SheepSupreme/AIAS/README.md

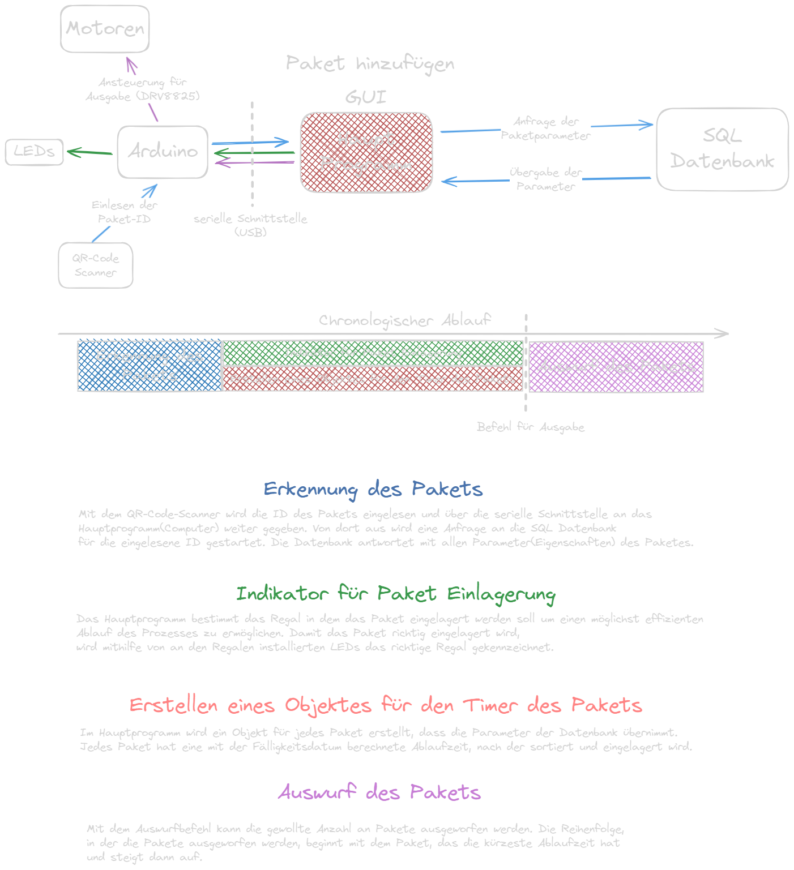
[picture p1: Dokumentationen/bin/Programm_Ablauf.png]
Programm Ablauf
