SheepSupreme/AIAS/Dokumentationen/range drawing.md

---

excalidraw-plugin: parsed
tags: [excalidraw]

---
==⚠  Switch to EXCALIDRAW VIEW in the MORE OPTIONS menu of this document. ⚠==

# Text Elements
Endstop  ^zTHHG58g

Endstop  ^R7NWYyii

Offset
 ^TklU1qga

if(absolute_position < 0 || absolute_position > endstop_position)
{
      out_ofRange();
} ^eQuNVsnZ

Out of range ^91QcKqwy

endstop_position ^cFNqHLJT

If _dir = -1 the maximum range allowed to travel is _endstop_distance and for the case _dir = 1
the max range is _current_position.   ^o1gS66gq

%%
# Drawing
```json
{
	"type": "excalidraw",
	"version": 2,
	"source": "https://github.com/zsviczian/obsidian-excalidraw-plugin/releases/tag/2.0.20",
	"elements": [
		{
			"type": "line",
			"version": 162,
			"versionNonce": 1674994351,
			"isDeleted": false,
			"id": "oIuLg_tYRnJQeL90HluUO",
			"fillStyle": "solid",
			"strokeWidth": 2,
			"strokeStyle": "solid",
			"roughness": 1,
			"opacity": 100,
			"angle": 0,
			"x": -387,
			"y": -297.25,
			"strokeColor": "#1e1e1e",
			"backgroundColor": "transparent",
			"width": 771,
			"height": 4,
			"seed": 1299669665,
			"groupIds": [],
			"frameId": null,
			"roundness": {
				"type": 2
			},
			"boundElements": [],
			"updated": 1707143066376,
			"link": null,
			"locked": false,
			"startBinding": null,
			"endBinding": null,
			"lastCommittedPoint": null,
			"startArrowhead": null,
			"endArrowhead": null,
			"points": [
				[
					0,
					0
				],
				[
					771,
					4
				]
			]
		},
		{
			"type": "rectangle",
			"version": 141,
			"versionNonce": 892969921,
			"isDeleted": false,
			"id": "d77W5BB7zodomcTw8jLMs",
			"fillStyle": "cross-hatch",
			"strokeWidth": 2,
			"strokeStyle": "solid",
			"roughness": 1,
			"opacity": 100,
			"angle": 0,
			"x": 248,
			"y": -317.25,
			"strokeColor": "#ffc9c9",
			"backgroundColor": "#ffc9c9",
			"width": 139,
			"height": 49,
			"seed": 1607139233,
			"groupIds": [],
			"frameId": null,
			"roundness": null,
			"boundElements": [],
			"updated": 1707143066376,
			"link": null,
			"locked": false
		},
		{
			"type": "text",
			"version": 60,
			"versionNonce": 1418005143,
			"isDeleted": false,
			"id": "zTHHG58g",
			"fillStyle": "cross-hatch",
			"strokeWidth": 2,
			"strokeStyle": "solid",
			"roughness": 1,
			"opacity": 100,
			"angle": 0,
			"x": 275,
			"y": -350.25,
			"strokeColor": "#ffc9c9",
			"backgroundColor": "#ffc9c9",
			"width": 87.2999267578125,
			"height": 25,
			"seed": 790835279,
			"groupIds": [],
			"frameId": null,
			"roundness": null,
			"boundElements": [],
			"updated": 1707643829991,
			"link": null,
			"locked": false,
			"fontSize": 20,
			"fontFamily": 1,
			"text": "Endstop ",
			"rawText": "Endstop ",
			"textAlign": "left",
			"verticalAlign": "top",
			"containerId": null,
			"originalText": "Endstop ",
			"lineHeight": 1.25,
			"baseline": 18
		},
		{
			"type": "text",
			"version": 189,
			"versionNonce": 1779945049,
			"isDeleted": false,
			"id": "R7NWYyii",
			"fillStyle": "cross-hatch",
			"strokeWidth": 2,
			"strokeStyle": "solid",
			"roughness": 1,
			"opacity": 100,
			"angle": 0,
			"x": -359.5,
			"y": -348.25,
			"strokeColor": "#ffc9c9",
			"backgroundColor": "#ffc9c9",
			"width": 87.2999267578125,
			"height": 25,
			"seed": 2118448495,
			"groupIds": [],
			"frameId": null,
			"roundness": null,
			"boundElements": [],
			"updated": 1707643829992,
			"link": null,
			"locked": false,
			"fontSize": 20,
			"fontFamily": 1,
			"text": "Endstop ",
			"rawText": "Endstop ",
			"textAlign": "left",
			"verticalAlign": "top",
			"containerId": null,
			"originalText": "Endstop ",
			"lineHeight": 1.25,
			"baseline": 18
		},
		{
			"type": "rectangle",
			"version": 97,
			"versionNonce": 1204994799,
			"isDeleted": false,
			"id": "_ohBsWteYg3jTnqSubWf3",
			"fillStyle": "cross-hatch",
			"strokeWidth": 2,
			"strokeStyle": "solid",
			"roughness": 1,
			"opacity": 100,
			"angle": 0,
			"x": -388,
			"y": -315.25,
			"strokeColor": "#ffc9c9",
			"backgroundColor": "#ffc9c9",
			"width": 133,
			"height": 45,
			"seed": 93808271,
			"groupIds": [],
			"frameId": null,
			"roundness": null,
			"boundElements": [],
			"updated": 1707143066376,
			"link": null,
			"locked": false
		},
		{
			"type": "line",
			"version": 174,
			"versionNonce": 1709336449,
			"isDeleted": false,
			"id": "LmhfvTvm5GQ5eU_dNBUte",
			"fillStyle": "cross-hatch",
			"strokeWidth": 4,
			"strokeStyle": "dotted",
			"roughness": 1,
			"opacity": 100,
			"angle": 0,
			"x": 243,
			"y": -287.25,
			"strokeColor": "#1971c2",
			"backgroundColor": "#ffc9c9",
			"width": 82,
			"height": 0,
			"seed": 608099375,
			"groupIds": [],
			"frameId": null,
			"roundness": null,
			"boundElements": [],
			"updated": 1707143066376,
			"link": null,
			"locked": false,
			"startBinding": null,
			"endBinding": null,
			"lastCommittedPoint": null,
			"startArrowhead": null,
			"endArrowhead": null,
			"points": [
				[
					0,
					0
				],
				[
					-82,
					0
				]
			]
		},
		{
			"type": "line",
			"version": 359,
			"versionNonce": 763006223,
			"isDeleted": false,
			"id": "8YLjzKsIzooisRLqhzNYY",
			"fillStyle": "cross-hatch",
			"strokeWidth": 4,
			"strokeStyle": "dotted",
			"roughness": 1,
			"opacity": 100,
			"angle": 0,
			"x": -166.5,
			"y": -288.0449695687963,
			"strokeColor": "#1971c2",
			"backgroundColor": "#ffc9c9",
			"width": 83,
			"height": 2,
			"seed": 1597740111,
			"groupIds": [],
			"frameId": null,
			"roundness": null,
			"boundElements": [],
			"updated": 1707143066376,
			"link": null,
			"locked": false,
			"startBinding": null,
			"endBinding": null,
			"lastCommittedPoint": null,
			"startArrowhead": null,
			"endArrowhead": null,
			"points": [
				[
					0,
					0
				],
				[
					-83,
					-2
				]
			]
		},
		{
			"type": "line",
			"version": 69,
			"versionNonce": 1728827233,
			"isDeleted": false,
			"id": "zCrVAdLew9wIEg2J9JabZ",
			"fillStyle": "cross-hatch",
			"strokeWidth": 4,
			"strokeStyle": "dashed",
			"roughness": 1,
			"opacity": 100,
			"angle": 0,
			"x": -160,
			"y": -340.25,
			"strokeColor": "#1e1e1e",
			"backgroundColor": "#ffc9c9",
			"width": 1,
			"height": 104,
			"seed": 944194895,
			"groupIds": [],
			"frameId": null,
			"roundness": null,
			"boundElements": [],
			"updated": 1707143066376,
			"link": null,
			"locked": false,
			"startBinding": null,
			"endBinding": null,
			"lastCommittedPoint": null,
			"startArrowhead": null,
			"endArrowhead": null,
			"points": [
				[
					0,
					0
				],
				[
					-1,
					104
				]
			]
		},
		{
			"type": "freedraw",
			"version": 113,
			"versionNonce": 1920809793,
			"isDeleted": false,
			"id": "2Ji5WvS61-Ri51Whbj6XT",
			"fillStyle": "cross-hatch",
			"strokeWidth": 1,
			"strokeStyle": "dashed",
			"roughness": 1,
			"opacity": 100,
			"angle": 0,
			"x": -250,
			"y": -231.25,
			"strokeColor": "#1e1e1e",
			"backgroundColor": "#ffc9c9",
			"width": 92,
			"height": 29,
			"seed": 1982078945,
			"groupIds": [],
			"frameId": null,
			"roundness": null,
			"boundElements": [],
			"updated": 1707143066376,
			"link": null,
			"locked": false,
			"points": [
				[
					0,
					0
				],
				[
					0,
					1
				],
				[
					0,
					2
				],
				[
					0,
					3
				],
				[
					0,
					4
				],
				[
					0,
					5
				],
				[
					0,
					6
				],
				[
					1,
					7
				],
				[
					2,
					8
				],
				[
					3,
					9
				],
				[
					3,
					10
				],
				[
					5,
					10
				],
				[
					6,
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
			"width": 1,
			"height": 104,
			"seed": 712223343,
			"groupIds": [],
			"frameId": null,
			"roundness": null,
			"boundElements": [],
			"updated": 1707143066376,
			"link": null,
			"locked": false,
			"startBinding": null,
			"endBinding": null,
			"lastCommittedPoint": null,
			"startArrowhead": null,
			"endArrowhead": null,
			"points": [
				[
					0,
					0
				],
				[
					-1,
					104
				]
			]
		},
		{
			"type": "text",
			"version": 201,
			"versionNonce": 2057214777,
			"isDeleted": false,
			"id": "eQuNVsnZ",
			"fillStyle": "cross-hatch",
			"strokeWidth": 1,
			"strokeStyle": "dashed",
			"roughness": 1,
			"opacity": 100,
			"angle": 0,
			"x": -383,
			"y": -56.650000000000006,
			"strokeColor": "#1e1e1e",
			"backgroundColor": "#ffc9c9",
			"width": 609.375,
			"height": 76.8,
			"seed": 634649551,
			"groupIds": [],
			"frameId": null,
			"roundness": null,
			"boundElements": [],
			"updated": 1707643829998,
			"link": null,
			"locked": false,
			"fontSize": 16,
			"fontFamily": 3,
			"text": "if(absolute_position < 0 || absolute_position > endstop_position)\n{\n      out_ofRange();\n}",
			"rawText": "if(absolute_position < 0 || absolute_position > endstop_position)\n{\n      out_ofRange();\n}",
			"textAlign": "left",
			"verticalAlign": "top",
			"containerId": null,
			"originalText": "if(absolute_position < 0 || absolute_position > endstop_position)\n{\n      out_ofRange();\n}",
			"lineHeight": 1.2,
			"baseline": 73
		},
		{
			"type": "text",
			"version": 65,
			"versionNonce": 2023133399,
			"isDeleted": false,
			"id": "91QcKqwy",
			"fillStyle": "cross-hatch",
			"strokeWidth": 1,
			"strokeStyle": "dashed",
			"roughness": 1,
			"opacity": 100,
			"angle": 0,
			"x": -135,
			"y": -134.25,
			"strokeColor": "#1e1e1e",
			"backgroundColor": "#ffc9c9",
			"width": 234.39593505859375,
			"height": 45,
			"seed": 1186888687,
			"groupIds": [],
			"frameId": null,
			"roundness": null,
			"boundElements": [],
			"updated": 1707643830000,
			"link": null,
			"locked": false,
			"fontSize": 36,
			"fontFamily": 1,
			"text": "Out of range",
			"rawText": "Out of range",
			"textAlign": "left",
			"verticalAlign": "top",
			"containerId": null,
			"originalText": "Out of range",
			"lineHeight": 1.25,
			"baseline": 31
		},
		{
			"type": "line",
			"version": 147,
			"versionNonce": 290816943,
			"isDeleted": false,
			"id": "g4YbKCmgGmhE3NAX9yFWu",
			"fillStyle": "cross-hatch",
			"strokeWidth": 2,
			"strokeStyle": "solid",
			"roughness": 1,
			"opacity": 100,
			"angle": 0,
			"x": -138,
			"y": -93.25,
			"strokeColor": "#e8590c",
			"backgroundColor": "#ffc9c9",
			"width": 240,
			"height": 2,
			"seed": 2039999887,
			"groupIds": [],
			"frameId": null,
			"roundness": null,
			"boundElements": [],
			"updated": 1707143066376,
			"link": null,
			"locked": false,
			"startBinding": null,
			"endBinding": null,
			"lastCommittedPoint": null,
			"startArrowhead": null,
			"endArrowhead": null,
			"points": [
				[
					0,
					0
				],
				[
					240,
					2
				]
			]
		},
		{
			"type": "text",
			"version": 223,
			"versionNonce": 1853410329,
			"isDeleted": false,
			"id": "cFNqHLJT",
			"fillStyle": "cross-hatch",
			"strokeWidth": 2,
			"strokeStyle": "solid",
			"roughness": 1,
			"opacity": 100,
			"angle": 0,
			"x": 223,
			"y": -210.25,
			"strokeColor": "#e8590c",
			"backgroundColor": "#ffc9c9",
			"width": 187.5,
			"height": 24,
			"seed": 715291215,
			"groupIds": [],
			"frameId": null,
			"roundness": null,
			"boundElements": [
				{
					"id": "nFXw3MjxVTKOJpjb4oJSQ",
					"type": "arrow"
				}
			],
			"updated": 1707643830001,
			"link": null,
			"locked": false,
			"fontSize": 20,
			"fontFamily": 3,
			"text": "endstop_position",
			"rawText": "endstop_position",
			"textAlign": "left",
			"verticalAlign": "top",
			"containerId": null,
			"originalText": "endstop_position",
			"lineHeight": 1.2,
			"baseline": 19
		},
		{
			"type": "arrow",
			"version": 484,
			"versionNonce": 1767600751,
			"isDeleted": false,
			"id": "nFXw3MjxVTKOJpjb4oJSQ",
			"fillStyle": "cross-hatch",
			"strokeWidth": 2,
			"strokeStyle": "solid",
			"roughness": 1,
			"opacity": 100,
			"angle": 0,
			"x": 212,
			"y": -200.24067697268845,
			"strokeColor": "#e8590c",
			"backgroundColor": "#ffc9c9",
			"width": 48,
			"height": 30.009323027311552,
			"seed": 1311047535,
			"groupIds": [],
			"frameId": null,
			"roundness": null,
			"boundElements": [],
			"updated": 1707143131136,
			"link": null,
			"locked": false,
			"startBinding": {
				"elementId": "cFNqHLJT",
				"focus": -0.8992587014644863,
				"gap": 11
			},
			"endBinding": null,
			"lastCommittedPoint": null,
			"startArrowhead": null,
			"endArrowhead": "arrow",
			"points": [
				[
					0,
					0
				],
				[
					-48,
					-30.009323027311552
				]
			]
		},
		{
			"type": "text",
			"version": 394,
			"versionNonce": 1801215479,
			"isDeleted": false,
			"id": "o1gS66gq",
			"fillStyle": "cross-hatch",
			"strokeWidth": 2,
			"strokeStyle": "solid",
			"roughness": 1,
			"opacity": 100,
			"angle": 0,
			"x": -385.3887600885677,
			"y": 39.69395715864888,
			"strokeColor": "#e8590c",
			"backgroundColor": "#ffc9c9",
			"width": 788.7034912109375,
			"height": 40,
			"seed": 1647622977,
			"groupIds": [],
			"frameId": null,
			"roundness": null,
			"boundElements": [],
			"updated": 1707643830005,
			"link": null,
			"locked": false,
			"fontSize": 16,
			"fontFamily": 1,
			"text": "If _dir = -1 the maximum range allowed to travel is _endstop_distance and for the case _dir = 1\nthe max range is _current_position.  ",
			"rawText": "If _dir = -1 the maximum range allowed to travel is _endstop_distance and for the case _dir = 1\nthe max range is _current_position.  ",
			"textAlign": "left",
			"verticalAlign": "top",
			"containerId": null,
			"originalText": "If _dir = -1 the maximum range allowed to travel is _endstop_distance and for the case _dir = 1\nthe max range is _current_position.  ",
			"lineHeight": 1.25,
			"baseline": 34
		}
	],
	"appState": {
		"theme": "dark",
		"viewBackgroundColor": "#ffffff",
		"currentItemStrokeColor": "#e8590c",
		"currentItemBackgroundColor": "#ffc9c9",
		"currentItemFillStyle": "cross-hatch",
		"currentItemStrokeWidth": 2,
		"currentItemStrokeStyle": "solid",
		"currentItemRoughness": 1,
		"currentItemOpacity": 100,
		"currentItemFontFamily": 1,
		"currentItemFontSize": 16,
		"currentItemTextAlign": "left",
		"currentItemStartArrowhead": null,
		"currentItemEndArrowhead": "arrow",
		"scrollX": 415.75465420838447,
		"scrollY": 543.121763791281,
		"zoom": {
			"value": 0.8
		},
		"currentItemRoundness": "sharp",
		"gridSize": null,
		"gridColor": {
			"Bold": "#C9C9C9FF",
			"Regular": "#EDEDEDFF"
		},
		"currentStrokeOptions": null,
		"previousGridSize": null,
		"frameRendering": {
			"enabled": true,
			"clip": true,
			"name": true,
			"outline": true
		}
	},
	"files": {}
}
```
%%
