SheepSupreme/AIAS/Dokumentationen/bin/Regalauslastung.md

---

excalidraw-plugin: parsed
tags: [excalidraw]

---
==⚠  Switch to EXCALIDRAW VIEW in the MORE OPTIONS menu of this document. ⚠==

# Text Elements
66% ^DweSzRlD

100% ^0yQBRq1t

33% ^cCDyKfaw

%%
# Drawing
```json
{
	"type": "excalidraw",
	"version": 2,
	"source": "https://github.com/zsviczian/obsidian-excalidraw-plugin/releases/tag/2.0.20",
	"elements": [
		{
			"id": "iGvxzgqr0_N8F7C8qXwpJ",
			"type": "rectangle",
			"x": -235.20004272460938,
			"y": -203.84374237060547,
			"width": 130.4000244140625,
			"height": 230.39999389648438,
			"angle": 0,
			"strokeColor": "#1e1e1e",
			"backgroundColor": "transparent",
			"fillStyle": "solid",
			"strokeWidth": 2,
			"strokeStyle": "solid",
			"roughness": 1,
			"opacity": 100,
			"groupIds": [],
			"frameId": null,
			"roundness": null,
			"seed": 1994287161,
			"version": 75,
			"versionNonce": 1768070871,
			"isDeleted": false,
			"boundElements": null,
			"updated": 1707647940653,
			"link": null,
			"locked": false
		},
		{
			"type": "rectangle",
			"version": 103,
			"versionNonce": 609369303,
			"isDeleted": false,
			"id": "fiVeXnyyB-yRo90R4QfPz",
			"fillStyle": "solid",
			"strokeWidth": 2,
			"strokeStyle": "solid",
			"roughness": 1,
			"opacity": 100,
			"angle": 0,
			"x": -91.00009155273438,
			"y": -206.44376373291016,
			"strokeColor": "#1e1e1e",
			"backgroundColor": "transparent",
			"width": 130.4000244140625,
			"height": 230.39999389648438,
			"seed": 1012441591,
			"groupIds": [],
			"frameId": null,
			"roundness": null,
			"boundElements": [],
			"updated": 1707647978609,
			"link": null,
			"locked": false
		},
		{
			"type": "rectangle",
			"version": 176,
			"versionNonce": 131553847,
			"isDeleted": false,
			"id": "UOiMkSwHQEAFL999IhhXo",
			"fillStyle": "solid",
			"strokeWidth": 2,
			"strokeStyle": "solid",
			"roughness": 1,
			"opacity": 100,
			"angle": 0,
			"x": 53.800018310546875,
			"y": -205.6437759399414,
			"strokeColor": "#1e1e1e",
			"backgroundColor": "transparent",
			"width": 130.4000244140625,
			"height": 230.39999389648438,
			"seed": 1563676727,
			"groupIds": [],
			"frameId": null,
			"roundness": null,
			"boundElements": [],
			"updated": 1707647945364,
			"link": null,
			"locked": false
		},
		{
			"id": "hxEmUlaA7C-nB6iEJte_a",
			"type": "rectangle",
			"x": -235.20004272460938,
			"y": -107.0437240600586,
			"width": 130.4000244140625,
			"height": 131.199951171875,
			"angle": 0,
			"strokeColor": "#1e1e1e",
			"backgroundColor": "#ffc9c9",
			"fillStyle": "cross-hatch",
			"strokeWidth": 2,
			"strokeStyle": "solid",
			"roughness": 1,
			"opacity": 100,
			"groupIds": [],
			"frameId": null,
			"roundness": null,
			"seed": 1429240119,
			"version": 82,
			"versionNonce": 1476420377,
			"isDeleted": false,
			"boundElements": [
				{
					"type": "text",
					"id": "DweSzRlD"
				}
			],
			"updated": 1707647952353,
			"link": null,
			"locked": false
		},
		{
			"id": "DweSzRlD",
			"type": "text",
			"x": -209.94202423095703,
			"y": -63.943748474121094,
			"width": 79.88398742675781,
			"height": 45,
			"angle": 0,
			"strokeColor": "#1e1e1e",
			"backgroundColor": "#ffc9c9",
			"fillStyle": "cross-hatch",
			"strokeWidth": 2,
			"strokeStyle": "solid",
			"roughness": 1,
			"opacity": 100,
			"groupIds": [],
			"frameId": null,
			"roundness": null,
			"seed": 1705970135,
			"version": 6,
			"versionNonce": 219774103,
			"isDeleted": false,
			"boundElements": null,
			"updated": 1707647957399,
			"link": null,
			"locked": false,
			"text": "66%",
			"rawText": "66%",
			"fontSize": 36,
			"fontFamily": 1,
			"textAlign": "center",
			"verticalAlign": "middle",
			"baseline": 31,
			"containerId": "hxEmUlaA7C-nB6iEJte_a",
			"originalText": "66%",
			"lineHeight": 1.25
		},
		{
			"id": "7SsU3MroDR_LRPZucwRKF",
			"type": "rectangle",
			"x": 55.199981689453125,
			"y": -203.84374237060547,
			"width": 127.20001220703125,
			"height": 229.5999755859375,
			"angle": 0,
			"strokeColor": "#1e1e1e",
			"backgroundColor": "#ffc9c9",
			"fillStyle": "cross-hatch",
			"strokeWidth": 2,
			"strokeStyle": "solid",
			"roughness": 1,
			"opacity": 100,
			"groupIds": [],
			"frameId": null,
			"roundness": null,
			"seed": 1748402903,
			"version": 68,
			"versionNonce": 1632591257,
			"isDeleted": false,
			"boundElements": [
				{
					"type": "text",
					"id": "0yQBRq1t"
				}
			],
			"updated": 1707647971544,
			"link": null,
			"locked": false
		},
		{
			"id": "0yQBRq1t",
			"type": "text",
			"x": 72.25199890136719,
			"y": -111.54375457763672,
			"width": 93.09597778320312,
			"height": 45,
			"angle": 0,
			"strokeColor": "#1e1e1e",
			"backgroundColor": "#ffc9c9",
			"fillStyle": "cross-hatch",
			"strokeWidth": 2,
			"strokeStyle": "solid",
			"roughness": 1,
			"opacity": 100,
			"groupIds": [],
			"frameId": null,
			"roundness": null,
			"seed": 470984535,
			"version": 5,
			"versionNonce": 94682617,
			"isDeleted": false,
			"boundElements": null,
			"updated": 1707647974081,
			"link": null,
			"locked": false,
			"text": "100%",
			"rawText": "100%",
			"fontSize": 36,
			"fontFamily": 1,
			"textAlign": "center",
			"verticalAlign": "middle",
			"baseline": 31,
			"containerId": "7SsU3MroDR_LRPZucwRKF",
			"originalText": "100%",
			"lineHeight": 1.25
		},
		{
			"id": "K8pDpNvs0RcXgGTrhRLzR",
			"type": "rectangle",
			"x": -90.39999389648438,
			"y": -44.643760681152344,
			"width": 127.199951171875,
			"height": 67.20001220703125,
			"angle": 0,
			"strokeColor": "#1e1e1e",
			"backgroundColor": "#ffc9c9",
			"fillStyle": "cross-hatch",
			"strokeWidth": 2,
			"strokeStyle": "solid",
			"roughness": 1,
			"opacity": 100,
			"groupIds": [],
			"frameId": null,
			"roundness": null,
			"seed": 1944859415,
			"version": 54,
			"versionNonce": 2016149785,
			"isDeleted": false,
			"boundElements": [
				{
					"type": "text",
					"id": "cCDyKfaw"
				}
			],
			"updated": 1707648003065,
			"link": null,
			"locked": false
		},
		{
			"id": "cCDyKfaw",
			"type": "text",
			"x": -68.21800994873047,
			"y": -33.54375457763672,
			"width": 82.83598327636719,
			"height": 45,
			"angle": 0,
			"strokeColor": "#1e1e1e",
			"backgroundColor": "#ffc9c9",
			"fillStyle": "cross-hatch",
			"strokeWidth": 2,
			"strokeStyle": "solid",
			"roughness": 1,
			"opacity": 100,
			"groupIds": [],
			"frameId": null,
			"roundness": null,
			"seed": 1242860503,
			"version": 4,
			"versionNonce": 361376921,
			"isDeleted": false,
			"boundElements": null,
			"updated": 1707648005339,
			"link": null,
			"locked": false,
			"text": "33%",
			"rawText": "33%",
			"fontSize": 36,
			"fontFamily": 1,
			"textAlign": "center",
			"verticalAlign": "middle",
			"baseline": 31,
			"containerId": "K8pDpNvs0RcXgGTrhRLzR",
			"originalText": "33%",
			"lineHeight": 1.25
		}
	],
	"appState": {
		"theme": "dark",
		"viewBackgroundColor": "#ffffff",
		"currentItemStrokeColor": "#1e1e1e",
		"currentItemBackgroundColor": "#ffc9c9",
		"currentItemFillStyle": "cross-hatch",
		"currentItemStrokeWidth": 2,
		"currentItemStrokeStyle": "solid",
		"currentItemRoughness": 1,
		"currentItemOpacity": 100,
		"currentItemFontFamily": 1,
		"currentItemFontSize": 36,
		"currentItemTextAlign": "left",
		"currentItemStartArrowhead": null,
		"currentItemEndArrowhead": "arrow",
		"scrollX": 584.2000122070312,
		"scrollY": 371.7562561035156,
		"zoom": {
			"value": 1
		},
		"currentItemRoundness": "sharp",
		"gridSize": null,
		"gridColor": {
			"Bold": "#C9C9C9FF",
			"Regular": "#EDEDEDFF"
		},
		"currentStrokeOptions": null,
		"previousGridSize": null,
		"frameRendering": {
			"enabled": true,
			"clip": true,
			"name": true,
			"outline": true
		}
	},
	"files": {}
}
```
%%
