SheepSupreme/AIAS/conflict-files-obsidian-git.md

# Conflicts
Please resolve them and commit them using the commands `Git: Commit all changes` followed by `Git: Push`
(This file will automatically be deleted before commit)
[[#Additional Instructions]] available below file list

- Not a file: .obsidian/workspace.json
- [[Programm Ablauf]]
- Not a file: sketch_jan10a/AKS/src/.vscode/settings.json
- [[timer.py]]

# Additional Instructions
I strongly recommend to use "Source mode" for viewing the conflicted files. For simple conflicts, in each file listed above replace every occurrence of the following text blocks with the desired text.

```diff
<<<<<<< HEAD
    File changes in local repository
=======
    File changes in remote repository
>>>>>>> origin/main
```
