SheepSupreme/AIAS/Drawing 2024-04-16 21.37.46.excalidraw.md

---

excalidraw-plugin: parsed
tags: [excalidraw]

---
==⚠  Switch to EXCALIDRAW VIEW in the MORE OPTIONS menu of this document. ⚠==

# Text Elements
Annäherungsphase ^f5flp4kH

Sicherheitsabstandeinstellung ^RdX0JzO4

t ^AJXwN7ex

Prellen ^6SSrgGkD

Rückziehungsphase ^0LVD94QP

Flanke erkannt
Schleifenbeginn ^1ofx0jkZ

100ms ^HXgCmdYD

38ms ^nZAon1Bs

DEBOUNCE_DELAY > 100ms
Schleifenende ^42ApAkKs

Dauer des Prellens ^RBMbONDH

%%
# Drawing
```json
{
	"type": "excalidraw",
	"version": 2,
	"source": "https://github.com/zsviczian/obsidian-excalidraw-plugin/releases/tag/2.0.20",
	"elements": [
		{
			"type": "line",
			"version": 763,
			"versionNonce": 1403566506,
			"isDeleted": false,
			"id": "CgW8tRpCIwJtJrZXU7FRV",
			"fillStyle": "solid",
			"strokeWidth": 2,
			"strokeStyle": "dashed",
			"roughness": 0,
			"opacity": 100,
			"angle": 0,
			"x": 238.77804319641035,
			"y": 284.57651348424855,
			"strokeColor": "#1971c2",
			"backgroundColor": "#f08c00",
			"width": 1.8630482314217147,
			"height": 187.38856810940263,
			"seed": 373714934,
			"groupIds": [],
			"frameId": null,
			"roundness": null,
			"boundElements": [],
			"updated": 1713353040744,
			"link": null,
			"locked": false,
			"startBinding": null,
			"endBinding": null,
			"lastCommittedPoint": null,
			"startArrowhead": null,
			"endArrowhead": null,
			"points": [
				[
					0,
					0
				],
				[
					1.8630482314217147,
					187.38856810940263
				]
			]
		},
		{
			"type": "line",
			"version": 153,
			"versionNonce": 597200374,
			"isDeleted": false,
			"id": "wvXh0QOTqUDLNf5rbeEFG",
			"fillStyle": "hachure",
			"strokeWidth": 2,
			"strokeStyle": "solid",
			"roughness": 0,
			"opacity": 100,
			"angle": 0,
			"x": 103.91862260541508,
			"y": 50.493296100001174,
			"strokeColor": "#1971c2",
			"backgroundColor": "transparent",
			"width": 0.27036432340266003,
			"height": 32.984051418469946,
			"seed": 832642963,
			"groupIds": [],
			"frameId": null,
			"roundness": null,
			"boundElements": [],
			"updated": 1713353040744,
			"link": null,
			"locked": false,
			"startBinding": null,
			"endBinding": null,
			"lastCommittedPoint": null,
			"startArrowhead": null,
			"endArrowhead": null,
			"points": [
				[
					0,
					0
				],
				[
					0.27036432340266003,
					-32.984051418469946
				]
			]
		},
		{
			"type": "rectangle",
			"version": 204,
			"versionNonce": 1786246250,
			"isDeleted": false,
			"id": "cpRzqwfpWM3yE4gJYXcSC",
			"fillStyle": "solid",
			"strokeWidth": 4,
			"strokeStyle": "solid",
			"roughness": 0,
			"opacity": 100,
			"angle": 0,
			"x": -286.1653594970703,
			"y": -124.05598449707031,
			"strokeColor": "#1e1e1e",
			"backgroundColor": "transparent",
			"width": 646.6666717529297,
			"height": 40.83332824707031,
			"seed": 1693497267,
			"groupIds": [],
			"frameId": null,
			"roundness": null,
			"boundElements": [],
			"updated": 1713353040744,
			"link": null,
			"locked": false
		},
		{
			"type": "rectangle",
			"version": 688,
			"versionNonce": 276782902,
			"isDeleted": false,
			"id": "OzmO8qNJMEK3aNJf2Xilk",
			"fillStyle": "solid",
			"strokeWidth": 0.5,
			"strokeStyle": "solid",
			"roughness": 0,
			"opacity": 100,
			"angle": 0,
			"x": -286.16535875767585,
			"y": -124.055984,
			"strokeColor": "transparent",
			"backgroundColor": "#ff8787",
			"width": 204.45311575767585,
			"height": 40.312488,
			"seed": 1280888061,
			"groupIds": [],
			"frameId": null,
			"roundness": null,
			"boundElements": [
				{
					"type": "text",
					"id": "f5flp4kH"
				}
			],
			"updated": 1713353040744,
			"link": null,
			"locked": false
		},
		{
			"type": "text",
			"version": 425,
			"versionNonce": 1091688234,
			"isDeleted": false,
			"id": "f5flp4kH",
			"fillStyle": "hachure",
			"strokeWidth": 1,
			"strokeStyle": "solid",
			"roughness": 0,
			"opacity": 100,
			"angle": 0,
			"x": -258.9388008788379,
			"y": -113.49973999999999,
			"strokeColor": "#1e1e1e",
			"backgroundColor": "#2f9e44",
			"width": 150,
			"height": 19.2,
			"seed": 704749043,
			"groupIds": [],
			"frameId": null,
			"roundness": null,
			"boundElements": [],
			"updated": 1713353040744,
			"link": null,
			"locked": false,
			"fontSize": 16,
			"fontFamily": 3,
			"text": "Annäherungsphase",
			"rawText": "Annäherungsphase",
			"textAlign": "center",
			"verticalAlign": "middle",
			"containerId": "OzmO8qNJMEK3aNJf2Xilk",
			"originalText": "Annäherungsphase",
			"lineHeight": 1.2,
			"baseline": 15
		},
		{
			"type": "rectangle",
			"version": 462,
			"versionNonce": 1928988790,
			"isDeleted": false,
			"id": "65dOxuFTLV3p1MlCWzpoy",
			"fillStyle": "solid",
			"strokeWidth": 1,
			"strokeStyle": "solid",
			"roughness": 0,
			"opacity": 100,
			"angle": 0,
			"x": -81.712243,
			"y": -124.055984,
			"strokeColor": "transparent",
			"backgroundColor": "#4dabf7",
			"width": 36.458359,
			"height": 40.31248823535155,
			"seed": 842314899,
			"groupIds": [],
			"frameId": null,
			"roundness": null,
			"boundElements": [],
			"updated": 1713353040744,
			"link": null,
			"locked": false
		},
		{
			"type": "rectangle",
			"version": 458,
			"versionNonce": 1474388458,
			"isDeleted": false,
			"id": "vT7hVDBoANe0V4I83tv5T",
			"fillStyle": "solid",
			"strokeWidth": 0.5,
			"strokeStyle": "solid",
			"roughness": 0,
			"opacity": 100,
			"angle": 0,
			"x": -45.253884,
			"y": -124.055984,
			"strokeColor": "transparent",
			"backgroundColor": "#f08c00",
			"width": 64.434314,
			"height": 40.483390960577154,
			"seed": 1218468349,
			"groupIds": [],
			"frameId": null,
			"roundness": null,
			"boundElements": [
				{
					"id": "SIN99Q6dCiXtwufJJhFK3",
					"type": "arrow"
				}
			],
			"updated": 1713353040744,
			"link": null,
			"locked": false
		},
		{
			"type": "rectangle",
			"version": 500,
			"versionNonce": 449677750,
			"isDeleted": false,
			"id": "-THiHJQGB3vLGRFvAnVFN",
			"fillStyle": "solid",
			"strokeWidth": 0.5,
			"strokeStyle": "solid",
			"roughness": 0,
			"opacity": 100,
			"angle": 0,
			"x": 19.18043,
			"y": -124.055984,
			"strokeColor": "transparent",
			"backgroundColor": "#4dabf7",
			"width": 36.882757999999995,
			"height": 40.312488,
			"seed": 65719101,
			"groupIds": [],
			"frameId": null,
			"roundness": null,
			"boundElements": [],
			"updated": 1713353040744,
			"link": null,
			"locked": false
		},
		{
			"type": "rectangle",
			"version": 240,
			"versionNonce": 1777439914,
			"isDeleted": false,
			"id": "7sAOaXC6pyA4ir2ZvAnz6",
			"fillStyle": "solid",
			"strokeWidth": 0.5,
			"strokeStyle": "solid",
			"roughness": 0,
			"opacity": 100,
			"angle": 0,
			"x": 56.06318799999997,
			"y": -124.055984,
			"strokeColor": "transparent",
			"backgroundColor": "#69db7c",
			"width": 304.438124,
			"height": 40.312488,
			"seed": 704475581,
			"groupIds": [],
			"frameId": null,
			"roundness": null,
			"boundElements": [
				{
					"type": "text",
					"id": "RdX0JzO4"
				}
			],
			"updated": 1713353040744,
			"link": null,
			"locked": false
		},
		{
			"type": "text",
			"version": 214,
			"versionNonce": 387900150,
			"isDeleted": false,
			"id": "RdX0JzO4",
			"fillStyle": "hachure",
			"strokeWidth": 1,
			"strokeStyle": "solid",
			"roughness": 0,
			"opacity": 100,
			"angle": 0,
			"x": 72.34474999999998,
			"y": -113.49973999999999,
			"strokeColor": "#1e1e1e",
			"backgroundColor": "#2f9e44",
			"width": 271.875,
			"height": 19.2,
			"seed": 1102914717,
			"groupIds": [],
			"frameId": null,
			"roundness": null,
			"boundElements": [],
			"updated": 1713353040744,
			"link": null,
			"locked": false,
			"fontSize": 16,
			"fontFamily": 3,
			"text": "Sicherheitsabstandeinstellung",
			"rawText": "Sicherheitsabstandeinstellung",
			"textAlign": "center",
			"verticalAlign": "middle",
			"containerId": "7sAOaXC6pyA4ir2ZvAnz6",
			"originalText": "Sicherheitsabstandeinstellung",
			"lineHeight": 1.2,
			"baseline": 15
		},
		{
			"type": "freedraw",
			"version": 107,
			"versionNonce": 418213738,
			"isDeleted": false,
			"id": "tyoDV9lV7UZh7BQpFheHy",
			"fillStyle": "hachure",
			"strokeWidth": 1,
			"strokeStyle": "solid",
			"roughness": 0,
			"opacity": 100,
			"angle": 0,
			"x": -49.067406149410544,
			"y": -74.79441581100846,
			"strokeColor": "transparent",
			"backgroundColor": "#2f9e44",
			"width": 67.4603271484375,
			"height": 63.492053803943435,
			"seed": 2047059763,
			"groupIds": [],
			"frameId": null,
			"roundness": null,
			"boundElements": [],
			"updated": 1713353040744,
			"link": null,
			"locked": false,
			"points": [
				[
					0,
					0
				],
				[
					0.7936604817708712,
					0
				],
				[
					1.5873209635416856,
					0
				],
				[
					2.380952380952408,
					0
				],
				[
					3.1746128627232224,
					0.793631417410694
				],
				[
					3.968273344494037,
					0.793631417410694
				],
				[
					4.761904761904759,
					2.3809523809523796
				],
				[
					7.142857142857167,
					3.9682442801339164
				],
				[
					7.936517624627982,
					5.555536179315453
				],
				[
					9.523809523809518,
					7.936488560267833
				],
				[
					11.111130487351204,
					10.317440941220212
				],
				[
					11.904761904761926,
					11.904761904761898
				],
				[
					13.492082868303612,
					12.698393322172592
				],
				[
					14.285714285714278,
					13.492053803943435
				],
				[
					14.285714285714278,
					15.079345703124972
				],
				[
					15.873035249255963,
					15.079345703124972
				],
				[
					16.666666666666686,
					15.873006184895814
				],
				[
					18.25398763020837,
					16.666666666666657
				],
				[
					19.047619047619037,
					17.46029808407738
				],
				[
					20.634940011160722,
					17.46029808407738
				],
				[
					21.428571428571445,
					17.46029808407738
				],
				[
					23.809523809523796,
					17.46029808407738
				],
				[
					25.39684477306548,
					18.253958565848194
				],
				[
					26.190476190476204,
					18.253958565848194
				],
				[
					27.77779715401789,
					19.047619047619037
				],
				[
					29.365089053199426,
					19.047619047619037
				],
				[
					30.952380952380963,
					19.84125046502976
				],
				[
					32.53970191592265,
					19.84125046502976
				],
				[
					34.126993815104186,
					19.84125046502976
				],
				[
					35.71428571428572,
					20.634910946800574
				],
				[
					38.09523809523813,
					21.428571428571416
				],
				[
					38.888898577008945,
					21.428571428571416
				],
				[
					40.47619047619048,
					22.22220284598214
				],
				[
					42.85714285714289,
					22.22220284598214
				],
				[
					44.44446382068452,
					22.22220284598214
				],
				[
					45.23809523809524,
					23.015863327752953
				],
				[
					47.61904761904765,
					23.809523809523796
				],
				[
					49.20636858258928,
					23.809523809523796
				],
				[
					50,
					24.60315522693452
				],
				[
					51.587320963541686,
					25.396815708705333
				],
				[
					52.38095238095241,
					26.984107607886898
				],
				[
					53.17461286272322,
					28.571428571428584
				],
				[
					53.96827334449404,
					29.36505998883925
				],
				[
					54.76190476190476,
					30.15872047061012
				],
				[
					55.55556524367563,
					31.746012369791657
				],
				[
					56.349225725446445,
					32.53967285156247
				],
				[
					57.14285714285717,
					34.12696475074401
				],
				[
					57.93651762462798,
					35.714285714285694
				],
				[
					57.93651762462798,
					36.507917131696416
				],
				[
					58.730178106398796,
					36.507917131696416
				],
				[
					59.52380952380952,
					38.0952380952381
				],
				[
					60.31747000558039,
					38.88886951264877
				],
				[
					61.111130487351204,
					40.47619047619045
				],
				[
					61.904761904761926,
					41.269821893601176
				],
				[
					63.492082868303555,
					43.650774274553584
				],
				[
					64.28571428571428,
					45.23809523809521
				],
				[
					65.87303524925596,
					48.41267903645834
				],
				[
					65.87303524925596,
					49.20633951822916
				],
				[
					66.66666666666669,
					50.793631417410694
				],
				[
					66.66666666666669,
					52.38095238095238
				],
				[
					67.4603271484375,
					53.1745837983631
				],
				[
					67.4603271484375,
					54.76190476190473
				],
				[
					67.4603271484375,
					55.55553617931545
				],
				[
					67.4603271484375,
					56.34919666108627
				],
				[
					67.4603271484375,
					57.14285714285714
				],
				[
					67.4603271484375,
					57.93648856026786
				],
				[
					67.4603271484375,
					58.730149042038676
				],
				[
					67.4603271484375,
					59.52380952380949
				],
				[
					67.4603271484375,
					60.31744094122021
				],
				[
					66.66666666666669,
					61.11110142299103
				],
				[
					66.66666666666669,
					61.9047619047619
				],
				[
					66.66666666666669,
					62.69839332217262
				],
				[
					66.66666666666669,
					63.492053803943435
				],
				[
					65.87303524925596,
					63.492053803943435
				],
				[
					65.07937476748515,
					63.492053803943435
				],
				[
					65.07937476748515,
					63.492053803943435
				]
			],
			"lastCommittedPoint": null,
			"simulatePressure": true,
			"pressures": []
		},
		{
			"type": "arrow",
			"version": 1444,
			"versionNonce": 1249055798,
			"isDeleted": false,
			"id": "1VW16dpWHd2BdImqItgEs",
			"fillStyle": "hachure",
			"strokeWidth": 1,
			"strokeStyle": "solid",
			"roughness": 0,
			"opacity": 100,
			"angle": 0,
			"x": -305.9630804858539,
			"y": -133.65898921842845,
			"strokeColor": "#1e1e1e",
			"backgroundColor": "#2f9e44",
			"width": 691.6217394549499,
			"height": 1.3566273428691602,
			"seed": 14492915,
			"groupIds": [],
			"frameId": null,
			"roundness": null,
			"boundElements": [],
			"updated": 1713353040744,
			"link": null,
			"locked": false,
			"startBinding": null,
			"endBinding": {
				"elementId": "AJXwN7ex",
				"focus": 1.417464006836883,
				"gap": 4.0306230314067975
			},
			"lastCommittedPoint": null,
			"startArrowhead": null,
			"endArrowhead": "triangle",
			"points": [
				[
					0,
					0
				],
				[
					691.6217394549499,
					1.3566273428691602
				]
			]
		},
		{
			"type": "text",
			"version": 40,
			"versionNonce": 421524010,
			"isDeleted": false,
			"id": "AJXwN7ex",
			"fillStyle": "hachure",
			"strokeWidth": 1,
			"strokeStyle": "solid",
			"roughness": 0,
			"opacity": 100,
			"angle": 0,
			"x": 386.0363933989654,
			"y": -128.27173884415248,
			"strokeColor": "#1e1e1e",
			"backgroundColor": "#2f9e44",
			"width": 9.375,
			"height": 19.2,
			"seed": 688529651,
			"groupIds": [],
			"frameId": null,
			"roundness": null,
			"boundElements": [
				{
					"id": "1VW16dpWHd2BdImqItgEs",
					"type": "arrow"
				}
			],
			"updated": 1713353040744,
			"link": null,
			"locked": false,
			"fontSize": 16,
			"fontFamily": 3,
			"text": "t",
			"rawText": "t",
			"textAlign": "left",
			"verticalAlign": "top",
			"containerId": null,
			"originalText": "t",
			"lineHeight": 1.2,
			"baseline": 15
		},
		{
			"type": "text",
			"version": 1058,
			"versionNonce": 2125405558,
			"isDeleted": false,
			"id": "6SSrgGkD",
			"fillStyle": "hachure",
			"strokeWidth": 1,
			"strokeStyle": "solid",
			"roughness": 0,
			"opacity": 100,
			"angle": 0,
			"x": -48.68529617723652,
			"y": -54.492760810295465,
			"strokeColor": "#1e1e1e",
			"backgroundColor": "#2f9e44",
			"width": 65.625,
			"height": 19.2,
			"seed": 2064244445,
			"groupIds": [],
			"frameId": null,
			"roundness": null,
			"boundElements": [
				{
					"id": "SIN99Q6dCiXtwufJJhFK3",
					"type": "arrow"
				},
				{
					"id": "HgjzGG4w86GzcN9TFxufE",
					"type": "arrow"
				}
			],
			"updated": 1713353040744,
			"link": null,
			"locked": false,
			"fontSize": 16,
			"fontFamily": 3,
			"text": "Prellen",
			"rawText": "Prellen",
			"textAlign": "left",
			"verticalAlign": "top",
			"containerId": null,
			"originalText": "Prellen",
			"lineHeight": 1.2,
			"baseline": 15
		},
		{
			"type": "text",
			"version": 246,
			"versionNonce": 1567890666,
			"isDeleted": false,
			"id": "0LVD94QP",
			"fillStyle": "hachure",
			"strokeWidth": 1,
			"strokeStyle": "solid",
			"roughness": 0,
			"opacity": 100,
			"angle": 0,
			"x": -104.44637042266035,
			"y": -177.31420152983088,
			"strokeColor": "#1e1e1e",
			"backgroundColor": "#2f9e44",
			"width": 159.375,
			"height": 19.2,
			"seed": 561701523,
			"groupIds": [],
			"frameId": null,
			"roundness": null,
			"boundElements": [
				{
					"id": "CwlVT1xubhBaUoCBKfrFO",
					"type": "arrow"
				}
			],
			"updated": 1713353040744,
			"link": null,
			"locked": false,
			"fontSize": 16,
			"fontFamily": 3,
			"text": "Rückziehungsphase",
			"rawText": "Rückziehungsphase",
			"textAlign": "left",
			"verticalAlign": "top",
			"containerId": null,
			"originalText": "Rückziehungsphase",
			"lineHeight": 1.2,
			"baseline": 15
		},
		{
			"type": "arrow",
			"version": 433,
			"versionNonce": 2031615670,
			"isDeleted": false,
			"id": "CwlVT1xubhBaUoCBKfrFO",
			"fillStyle": "hachure",
			"strokeWidth": 2,
			"strokeStyle": "solid",
			"roughness": 0,
			"opacity": 100,
			"angle": 0,
			"x": -29.381868568522766,
			"y": -152.05389546176417,
			"strokeColor": "#1e1e1e",
			"backgroundColor": "#2f9e44",
			"width": 16.704672151205063,
			"height": 45.880698804974145,
			"seed": 749327603,
			"groupIds": [],
			"frameId": null,
			"roundness": null,
			"boundElements": [],
			"updated": 1713353040744,
			"link": null,
			"locked": false,
			"startBinding": {
				"elementId": "0LVD94QP",
				"focus": 0.12412125492520602,
				"gap": 6.060306068066723
			},
			"endBinding": null,
			"lastCommittedPoint": null,
			"startArrowhead": null,
			"endArrowhead": "triangle",
			"points": [
				[
					0,
					0
				],
				[
					16.704672151205063,
					45.880698804974145
				]
			]
		},
		{
			"type": "arrow",
			"version": 607,
			"versionNonce": 1131737002,
			"isDeleted": false,
			"id": "SIN99Q6dCiXtwufJJhFK3",
			"fillStyle": "hachure",
			"strokeWidth": 2,
			"strokeStyle": "solid",
			"roughness": 0,
			"opacity": 100,
			"angle": 0,
			"x": -12.560105689829996,
			"y": -56.0665584786243,
			"strokeColor": "#1e1e1e",
			"backgroundColor": "#2f9e44",
			"width": 48.386389520173864,
			"height": 47.442144817209936,
			"seed": 347659485,
			"groupIds": [],
			"frameId": null,
			"roundness": null,
			"boundElements": [],
			"updated": 1713353040744,
			"link": null,
			"locked": false,
			"startBinding": {
				"elementId": "JwVG0VW8lpRRcz1jEdepb",
				"focus": 0.42172664963161516,
				"gap": 12.689385305903187
			},
			"endBinding": null,
			"lastCommittedPoint": null,
			"startArrowhead": null,
			"endArrowhead": "triangle",
			"points": [
				[
					0,
					0
				],
				[
					48.386389520173864,
					-47.442144817209936
				]
			]
		},
		{
			"type": "arrow",
			"version": 710,
			"versionNonce": 240302070,
			"isDeleted": false,
			"id": "HgjzGG4w86GzcN9TFxufE",
			"fillStyle": "hachure",
			"strokeWidth": 2,
			"strokeStyle": "solid",
			"roughness": 0,
			"opacity": 100,
			"angle": 0,
			"x": -15.870373375937533,
			"y": -56.34233865159746,
			"strokeColor": "#1e1e1e",
			"backgroundColor": "#2f9e44",
			"width": 46.03046308153567,
			"height": 44.6421798465384,
			"seed": 253428541,
			"groupIds": [],
			"frameId": null,
			"roundness": null,
			"boundElements": [],
			"updated": 1713353040745,
			"link": null,
			"locked": false,
			"startBinding": {
				"elementId": "JwVG0VW8lpRRcz1jEdepb",
				"focus": -0.4802420942891856,
				"gap": 12.41360513293003
			},
			"endBinding": null,
			"lastCommittedPoint": null,
			"startArrowhead": null,
			"endArrowhead": "triangle",
			"points": [
				[
					0,
					0
				],
				[
					-46.03046308153567,
					-44.6421798465384
				]
			]
		},
		{
			"type": "rectangle",
			"version": 452,
			"versionNonce": 1062038122,
			"isDeleted": false,
			"id": "JwVG0VW8lpRRcz1jEdepb",
			"fillStyle": "hachure",
			"strokeWidth": 2,
			"strokeStyle": "dashed",
			"roughness": 0,
			"opacity": 100,
			"angle": 0,
			"x": -86.32363844643717,
			"y": -137.8295913145837,
			"strokeColor": "#1e1e1e",
			"backgroundColor": "transparent",
			"width": 150.62628177889468,
			"height": 69.0736475300562,
			"seed": 507812211,
			"groupIds": [],
			"frameId": null,
			"roundness": null,
			"boundElements": [
				{
					"id": "HgjzGG4w86GzcN9TFxufE",
					"type": "arrow"
				},
				{
					"id": "O4k1kuasB-hDkCA-f-2DO",
					"type": "arrow"
				},
				{
					"id": "CwlVT1xubhBaUoCBKfrFO",
					"type": "arrow"
				},
				{
					"id": "SIN99Q6dCiXtwufJJhFK3",
					"type": "arrow"
				}
			],
			"updated": 1713353040745,
			"link": null,
			"locked": false
		},
		{
			"type": "arrow",
			"version": 1322,
			"versionNonce": 912542006,
			"isDeleted": false,
			"id": "O4k1kuasB-hDkCA-f-2DO",
			"fillStyle": "hachure",
			"strokeWidth": 2,
			"strokeStyle": "dashed",
			"roughness": 0,
			"opacity": 100,
			"angle": 0,
			"x": -85.09027766375307,
			"y": -66.26133154764226,
			"strokeColor": "#1e1e1e",
			"backgroundColor": "transparent",
			"width": 39.281971868240575,
			"height": 68.10181344770004,
			"seed": 1973535581,
			"groupIds": [],
			"frameId": null,
			"roundness": null,
			"boundElements": [],
			"updated": 1713353040745,
			"link": null,
			"locked": false,
			"startBinding": {
				"elementId": "JwVG0VW8lpRRcz1jEdepb",
				"focus": 0.5532287019930913,
				"gap": 2.4946122368852315
			},
			"endBinding": {
				"elementId": "Yb6jPoQsMYy9fHt_kaVjH",
				"focus": -0.5509607092214998,
				"gap": 9.061026386489857
			},
			"lastCommittedPoint": null,
			"startArrowhead": null,
			"endArrowhead": "triangle",
			"points": [
				[
					0,
					0
				],
				[
					-39.281971868240575,
					68.10181344770004
				]
			]
		},
		{
			"type": "rectangle",
			"version": 1085,
			"versionNonce": 130583850,
			"isDeleted": false,
			"id": "Yb6jPoQsMYy9fHt_kaVjH",
			"fillStyle": "hachure",
			"strokeWidth": 2,
			"strokeStyle": "dashed",
			"roughness": 0,
			"opacity": 100,
			"angle": 0,
			"x": -265.03315152164816,
			"y": 10.901508286547639,
			"strokeColor": "#1e1e1e",
			"backgroundColor": "transparent",
			"width": 575.6792291424372,
			"height": 47.74378331357572,
			"seed": 1189669245,
			"groupIds": [],
			"frameId": null,
			"roundness": null,
			"boundElements": [
				{
					"id": "O4k1kuasB-hDkCA-f-2DO",
					"type": "arrow"
				}
			],
			"updated": 1713353040745,
			"link": null,
			"locked": false
		},
		{
			"type": "line",
			"version": 609,
			"versionNonce": 548516470,
			"isDeleted": false,
			"id": "adq4ggL-soCX58L8bXC1H",
			"fillStyle": "hachure",
			"strokeWidth": 2,
			"strokeStyle": "solid",
			"roughness": 0,
			"opacity": 100,
			"angle": 0,
			"x": -199.42298107007244,
			"y": 48.41266561280639,
			"strokeColor": "#1971c2",
			"backgroundColor": "transparent",
			"width": 20.93215672203749,
			"height": 30.343984343205534,
			"seed": 1570393533,
			"groupIds": [],
			"frameId": null,
			"roundness": null,
			"boundElements": [],
			"updated": 1713353040745,
			"link": null,
			"locked": false,
			"startBinding": null,
			"endBinding": null,
			"lastCommittedPoint": null,
			"startArrowhead": null,
			"endArrowhead": null,
			"points": [
				[
					0,
					0
				],
				[
					9.73022707357377,
					-0.27760717350486175
				],
				[
					9.73022707357377,
					-30.343984343205534
				],
				[
					20.389954127163442,
					-30.343984343205534
				],
				[
					20.389954127163442,
					-0.27760717350486175
				],
				[
					20.93215672203749,
					-0.27760717350486175
				]
			]
		},
		{
			"type": "line",
			"version": 616,
			"versionNonce": 1112627178,
			"isDeleted": false,
			"id": "S1gxCwMoBbfI5jiSoMumV",
			"fillStyle": "hachure",
			"strokeWidth": 2,
			"strokeStyle": "solid",
			"roughness": 0,
			"opacity": 100,
			"angle": 0,
			"x": -178.92273982618997,
			"y": 49.15479543516733,
			"strokeColor": "#1971c2",
			"backgroundColor": "transparent",
			"width": 21.959381245857827,
			"height": 30.343984343205534,
			"seed": 1816039101,
			"groupIds": [],
			"frameId": null,
			"roundness": null,
			"boundElements": [],
			"updated": 1713353040745,
			"link": null,
			"locked": false,
			"startBinding": null,
			"endBinding": null,
			"lastCommittedPoint": null,
			"startArrowhead": null,
			"endArrowhead": null,
			"points": [
				[
					0,
					0
				],
				[
					10.207728174155186,
					-0.27760717350486175
				],
				[
					10.207728174155186,
					-30.343984343205534
				],
				[
					21.39057060434388,
					-30.343984343205534
				],
				[
					21.39057060434388,
					-0.27760717350486175
				],
				[
					21.959381245857827,
					-0.27760717350486175
				]
			]
		},
		{
			"type": "line",
			"version": 616,
			"versionNonce": 1207956406,
			"isDeleted": false,
			"id": "0AA9CNotzlz8cGfsE8xUm",
			"fillStyle": "hachure",
			"strokeWidth": 2,
			"strokeStyle": "solid",
			"roughness": 0,
			"opacity": 100,
			"angle": 0,
			"x": -157.65945174473262,
			"y": 49.15483305279372,
			"strokeColor": "#1971c2",
			"backgroundColor": "transparent",
			"width": 21.959381245857827,
			"height": 30.343984343205534,
			"seed": 206009747,
			"groupIds": [],
			"frameId": null,
			"roundness": null,
			"boundElements": [],
			"updated": 1713353040745,
			"link": null,
			"locked": false,
			"startBinding": null,
			"endBinding": null,
			"lastCommittedPoint": null,
			"startArrowhead": null,
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
				],
				[
					51.197775490687526,
					-87.03071944039748
				],
				[
					51.197775490687526,
					-0.7961655975549389
				],
				[
					52.99490554970551,
					-0.7961655975549389
				]
			]
		},
		{
			"type": "line",
			"version": 2341,
			"versionNonce": 749231542,
			"isDeleted": false,
			"id": "nQouDtV_x3Kp5ZljStOV6",
			"fillStyle": "hachure",
			"strokeWidth": 2,
			"strokeStyle": "solid",
			"roughness": 0,
			"opacity": 100,
			"angle": 0,
			"x": 148.84829685477524,
			"y": 438.606160595301,
			"strokeColor": "#1e1e1e",
			"backgroundColor": "transparent",
			"width": 105.28256027207493,
			"height": 87.03076984903596,
			"seed": 1398120886,
			"groupIds": [],
			"frameId": null,
			"roundness": null,
			"boundElements": [],
			"updated": 1713353040745,
			"link": null,
			"locked": false,
			"startBinding": null,
			"endBinding": null,
			"lastCommittedPoint": null,
			"startArrowhead": null,
			"endArrowhead": null,
			"points": [
				[
					0,
					0
				],
				[
					9.963669345390167,
					-0.7962160061934277
				],
				[
					9.963669345390167,
					-87.03076984903596
				],
				[
					73.34105739101365,
					-86.61209531929644
				],
				[
					70.9977027317207,
					-86.776962127975
				],
				[
					105.28256027207493,
					-86.5073906836011
				]
			]
		},
		{
			"id": "rx9JblQjAZm3VGAqsqd-g",
			"type": "line",
			"x": -79.80742255634387,
			"y": 292.1876998356066,
			"width": 0.5359804321310122,
			"height": 187.38874381950978,
			"angle": 0,
			"strokeColor": "#1971c2",
			"backgroundColor": "#f08c00",
			"fillStyle": "solid",
			"strokeWidth": 2,
			"strokeStyle": "dashed",
			"roughness": 0,
			"opacity": 100,
			"groupIds": [],
			"frameId": null,
			"roundness": null,
			"seed": 2040641962,
			"version": 646,
			"versionNonce": 383647914,
			"isDeleted": false,
			"boundElements": null,
			"updated": 1713353040745,
			"link": null,
			"locked": false,
			"points": [
				[
					0,
					0
				],
				[
					-0.5359804321310122,
					187.38874381950978
				]
			],
			"lastCommittedPoint": null,
			"startBinding": null,
			"endBinding": null,
			"startArrowhead": null,
			"endArrowhead": null
		},
		{
			"id": "1ofx0jkZ",
			"type": "text",
			"x": -214.87675089235347,
			"y": 289.2660281157224,
			"width": 128.49609375,
			"height": 35.103985264184054,
			"angle": 0,
			"strokeColor": "#1971c2",
			"backgroundColor": "#f08c00",
			"fillStyle": "solid",
			"strokeWidth": 1,
			"strokeStyle": "dashed",
			"roughness": 0,
			"opacity": 100,
			"groupIds": [],
			"frameId": null,
			"roundness": null,
			"seed": 1957558902,
			"version": 710,
			"versionNonce": 794819306,
			"isDeleted": false,
			"boundElements": null,
			"updated": 1713353208985,
			"link": null,
			"locked": false,
			"text": "Flanke erkannt\nSchleifenbeginn",
			"rawText": "Flanke erkannt\nSchleifenbeginn",
			"fontSize": 14.626660526743356,
			"fontFamily": 3,
			"textAlign": "left",
			"verticalAlign": "top",
			"baseline": 32,
			"containerId": null,
			"originalText": "Flanke erkannt\nSchleifenbeginn",
			"lineHeight": 1.2
		},
		{
			"id": "ClDyy8TLdCZInXTZ_Zu96",
			"type": "arrow",
			"x": 14.898168483416754,
			"y": 333.2836258359197,
			"width": 25.689752700973266,
			"height": 0,
			"angle": 0,
			"strokeColor": "#e03131",
			"backgroundColor": "#f08c00",
			"fillStyle": "solid",
			"strokeWidth": 2,
			"strokeStyle": "solid",
			"roughness": 0,
			"opacity": 100,
			"groupIds": [],
			"frameId": null,
			"roundness": null,
			"seed": 330032874,
			"version": 541,
			"versionNonce": 1164729194,
			"isDeleted": false,
			"boundElements": null,
			"updated": 1713353040745,
			"link": null,
			"locked": false,
			"points": [
				[
					0,
					0
				],
				[
					25.689752700973266,
					0
				]
			],
			"lastCommittedPoint": [
				16.270268625129958,
				0
			],
			"startBinding": null,
			"endBinding": null,
			"startArrowhead": "bar",
			"endArrowhead": "bar"
		},
		{
			"id": "1xHmx43BeJO5g7lvPyMm3",
			"type": "arrow",
			"x": 160.44639564681702,
			"y": 324.2487600411394,
			"width": 78.33176428280935,
			"height": 0.10498898808324664,
			"angle": 0,
			"strokeColor": "#2f9e44",
			"backgroundColor": "#f08c00",
			"fillStyle": "solid",
			"strokeWidth": 2,
			"strokeStyle": "solid",
			"roughness": 0,
			"opacity": 100,
			"groupIds": [],
			"frameId": null,
			"roundness": null,
			"seed": 191402346,
			"version": 610,
			"versionNonce": 1521018934,
			"isDeleted": false,
			"boundElements": null,
			"updated": 1713353040745,
			"link": null,
			"locked": false,
			"points": [
				[
					0,
					0
				],
				[
					78.33176428280935,
					0.10498898808324664
				]
			],
			"lastCommittedPoint": null,
			"startBinding": {
				"elementId": "HXgCmdYD",
				"focus": 1.662543343285454,
				"gap": 15.70528162176069
			},
			"endBinding": null,
			"startArrowhead": "bar",
			"endArrowhead": "bar"
		},
		{
			"id": "HXgCmdYD",
			"type": "text",
			"x": 176.1516772685777,
			"y": 299.49397731882937,
			"width": 45.380859375,
			"height": 18.595509578759238,
			"angle": 0,
			"strokeColor": "#2f9e44",
			"backgroundColor": "#f08c00",
			"fillStyle": "solid",
			"strokeWidth": 2,
			"strokeStyle": "solid",
			"roughness": 0,
			"opacity": 100,
			"groupIds": [],
			"frameId": null,
			"roundness": null,
			"seed": 626532150,
			"version": 297,
			"versionNonce": 1046399286,
			"isDeleted": false,
			"boundElements": [
				{
					"id": "1xHmx43BeJO5g7lvPyMm3",
					"type": "arrow"
				}
			],
			"updated": 1713358360007,
			"link": null,
			"locked": false,
			"text": "100ms",
			"rawText": "100ms",
			"fontSize": 15.496257982299365,
			"fontFamily": 3,
			"textAlign": "left",
			"verticalAlign": "top",
			"baseline": 15,
			"containerId": null,
			"originalText": "100ms",
			"lineHeight": 1.2
		},
		{
			"id": "nZAon1Bs",
			"type": "text",
			"x": 21.5411582652967,
			"y": 265.9419245664073,
			"width": 37.5,
			"height": 19.2,
			"angle": 0,
			"strokeColor": "#e03131",
			"backgroundColor": "#f08c00",
			"fillStyle": "solid",
			"strokeWidth": 2,
			"strokeStyle": "solid",
			"roughness": 0,
			"opacity": 100,
			"groupIds": [],
			"frameId": null,
			"roundness": null,
			"seed": 366875306,
			"version": 110,
			"versionNonce": 822767990,
			"isDeleted": false,
			"boundElements": [
				{
					"id": "EOuTUypDOCjARR0gQOl3b",
					"type": "arrow"
				}
			],
			"updated": 1713353040745,
			"link": null,
			"locked": false,
			"text": "38ms",
			"rawText": "38ms",
			"fontSize": 16,
			"fontFamily": 3,
			"textAlign": "left",
			"verticalAlign": "top",
			"baseline": 15,
			"containerId": null,
			"originalText": "38ms",
			"lineHeight": 1.2
		},
		{
			"id": "EOuTUypDOCjARR0gQOl3b",
			"type": "arrow",
			"x": 35.46419585155729,
			"y": 286.1419245664073,
			"width": 7.6816002209803855,
			"height": 40.387704387362874,
			"angle": 0,
			"strokeColor": "#e03131",
			"backgroundColor": "#f08c00",
			"fillStyle": "solid",
			"strokeWidth": 2,
			"strokeStyle": "solid",
			"roughness": 0,
			"opacity": 100,
			"groupIds": [],
			"frameId": null,
			"roundness": null,
			"seed": 1649863210,
			"version": 111,
			"versionNonce": 271059178,
			"isDeleted": false,
			"boundElements": null,
			"updated": 1713353040745,
			"link": null,
			"locked": false,
			"points": [
				[
					0,
					0
				],
				[
					-7.6816002209803855,
					40.387704387362874
				]
			],
			"lastCommittedPoint": null,
			"startBinding": {
				"elementId": "nZAon1Bs",
				"focus": 0.13661036997806522,
				"gap": 1
			},
			"endBinding": null,
			"startArrowhead": null,
			"endArrowhead": "triangle"
		},
		{
			"id": "42ApAkKs",
			"type": "text",
			"x": 247.7546547675314,
			"y": 435.0204953941784,
			"width": 206.25,
			"height": 38.4,
			"angle": 0,
			"strokeColor": "#1971c2",
			"backgroundColor": "#f08c00",
			"fillStyle": "solid",
			"strokeWidth": 2,
			"strokeStyle": "dashed",
			"roughness": 0,
			"opacity": 100,
			"groupIds": [],
			"frameId": null,
			"roundness": null,
			"seed": 453958506,
			"version": 143,
			"versionNonce": 938936182,
			"isDeleted": false,
			"boundElements": null,
			"updated": 1713353227952,
			"link": null,
			"locked": false,
			"text": "DEBOUNCE_DELAY > 100ms\nSchleifenende",
			"rawText": "DEBOUNCE_DELAY > 100ms\nSchleifenende",
			"fontSize": 16,
			"fontFamily": 3,
			"textAlign": "left",
			"verticalAlign": "top",
			"baseline": 34,
			"containerId": null,
			"originalText": "DEBOUNCE_DELAY > 100ms\nSchleifenende",
			"lineHeight": 1.2
		},
		{
			"id": "yh4u-aZAfmm_8UEr4shIM",
			"type": "arrow",
			"x": -79.8255169118953,
			"y": 500.01923281535477,
			"width": 239.55384707274925,
			"height": 1.3351886618518733,
			"angle": 0,
			"strokeColor": "#f08c00",
			"backgroundColor": "#f08c00",
			"fillStyle": "solid",
			"strokeWidth": 2,
			"strokeStyle": "solid",
			"roughness": 0,
			"opacity": 100,
			"groupIds": [],
			"frameId": null,
			"roundness": null,
			"seed": 492544106,
			"version": 132,
			"versionNonce": 307705130,
			"isDeleted": false,
			"boundElements": null,
			"updated": 1713353275643,
			"link": null,
			"locked": false,
			"points": [
				[
					0,
					0
				],
				[
					239.55384707274925,
					1.3351886618518733
				]
			],
			"lastCommittedPoint": null,
			"startBinding": null,
			"endBinding": null,
			"startArrowhead": "bar",
			"endArrowhead": "bar"
		},
		{
			"id": "RBMbONDH",
			"type": "text",
			"x": -42.94946693476061,
			"y": 507.39446596123594,
			"width": 159.46875,
			"height": 18.146384240848146,
			"angle": 0,
			"strokeColor": "#f08c00",
			"backgroundColor": "#f08c00",
			"fillStyle": "solid",
			"strokeWidth": 2,
			"strokeStyle": "solid",
			"roughness": 0,
			"opacity": 100,
			"groupIds": [],
			"frameId": null,
			"roundness": null,
			"seed": 1917599158,
			"version": 72,
			"versionNonce": 1924533546,
			"isDeleted": false,
			"boundElements": null,
			"updated": 1713358360009,
			"link": null,
			"locked": false,
			"text": "Dauer des Prellens",
			"rawText": "Dauer des Prellens",
			"fontSize": 15.121986867373456,
			"fontFamily": 3,
			"textAlign": "left",
			"verticalAlign": "top",
			"baseline": 14,
			"containerId": null,
			"originalText": "Dauer des Prellens",
			"lineHeight": 1.2
		}
	],
	"appState": {
		"theme": "dark",
		"viewBackgroundColor": "#ffffff",
		"currentItemStrokeColor": "#f08c00",
		"currentItemBackgroundColor": "#f08c00",
		"currentItemFillStyle": "solid",
		"currentItemStrokeWidth": 2,
		"currentItemStrokeStyle": "solid",
		"currentItemRoughness": 0,
		"currentItemOpacity": 100,
		"currentItemFontFamily": 3,
		"currentItemFontSize": 16,
		"currentItemTextAlign": "left",
		"currentItemStartArrowhead": "bar",
		"currentItemEndArrowhead": "bar",
		"scrollX": 692.1575575857237,
		"scrollY": 200.99733240215463,
		"zoom": {
			"value": 1
		},
		"currentItemRoundness": "sharp",
		"gridSize": null,
		"gridColor": {
			"Bold": "#C9C9C9FF",
			"Regular": "#EDEDEDFF"
		},
		"currentStrokeOptions": null,
		"previousGridSize": null,
		"frameRendering": {
			"enabled": true,
			"clip": true,
			"name": true,
			"outline": true
		}
	},
	"files": {}
}
```
%%
