SheepSupreme/AIAS/Dokumentationen/Programm Ablauf.md

---

excalidraw-plugin: parsed
tags: [excalidraw]

---
==⚠  Switch to EXCALIDRAW VIEW in the MORE OPTIONS menu of this document. ⚠==

# Text Elements
Erkennung des Pakets ^DezzMgJv

Erstellen eines Objektes für den Timer des Pakets ^0hfh7Fzg

Indikator für Paket Einlagerung ^HXY5zqoo

Chronologischer Ablauf ^0Bl0e0ep

Auswurf des Pakets ^91xgfZkR

Befehl für Ausgabe ^G4jO4sLS

Erkennung des Pakets ^tA4B3B7l

Mit dem QR-Code-Scanner wird die ID des Pakets eingelesen und über die serielle Schnittstelle an das
Hauptprogramm(Computer) weiter gegeben. Von dort aus wird eine Anfrage an die SQL Datenbank 
für die eingelesene ID gestartet. Die Datenbank antwortet mit allen Parameter(Eigenschaften) des Paketes. 
  ^02Cdh0ey

Indikator für Paket Einlagerung ^G9FhOb90

Im Hauptprogramm wird ein Objekt für jedes Paket erstellt, dass die Parameter der Datenbank übernimmt.
Jedes Paket hat eine mit der Fälligkeitsdatum berechnete Ablaufzeit, nach der sortiert und eingelagert wird. ^y374fQq5

Das Hauptprogramm bestimmt das Regal in dem das Paket eingelagert werden soll um einen möglichst effizienten
Ablauf des Prozesses zu ermöglichen. Damit das Paket richtig eingelagert wird,
wird mithilfe von an den Regalen installierten LEDs das richtige Regal gekennzeichnet. ^UvIh0cjj

Erstellen eines Objektes für den Timer des Pakets ^yW1fCZkD

Auswurf des Pakets ^pecoTU0e

Mit dem Auswurfbefehl kann die gewollte Anzahl an Pakete ausgeworfen werden. Die Reihenfolge,
in der die Pakete ausgeworfen werden, beginnt mit dem Paket, das die kürzeste Ablaufzeit hat 
und steigt dann auf. ^S9WYBtKL

Paket hinzufügen ^G7RuVe72

Haupt
Programm ^et1otK1V

SQL Datenbank ^vRcJmjAX

Arduino ^KNCFgXYO

Anfrage der Paketparameter ^uvXf5KiY

Übergabe der
Parameter ^zABicjzd

GUI ^7X4fgmm2

QR-Code Scanner ^HrtZAPF3

Einlesen der
Paket-ID ^FjNZhNjt

LEDs ^BDpwkr7y

Motoren ^PEwLsrSy

Ansteuerung für Ausgabe (DRV8825) ^8N4p45W7

serielle Schnittstelle
(USB) ^xPRjny8z

%%
# Drawing
```json
{
	"type": "excalidraw",
	"version": 2,
	"source": "https://github.com/zsviczian/obsidian-excalidraw-plugin/releases/tag/2.0.20",
	"elements": [
		{
			"type": "text",
			"version": 602,
			"versionNonce": 1293195750,
			"isDeleted": false,
			"id": "G7RuVe72",
			"fillStyle": "solid",
			"strokeWidth": 2,
			"strokeStyle": "solid",
			"roughness": 1,
			"opacity": 100,
			"angle": 0,
			"x": -292.4396709507664,
			"y": 150.74102709243817,
			"strokeColor": "#1e1e1e",
			"backgroundColor": "transparent",
			"width": 248.98018009628163,
			"height": 37.67405362002328,
			"seed": 1979132791,
			"groupIds": [],
			"frameId": null,
			"roundness": null,
			"boundElements": [],
			"updated": 1713621354702,
			"link": null,
			"locked": false,
			"fontSize": 30.139242896018626,
			"fontFamily": 1,
			"text": "Paket hinzufügen",
			"rawText": "Paket hinzufügen",
			"textAlign": "left",
			"verticalAlign": "top",
			"containerId": null,
			"originalText": "Paket hinzufügen",
			"lineHeight": 1.25,
			"baseline": 26
		},
		{
			"type": "rectangle",
			"version": 802,
			"versionNonce": 1873119526,
			"isDeleted": false,
			"id": "DX3YGNneph1GhbdrnOERN",
			"fillStyle": "solid",
			"strokeWidth": 2,
			"strokeStyle": "solid",
			"roughness": 1,
			"opacity": 100,
			"angle": 0,
			"x": -271.124413080625,
			"y": 241.28355665174155,
			"strokeColor": "#1e1e1e",
			"backgroundColor": "#ff8787",
			"width": 194.9004782732182,
			"height": 117.87791755135392,
			"seed": 2083643447,
			"groupIds": [],
			"frameId": null,
			"roundness": {
				"type": 3
			},
			"boundElements": [
				{
					"type": "text",
					"id": "et1otK1V"
				},
				{
					"id": "dJPqbkuTlPqdhmxXLSDe8",
					"type": "arrow"
				},
				{
					"id": "ESimG3PVmSbPQboZjtUFr",
					"type": "arrow"
				},
				{
					"id": "mHZODtrimTabkH7cpCb4b",
					"type": "arrow"
				},
				{
					"id": "-FZlbg5KfkiH9VtkB2WAV",
					"type": "arrow"
				},
				{
					"id": "rwIKLI6oD7QsZDh410pNX",
					"type": "arrow"
				}
			],
			"updated": 1713621463193,
			"link": null,
			"locked": false
		},
		{
			"type": "text",
			"version": 801,
			"versionNonce": 1727518822,
			"isDeleted": false,
			"id": "et1otK1V",
			"fillStyle": "solid",
			"strokeWidth": 2,
			"strokeStyle": "solid",
			"roughness": 1,
			"opacity": 100,
			"angle": 0,
			"x": -241.60765080531525,
			"y": 262.54846180739526,
			"strokeColor": "#1e1e1e",
			"backgroundColor": "transparent",
			"width": 135.86695372259865,
			"height": 75.34810724004656,
			"seed": 831963479,
			"groupIds": [],
			"frameId": null,
			"roundness": null,
			"boundElements": [],
			"updated": 1713621354702,
			"link": null,
			"locked": false,
			"fontSize": 30.139242896018626,
			"fontFamily": 1,
			"text": "Haupt\nProgramm",
			"rawText": "Haupt\nProgramm",
			"textAlign": "center",
			"verticalAlign": "middle",
			"containerId": "DX3YGNneph1GhbdrnOERN",
			"originalText": "Haupt\nProgramm",
			"lineHeight": 1.25,
			"baseline": 64
		},
		{
			"type": "rectangle",
			"version": 989,
			"versionNonce": 588239846,
			"isDeleted": false,
			"id": "U64DESZmwysDXfMpFwopI",
			"fillStyle": "solid",
			"strokeWidth": 2,
			"strokeStyle": "solid",
			"roughness": 1,
			"opacity": 100,
			"angle": 0,
			"x": 255.41376320640654,
			"y": 235.01145809165638,
			"strokeColor": "#1e1e1e",
			"backgroundColor": "transparent",
			"width": 194.80245419393134,
			"height": 121.39417277563057,
			"seed": 1711439479,
			"groupIds": [],
			"frameId": null,
			"roundness": {
				"type": 3
			},
			"boundElements": [
				{
					"type": "text",
					"id": "vRcJmjAX"
				},
				{
					"id": "dJPqbkuTlPqdhmxXLSDe8",
					"type": "arrow"
				},
				{
					"id": "-FZlbg5KfkiH9VtkB2WAV",
					"type": "arrow"
				}
			],
			"updated": 1713621354702,
			"link": null,
			"locked": false
		},
		{
			"type": "text",
			"version": 1002,
			"versionNonce": 1056466726,
			"isDeleted": false,
			"id": "vRcJmjAX",
			"fillStyle": "solid",
			"strokeWidth": 2,
			"strokeStyle": "solid",
			"roughness": 1,
			"opacity": 100,
			"angle": 0,
			"x": 275.1487614047536,
			"y": 258.0344908594484,
			"strokeColor": "#1e1e1e",
			"backgroundColor": "transparent",
			"width": 155.3324577972372,
			"height": 75.34810724004656,
			"seed": 1278842775,
			"groupIds": [],
			"frameId": null,
			"roundness": null,
			"boundElements": [],
			"updated": 1713621354702,
			"link": null,
			"locked": false,
			"fontSize": 30.139242896018626,
			"fontFamily": 1,
			"text": "SQL\nDatenbank",
			"rawText": "SQL Datenbank",
			"textAlign": "center",
			"verticalAlign": "middle",
			"containerId": "U64DESZmwysDXfMpFwopI",
			"originalText": "SQL Datenbank",
			"lineHeight": 1.25,
			"baseline": 64
		},
		{
			"type": "rectangle",
			"version": 717,
			"versionNonce": 344699110,
			"isDeleted": false,
			"id": "kKFZ5DPW21Cm-cpOk4Iz8",
			"fillStyle": "solid",
			"strokeWidth": 2,
			"strokeStyle": "solid",
			"roughness": 1,
			"opacity": 100,
			"angle": 0,
			"x": -541.473295115661,
			"y": 261.1670388090091,
			"strokeColor": "#1e1e1e",
			"backgroundColor": "transparent",
			"width": 133.0293949643196,
			"height": 76.86994067811689,
			"seed": 1248890039,
			"groupIds": [],
			"frameId": null,
			"roundness": {
				"type": 3
			},
			"boundElements": [
				{
					"type": "text",
					"id": "KNCFgXYO"
				},
				{
					"id": "ESimG3PVmSbPQboZjtUFr",
					"type": "arrow"
				},
				{
					"id": "mHZODtrimTabkH7cpCb4b",
					"type": "arrow"
				},
				{
					"id": "oWP5nrk6GDbH8yyliv-ep",
					"type": "arrow"
				},
				{
					"id": "a-HsaBB_vFEuBm7PWnyAR",
					"type": "arrow"
				},
				{
					"id": "rwIKLI6oD7QsZDh410pNX",
					"type": "arrow"
				},
				{
					"id": "kYlvDfdaNfCjYDqsHAaG6",
					"type": "arrow"
				}
			],
			"updated": 1713621354702,
			"link": null,
			"locked": false
		},
		{
			"type": "text",
			"version": 828,
			"versionNonce": 787522598,
			"isDeleted": false,
			"id": "KNCFgXYO",
			"fillStyle": "solid",
			"strokeWidth": 2,
			"strokeStyle": "solid",
			"roughness": 1,
			"opacity": 100,
			"angle": 0,
			"x": -527.1328299002621,
			"y": 280.7649823380559,
			"strokeColor": "#1e1e1e",
			"backgroundColor": "transparent",
			"width": 104.34846453352186,
			"height": 37.67405362002328,
			"seed": 206298583,
			"groupIds": [],
			"frameId": null,
			"roundness": null,
			"boundElements": [],
			"updated": 1713621354702,
			"link": null,
			"locked": false,
			"fontSize": 30.139242896018626,
			"fontFamily": 1,
			"text": "Arduino",
			"rawText": "Arduino",
			"textAlign": "center",
			"verticalAlign": "middle",
			"containerId": "kKFZ5DPW21Cm-cpOk4Iz8",
			"originalText": "Arduino",
			"lineHeight": 1.25,
			"baseline": 26
		},
		{
			"type": "arrow",
			"version": 2670,
			"versionNonce": 302657830,
			"isDeleted": false,
			"id": "dJPqbkuTlPqdhmxXLSDe8",
			"fillStyle": "solid",
			"strokeWidth": 2,
			"strokeStyle": "solid",
			"roughness": 1,
			"opacity": 100,
			"angle": 0,
			"x": -63.60366929573786,
			"y": 270.5374396491719,
			"strokeColor": "#1971c2",
			"backgroundColor": "transparent",
			"width": 310.1941023693077,
			"height": 11.812441098545444,
			"seed": 1423969015,
			"groupIds": [],
			"frameId": null,
			"roundness": {
				"type": 2
			},
			"boundElements": [
				{
					"type": "text",
					"id": "uvXf5KiY"
				}
			],
			"updated": 1713621391546,
			"link": null,
			"locked": false,
			"startBinding": {
				"elementId": "DX3YGNneph1GhbdrnOERN",
				"focus": -0.40691980581472303,
				"gap": 12.620265511668961
			},
			"endBinding": {
				"elementId": "U64DESZmwysDXfMpFwopI",
				"focus": 0.6370296699783345,
				"gap": 8.823330132836702
			},
			"lastCommittedPoint": null,
			"startArrowhead": null,
			"endArrowhead": "arrow",
			"points": [
				[
					0,
					0
				],
				[
					310.1941023693077,
					-11.812441098545444
				]
			]
		},
		{
			"type": "text",
			"version": 425,
			"versionNonce": 1305308710,
			"isDeleted": false,
			"id": "uvXf5KiY",
			"fillStyle": "cross-hatch",
			"strokeWidth": 2,
			"strokeStyle": "solid",
			"roughness": 1,
			"opacity": 100,
			"angle": 0,
			"x": 12.433425020426398,
			"y": 239.63121909989923,
			"strokeColor": "#1e1e1e",
			"backgroundColor": "transparent",
			"width": 158.11991373697919,
			"height": 50,
			"seed": 1850557975,
			"groupIds": [],
			"frameId": null,
			"roundness": null,
			"boundElements": [],
			"updated": 1713621393425,
			"link": null,
			"locked": false,
			"fontSize": 20,
			"fontFamily": 1,
			"text": "Anfrage der\nPaketparameter",
			"rawText": "Anfrage der Paketparameter",
			"textAlign": "center",
			"verticalAlign": "middle",
			"containerId": "dJPqbkuTlPqdhmxXLSDe8",
			"originalText": "Anfrage der Paketparameter",
			"lineHeight": 1.25,
			"baseline": 42
		},
		{
			"type": "arrow",
			"version": 2100,
			"versionNonce": 1420646330,
			"isDeleted": false,
			"id": "ESimG3PVmSbPQboZjtUFr",
			"fillStyle": "solid",
			"strokeWidth": 2,
			"strokeStyle": "solid",
			"roughness": 1,
			"opacity": 100,
			"angle": 0,
			"x": -281.1918898428262,
			"y": 300.1794874294553,
			"strokeColor": "#2f9e44",
			"backgroundColor": "transparent",
			"width": 116.66728704321143,
			"height": 0.9673505202816548,
			"seed": 280073239,
			"groupIds": [],
			"frameId": null,
			"roundness": {
				"type": 2
			},
			"boundElements": [],
			"updated": 1713621354767,
			"link": null,
			"locked": false,
			"startBinding": {
				"elementId": "DX3YGNneph1GhbdrnOERN",
				"focus": 0.015641204061742946,
				"gap": 10.067476762201181
			},
			"endBinding": {
				"elementId": "kKFZ5DPW21Cm-cpOk4Iz8",
				"focus": 0.05602201462114951,
				"gap": 10.58472326530375
			},
			"lastCommittedPoint": null,
			"startArrowhead": null,
			"endArrowhead": "arrow",
			"points": [
				[
					0,
					0
				],
				[
					-116.66728704321143,
					0.9673505202816548
				]
			]
		},
		{
			"type": "arrow",
			"version": 2096,
			"versionNonce": 1525821754,
			"isDeleted": false,
			"id": "mHZODtrimTabkH7cpCb4b",
			"fillStyle": "solid",
			"strokeWidth": 2,
			"strokeStyle": "solid",
			"roughness": 1,
			"opacity": 100,
			"angle": 0,
			"x": -401.34626495435856,
			"y": 286.84016954148535,
			"strokeColor": "#1971c2",
			"backgroundColor": "transparent",
			"width": 111.00436670420433,
			"height": 2.628091456504159,
			"seed": 666171703,
			"groupIds": [],
			"frameId": null,
			"roundness": {
				"type": 2
			},
			"boundElements": [],
			"updated": 1713621354767,
			"link": null,
			"locked": false,
			"startBinding": {
				"elementId": "kKFZ5DPW21Cm-cpOk4Iz8",
				"focus": -0.27540855831298117,
				"gap": 7.0976351969828215
			},
			"endBinding": {
				"elementId": "DX3YGNneph1GhbdrnOERN",
				"focus": 0.30651089822749594,
				"gap": 19.217485169529255
			},
			"lastCommittedPoint": null,
			"startArrowhead": null,
			"endArrowhead": "arrow",
			"points": [
				[
					0,
					0
				],
				[
					111.00436670420433,
					-2.628091456504159
				]
			]
		},
		{
			"type": "arrow",
			"version": 2493,
			"versionNonce": 1747967738,
			"isDeleted": false,
			"id": "-FZlbg5KfkiH9VtkB2WAV",
			"fillStyle": "solid",
			"strokeWidth": 2,
			"strokeStyle": "solid",
			"roughness": 1,
			"opacity": 100,
			"angle": 6.258108515051162,
			"x": 245.47706774201095,
			"y": 337.2204689062826,
			"strokeColor": "#1971c2",
			"backgroundColor": "transparent",
			"width": 307.76061329921106,
			"height": 6.451076138611293,
			"seed": 256817751,
			"groupIds": [],
			"frameId": null,
			"roundness": {
				"type": 2
			},
			"boundElements": [
				{
					"type": "text",
					"id": "zABicjzd"
				}
			],
			"updated": 1713621387976,
			"link": null,
			"locked": false,
			"startBinding": {
				"elementId": "U64DESZmwysDXfMpFwopI",
				"focus": -0.5017070773620809,
				"gap": 10.053314411732373
			},
			"endBinding": {
				"elementId": "DX3YGNneph1GhbdrnOERN",
				"focus": 0.8268154986636733,
				"gap": 14.08228751183043
			},
			"lastCommittedPoint": null,
			"startArrowhead": null,
			"endArrowhead": "arrow",
			"points": [
				[
					0,
					0
				],
				[
					-307.76061329921106,
					6.451076138611293
				]
			]
		},
		{
			"type": "text",
			"version": 455,
			"versionNonce": 1700441082,
			"isDeleted": false,
			"id": "zABicjzd",
			"fillStyle": "cross-hatch",
			"strokeWidth": 2,
			"strokeStyle": "solid",
			"roughness": 1,
			"opacity": 100,
			"angle": 0,
			"x": 21.669810849621115,
			"y": 312.94600697558826,
			"strokeColor": "#1e1e1e",
			"backgroundColor": "transparent",
			"width": 139.8539004855686,
			"height": 55.00000000000001,
			"seed": 814416823,
			"groupIds": [],
			"frameId": null,
			"roundness": null,
			"boundElements": [],
			"updated": 1713621386595,
			"link": null,
			"locked": false,
			"fontSize": 22,
			"fontFamily": 1,
			"text": "Übergabe der\nParameter",
			"rawText": "Übergabe der\nParameter",
			"textAlign": "center",
			"verticalAlign": "middle",
			"containerId": "-FZlbg5KfkiH9VtkB2WAV",
			"originalText": "Übergabe der\nParameter",
			"lineHeight": 1.25,
			"baseline": 46
		},
		{
			"type": "text",
			"version": 672,
			"versionNonce": 435701734,
			"isDeleted": false,
			"id": "7X4fgmm2",
			"fillStyle": "solid",
			"strokeWidth": 2,
			"strokeStyle": "solid",
			"roughness": 1,
			"opacity": 100,
			"angle": 0,
			"x": -204.84403384549995,
			"y": 201.18125978969215,
			"strokeColor": "#1e1e1e",
			"backgroundColor": "transparent",
			"width": 61.72515401923707,
			"height": 37.67405362002328,
			"seed": 475223927,
			"groupIds": [],
			"frameId": null,
			"roundness": null,
			"boundElements": [],
			"updated": 1713621354702,
			"link": null,
			"locked": false,
			"fontSize": 30.139242896018626,
			"fontFamily": 1,
			"text": "GUI",
			"rawText": "GUI",
			"textAlign": "left",
			"verticalAlign": "top",
			"containerId": null,
			"originalText": "GUI",
			"lineHeight": 1.25,
			"baseline": 26
		},
		{
			"type": "rectangle",
			"version": 880,
			"versionNonce": 938596090,
			"isDeleted": false,
			"id": "bcaraVrTiRy5Y_UCaEmOc",
			"fillStyle": "solid",
			"strokeWidth": 2,
			"strokeStyle": "solid",
			"roughness": 1,
			"opacity": 100,
			"angle": 0,
			"x": -632.7039709636451,
			"y": 459.627054357536,
			"strokeColor": "#1e1e1e",
			"backgroundColor": "transparent",
			"width": 109.69382591893763,
			"height": 66.82570897555868,
			"seed": 1190473305,
			"groupIds": [],
			"frameId": null,
			"roundness": {
				"type": 3
			},
			"boundElements": [
				{
					"type": "text",
					"id": "HrtZAPF3"
				},
				{
					"id": "oWP5nrk6GDbH8yyliv-ep",
					"type": "arrow"
				}
			],
			"updated": 1713621407742,
			"link": null,
			"locked": false
		},
		{
			"type": "text",
			"version": 1066,
			"versionNonce": 1750132666,
			"isDeleted": false,
			"id": "HrtZAPF3",
			"fillStyle": "solid",
			"strokeWidth": 2,
			"strokeStyle": "solid",
			"roughness": 1,
			"opacity": 100,
			"angle": 0,
			"x": -612.2373226747089,
			"y": 472.1098790564135,
			"strokeColor": "#1e1e1e",
			"backgroundColor": "transparent",
			"width": 68.76052934106515,
			"height": 41.860059577803646,
			"seed": 58392727,
			"groupIds": [],
			"frameId": null,
			"roundness": null,
			"boundElements": [],
			"updated": 1713621407742,
			"link": null,
			"locked": false,
			"fontSize": 16.744023831121456,
			"fontFamily": 1,
			"text": "QR-Code\nScanner",
			"rawText": "QR-Code Scanner",
			"textAlign": "center",
			"verticalAlign": "middle",
			"containerId": "bcaraVrTiRy5Y_UCaEmOc",
			"originalText": "QR-Code Scanner",
			"lineHeight": 1.25,
			"baseline": 35
		},
		{
			"type": "arrow",
			"version": 1867,
			"versionNonce": 1727119674,
			"isDeleted": false,
			"id": "oWP5nrk6GDbH8yyliv-ep",
			"fillStyle": "solid",
			"strokeWidth": 2,
			"strokeStyle": "solid",
			"roughness": 1,
			"opacity": 100,
			"angle": 0,
			"x": -585.7691046381738,
			"y": 456.09528381340436,
			"strokeColor": "#1971c2",
			"backgroundColor": "transparent",
			"width": 107.03157710382914,
			"height": 109.02731348976494,
			"seed": 1335944247,
			"groupIds": [],
			"frameId": null,
			"roundness": {
				"type": 2
			},
			"boundElements": [
				{
					"type": "text",
					"id": "FjNZhNjt"
				}
			],
			"updated": 1713621407742,
			"link": null,
			"locked": false,
			"startBinding": {
				"elementId": "bcaraVrTiRy5Y_UCaEmOc",
				"focus": -0.5048292216643347,
				"gap": 3.5317705441316605
			},
			"endBinding": {
				"elementId": "kKFZ5DPW21Cm-cpOk4Iz8",
				"focus": -0.41074114913095483,
				"gap": 9.030990836513467
			},
			"lastCommittedPoint": null,
			"startArrowhead": null,
			"endArrowhead": "arrow",
			"points": [
				[
					0,
					0
				],
				[
					107.03157710382914,
					-109.02731348976494
				]
			]
		},
		{
			"type": "text",
			"version": 348,
			"versionNonce": 1594431034,
			"isDeleted": false,
			"id": "FjNZhNjt",
			"fillStyle": "cross-hatch",
			"strokeWidth": 2,
			"strokeStyle": "solid",
			"roughness": 1,
			"opacity": 100,
			"angle": 0,
			"x": -589.1032482139542,
			"y": 363.6186754083657,
			"strokeColor": "#1e1e1e",
			"backgroundColor": "transparent",
			"width": 115.45989990234375,
			"height": 50,
			"seed": 365643223,
			"groupIds": [],
			"frameId": null,
			"roundness": null,
			"boundElements": [],
			"updated": 1713621407291,
			"link": null,
			"locked": false,
			"fontSize": 20,
			"fontFamily": 1,
			"text": "Einlesen der\nPaket-ID",
			"rawText": "Einlesen der\nPaket-ID",
			"textAlign": "center",
			"verticalAlign": "middle",
			"containerId": "oWP5nrk6GDbH8yyliv-ep",
			"originalText": "Einlesen der\nPaket-ID",
			"lineHeight": 1.25,
			"baseline": 43
		},
		{
			"type": "rectangle",
			"version": 166,
			"versionNonce": 1882186790,
			"isDeleted": false,
			"id": "DKqs3kwQg-4VSJa_oXRo5",
			"fillStyle": "solid",
			"strokeWidth": 2,
			"strokeStyle": "solid",
			"roughness": 1,
			"opacity": 100,
			"angle": 0,
			"x": -681.5431729344335,
			"y": 577.8943585068432,
			"strokeColor": "#1e1e1e",
			"backgroundColor": "#4dabf7",
			"width": 254.10803286733676,
			"height": 88.34217731905281,
			"seed": 1859518231,
			"groupIds": [],
			"frameId": null,
			"roundness": null,
			"boundElements": [
				{
					"type": "text",
					"id": "DezzMgJv"
				},
				{
					"id": "jG0nB1wN1UkGp-tBqzalZ",
					"type": "arrow"
				}
			],
			"updated": 1713621443515,
			"link": null,
			"locked": false
		},
		{
			"type": "text",
			"version": 135,
			"versionNonce": 1194790054,
			"isDeleted": false,
			"id": "DezzMgJv",
			"fillStyle": "cross-hatch",
			"strokeWidth": 2,
			"strokeStyle": "solid",
			"roughness": 1,
			"opacity": 100,
			"angle": 0,
			"x": -649.2271096868003,
			"y": 587.0654471663696,
			"strokeColor": "#1e1e1e",
			"backgroundColor": "#a5d8ff",
			"width": 189.4759063720703,
			"height": 70,
			"seed": 1209379511,
			"groupIds": [],
			"frameId": null,
			"roundness": null,
			"boundElements": [],
			"updated": 1713621266230,
			"link": null,
			"locked": false,
			"fontSize": 28,
			"fontFamily": 1,
			"text": "Erkennung des\nPakets",
			"rawText": "Erkennung des Pakets",
			"textAlign": "center",
			"verticalAlign": "middle",
			"containerId": "DKqs3kwQg-4VSJa_oXRo5",
			"originalText": "Erkennung des Pakets",
			"lineHeight": 1.25,
			"baseline": 59
		},
		{
			"type": "rectangle",
			"version": 228,
			"versionNonce": 1156677562,
			"isDeleted": false,
			"id": "YstAhURYiKSUnJyun8w8C",
			"fillStyle": "solid",
			"strokeWidth": 2,
			"strokeStyle": "solid",
			"roughness": 1,
			"opacity": 100,
			"angle": 0,
			"x": -425.4499893948929,
			"y": 622.6132900550631,
			"strokeColor": "#1e1e1e",
			"backgroundColor": "#ff8787",
			"width": 529.0608104310902,
			"height": 43.12567024312421,
			"seed": 908147223,
			"groupIds": [],
			"frameId": null,
			"roundness": null,
			"boundElements": [
				{
					"type": "text",
					"id": "0hfh7Fzg"
				}
			],
			"updated": 1713621442265,
			"link": null,
			"locked": false
		},
		{
			"type": "text",
			"version": 236,
			"versionNonce": 531405606,
			"isDeleted": false,
			"id": "0hfh7Fzg",
			"fillStyle": "cross-hatch",
			"strokeWidth": 2,
			"strokeStyle": "solid",
			"roughness": 1,
			"opacity": 100,
			"angle": 0,
			"x": -412.389356518215,
			"y": 631.6761251766252,
			"strokeColor": "#1e1e1e",
			"backgroundColor": "#ffc9c9",
			"width": 502.9395446777344,
			"height": 25,
			"seed": 1966547863,
			"groupIds": [],
			"frameId": null,
			"roundness": null,
			"boundElements": [],
			"updated": 1713621266230,
			"link": null,
			"locked": false,
			"fontSize": 20,
			"fontFamily": 1,
			"text": "Erstellen eines Objektes für den Timer des Pakets",
			"rawText": "Erstellen eines Objektes für den Timer des Pakets",
			"textAlign": "center",
			"verticalAlign": "middle",
			"containerId": "YstAhURYiKSUnJyun8w8C",
			"originalText": "Erstellen eines Objektes für den Timer des Pakets",
			"lineHeight": 1.25,
			"baseline": 18
		},
		{
			"type": "rectangle",
			"version": 856,
			"versionNonce": 34641958,
			"isDeleted": false,
			"id": "SmH4pINhsFjNVQr6LIdLk",
			"fillStyle": "cross-hatch",
			"strokeWidth": 2,
			"strokeStyle": "solid",
			"roughness": 1,
			"opacity": 100,
			"angle": 0,
			"x": -707.1155621903035,
			"y": 279.6056675857179,
			"strokeColor": "#1e1e1e",
			"backgroundColor": "transparent",
			"width": 84.76338067763992,
			"height": 40,
			"seed": 872723097,
			"groupIds": [],
			"frameId": null,
			"roundness": {
				"type": 3
			},
			"boundElements": [
				{
					"type": "text",
					"id": "BDpwkr7y"
				},
				{
					"id": "a-HsaBB_vFEuBm7PWnyAR",
					"type": "arrow"
				}
			],
			"updated": 1713621354702,
			"link": null,
			"locked": false
		},
		{
			"type": "text",
			"version": 847,
			"versionNonce": 1104585574,
			"isDeleted": false,
			"id": "BDpwkr7y",
			"fillStyle": "cross-hatch",
			"strokeWidth": 2,
			"strokeStyle": "solid",
			"roughness": 1,
			"opacity": 100,
			"angle": 0,
			"x": -695.1528790199037,
			"y": 284.9546467334866,
			"strokeColor": "#1e1e1e",
			"backgroundColor": "transparent",
			"width": 60.838014336840295,
			"height": 29.30204170446255,
			"seed": 1423890905,
			"groupIds": [],
			"frameId": null,
			"roundness": null,
			"boundElements": [],
			"updated": 1713621354702,
			"link": null,
			"locked": false,
			"fontSize": 23.441633363570038,
			"fontFamily": 1,
			"text": "LEDs",
			"rawText": "LEDs",
			"textAlign": "center",
			"verticalAlign": "middle",
			"containerId": "SmH4pINhsFjNVQr6LIdLk",
			"originalText": "LEDs",
			"lineHeight": 1.25,
			"baseline": 21
		},
		{
			"type": "arrow",
			"version": 1930,
			"versionNonce": 778993082,
			"isDeleted": false,
			"id": "a-HsaBB_vFEuBm7PWnyAR",
			"fillStyle": "cross-hatch",
			"strokeWidth": 2,
			"strokeStyle": "solid",
			"roughness": 1,
			"opacity": 100,
			"angle": 0,
			"x": -550.884945308446,
			"y": 302.09881866870273,
			"strokeColor": "#2f9e44",
			"backgroundColor": "transparent",
			"width": 64.81910056618598,
			"height": 3.869251008882979,
			"seed": 989978169,
			"groupIds": [],
			"frameId": null,
			"roundness": {
				"type": 2
			},
			"boundElements": [],
			"updated": 1713621354767,
			"link": null,
			"locked": false,
			"startBinding": {
				"elementId": "kKFZ5DPW21Cm-cpOk4Iz8",
				"focus": -0.1657590802903405,
				"gap": 9.411650192785032
			},
			"endBinding": {
				"elementId": "SmH4pINhsFjNVQr6LIdLk",
				"focus": -0.1909836259780355,
				"gap": 6.648135638031647
			},
			"lastCommittedPoint": null,
			"startArrowhead": null,
			"endArrowhead": "arrow",
			"points": [
				[
					0,
					0
				],
				[
					-64.81910056618598,
					-3.869251008882979
				]
			]
		},
		{
			"type": "rectangle",
			"version": 286,
			"versionNonce": 2078528102,
			"isDeleted": false,
			"id": "6OFJaRiL8adhm0zJJmJhV",
			"fillStyle": "solid",
			"strokeWidth": 2,
			"strokeStyle": "solid",
			"roughness": 1,
			"opacity": 100,
			"angle": 0,
			"x": -424.705581558469,
			"y": 577.4243977163319,
			"strokeColor": "#1e1e1e",
			"backgroundColor": "#2f9e44",
			"width": 529.0608104310902,
			"height": 43.12567024312421,
			"seed": 1062524153,
			"groupIds": [],
			"frameId": null,
			"roundness": null,
			"boundElements": [
				{
					"type": "text",
					"id": "HXY5zqoo"
				}
			],
			"updated": 1713621440335,
			"link": null,
			"locked": false
		},
		{
			"type": "text",
			"version": 331,
			"versionNonce": 293832358,
			"isDeleted": false,
			"id": "HXY5zqoo",
			"fillStyle": "cross-hatch",
			"strokeWidth": 2,
			"strokeStyle": "solid",
			"roughness": 1,
			"opacity": 100,
			"angle": 0,
			"x": -316.8050591554239,
			"y": 586.487232837894,
			"strokeColor": "#1e1e1e",
			"backgroundColor": "#ffc9c9",
			"width": 313.259765625,
			"height": 25,
			"seed": 1002556889,
			"groupIds": [],
			"frameId": null,
			"roundness": null,
			"boundElements": [],
			"updated": 1713621266230,
			"link": null,
			"locked": false,
			"fontSize": 20,
			"fontFamily": 1,
			"text": "Indikator für Paket Einlagerung",
			"rawText": "Indikator für Paket Einlagerung",
			"textAlign": "center",
			"verticalAlign": "middle",
			"containerId": "6OFJaRiL8adhm0zJJmJhV",
			"originalText": "Indikator für Paket Einlagerung",
			"lineHeight": 1.25,
			"baseline": 18
		},
		{
			"type": "arrow",
			"version": 212,
			"versionNonce": 1923604006,
			"isDeleted": false,
			"id": "jG0nB1wN1UkGp-tBqzalZ",
			"fillStyle": "cross-hatch",
			"strokeWidth": 2,
			"strokeStyle": "solid",
			"roughness": 1,
			"opacity": 100,
			"angle": 0,
			"x": -715.7223566387607,
			"y": 566.0117608834751,
			"strokeColor": "#1e1e1e",
			"backgroundColor": "#2f9e44",
			"width": 1181.6356897493167,
			"height": 1.0213550590110572,
			"seed": 616376537,
			"groupIds": [],
			"frameId": null,
			"roundness": {
				"type": 2
			},
			"boundElements": [],
			"updated": 1713621266230,
			"link": null,
			"locked": false,
			"startBinding": {
				"elementId": "DKqs3kwQg-4VSJa_oXRo5",
				"gap": 11.911282683666741,
				"focus": -1.2690130124471215
			},
			"endBinding": null,
			"lastCommittedPoint": null,
			"startArrowhead": null,
			"endArrowhead": "arrow",
			"points": [
				[
					0,
					0
				],
				[
					1181.6356897493167,
					-1.0213550590110572
				]
			]
		},
		{
			"type": "text",
			"version": 132,
			"versionNonce": 1262083283,
			"isDeleted": false,
			"id": "0Bl0e0ep",
			"fillStyle": "cross-hatch",
			"strokeWidth": 2,
			"strokeStyle": "solid",
			"roughness": 1,
			"opacity": 100,
			"angle": 0,
			"x": -255.7138325022006,
			"y": 525.2860292387904,
			"strokeColor": "#1e1e1e",
			"backgroundColor": "#2f9e44",
			"width": 303.6318664550781,
			"height": 35,
			"seed": 1958836567,
			"groupIds": [],
			"frameId": null,
			"roundness": null,
			"boundElements": [],
			"updated": 1713283990357,
			"link": null,
			"locked": false,
			"fontSize": 28,
			"fontFamily": 1,
			"text": "Chronologischer Ablauf",
			"rawText": "Chronologischer Ablauf",
			"textAlign": "left",
			"verticalAlign": "top",
			"containerId": null,
			"originalText": "Chronologischer Ablauf",
			"lineHeight": 1.25,
			"baseline": 24
		},
		{
			"type": "rectangle",
			"version": 2090,
			"versionNonce": 1119946106,
			"isDeleted": false,
			"id": "3uqd_qDHaKBxe4-C8s80f",
			"fillStyle": "solid",
			"strokeWidth": 2,
			"strokeStyle": "solid",
			"roughness": 1,
			"opacity": 100,
			"angle": 0,
			"x": 116.01860911191898,
			"y": 579.3832877748237,
			"strokeColor": "#1e1e1e",
			"backgroundColor": "#a24db3",
			"width": 306.71636213538955,
			"height": 88.34217731905281,
			"seed": 611948249,
			"groupIds": [],
			"frameId": null,
			"roundness": null,
			"boundElements": [
				{
					"type": "text",
					"id": "91xgfZkR"
				}
			],
			"updated": 1713621432277,
			"link": null,
			"locked": false
		},
		{
			"type": "text",
			"version": 279,
			"versionNonce": 144872742,
			"isDeleted": false,
			"id": "91xgfZkR",
			"fillStyle": "cross-hatch",
			"strokeWidth": 2,
			"strokeStyle": "solid",
			"roughness": 1,
			"opacity": 100,
			"angle": 0,
			"x": 129.53084291398875,
			"y": 606.05437643435,
			"strokeColor": "#1e1e1e",
			"backgroundColor": "#a5d8ff",
			"width": 279.69189453125,
			"height": 35,
			"seed": 112415673,
			"groupIds": [],
			"frameId": null,
			"roundness": null,
			"boundElements": [],
			"updated": 1713621266230,
			"link": null,
			"locked": false,
			"fontSize": 28,
			"fontFamily": 1,
			"text": "Auswurf des Pakets",
			"rawText": "Auswurf des Pakets",
			"textAlign": "center",
			"verticalAlign": "middle",
			"containerId": "3uqd_qDHaKBxe4-C8s80f",
			"originalText": "Auswurf des Pakets",
			"lineHeight": 1.25,
			"baseline": 24
		},
		{
			"type": "arrow",
			"version": 1802,
			"versionNonce": 1730271034,
			"isDeleted": false,
			"id": "rwIKLI6oD7QsZDh410pNX",
			"fillStyle": "cross-hatch",
			"strokeWidth": 2,
			"strokeStyle": "solid",
			"roughness": 1,
			"opacity": 100,
			"angle": 0,
			"x": -281.63646638929526,
			"y": 314.1380543811083,
			"strokeColor": "#ac60bb",
			"backgroundColor": "#a24db3",
			"width": 114.67992764746133,
			"height": 1.838572989659623,
			"seed": 1420144151,
			"groupIds": [],
			"frameId": null,
			"roundness": {
				"type": 2
			},
			"boundElements": [],
			"updated": 1713621354767,
			"link": null,
			"locked": false,
			"startBinding": {
				"elementId": "DX3YGNneph1GhbdrnOERN",
				"focus": -0.20139508028569023,
				"gap": 10.51205330867026
			},
			"endBinding": {
				"elementId": "kKFZ5DPW21Cm-cpOk4Iz8",
				"focus": 0.4464512629956661,
				"gap": 12.127506114584776
			},
			"lastCommittedPoint": null,
			"startArrowhead": null,
			"endArrowhead": "arrow",
			"points": [
				[
					0,
					0
				],
				[
					-114.67992764746133,
					1.838572989659623
				]
			]
		},
		{
			"type": "rectangle",
			"version": 1096,
			"versionNonce": 575696762,
			"isDeleted": false,
			"id": "S_w9dui95pts119_kV0Dv",
			"fillStyle": "cross-hatch",
			"strokeWidth": 2,
			"strokeStyle": "solid",
			"roughness": 1,
			"opacity": 100,
			"angle": 0,
			"x": -609.0094558623721,
			"y": 34.86518616592366,
			"strokeColor": "#1e1e1e",
			"backgroundColor": "transparent",
			"width": 130.46913883547558,
			"height": 68.97415363929555,
			"seed": 1630399319,
			"groupIds": [],
			"frameId": null,
			"roundness": {
				"type": 3
			},
			"boundElements": [
				{
					"type": "text",
					"id": "PEwLsrSy"
				},
				{
					"id": "kYlvDfdaNfCjYDqsHAaG6",
					"type": "arrow"
				}
			],
			"updated": 1713621406408,
			"link": null,
			"locked": false
		},
		{
			"type": "text",
			"version": 1203,
			"versionNonce": 742944826,
			"isDeleted": false,
			"id": "PEwLsrSy",
			"fillStyle": "cross-hatch",
			"strokeWidth": 2,
			"strokeStyle": "solid",
			"roughness": 1,
			"opacity": 100,
			"angle": 0,
			"x": -602.2769186580271,
			"y": 50.51523617555979,
			"strokeColor": "#1e1e1e",
			"backgroundColor": "transparent",
			"width": 117.00406442678552,
			"height": 37.67405362002328,
			"seed": 1563605591,
			"groupIds": [],
			"frameId": null,
			"roundness": null,
			"boundElements": [],
			"updated": 1713621406408,
			"link": null,
			"locked": false,
			"fontSize": 30.139242896018626,
			"fontFamily": 1,
			"text": "Motoren",
			"rawText": "Motoren",
			"textAlign": "center",
			"verticalAlign": "middle",
			"containerId": "S_w9dui95pts119_kV0Dv",
			"originalText": "Motoren",
			"lineHeight": 1.25,
			"baseline": 26
		},
		{
			"type": "arrow",
			"version": 2742,
			"versionNonce": 1610688954,
			"isDeleted": false,
			"id": "kYlvDfdaNfCjYDqsHAaG6",
			"fillStyle": "cross-hatch",
			"strokeWidth": 2,
			"strokeStyle": "solid",
			"roughness": 1,
			"opacity": 100,
			"angle": 0,
			"x": -476.4970555485426,
			"y": 253.3712168211327,
			"strokeColor": "#ac60bb",
			"backgroundColor": "transparent",
			"width": 42.291433014047755,
			"height": 141.22169161804413,
			"seed": 741530681,
			"groupIds": [],
			"frameId": null,
			"roundness": {
				"type": 2
			},
			"boundElements": [
				{
					"type": "text",
					"id": "8N4p45W7"
				}
			],
			"updated": 1713621406409,
			"link": null,
			"locked": false,
			"startBinding": {
				"elementId": "kKFZ5DPW21Cm-cpOk4Iz8",
				"focus": 0.15932289672798275,
				"gap": 7.795821987876451
			},
			"endBinding": {
				"elementId": "S_w9dui95pts119_kV0Dv",
				"focus": -0.16105863726582217,
				"gap": 8.310185397869333
			},
			"lastCommittedPoint": null,
			"startArrowhead": null,
			"endArrowhead": "arrow",
			"points": [
				[
					0,
					0
				],
				[
					-42.291433014047755,
					-141.22169161804413
				]
			]
		},
		{
			"type": "text",
			"version": 368,
			"versionNonce": 1365488826,
			"isDeleted": false,
			"id": "8N4p45W7",
			"fillStyle": "cross-hatch",
			"strokeWidth": 2,
			"strokeStyle": "solid",
			"roughness": 1,
			"opacity": 100,
			"angle": 0,
			"x": -605.9848596036967,
			"y": 181.83443378337796,
			"strokeColor": "#1e1e1e",
			"backgroundColor": "transparent",
			"width": 201.55984497070312,
			"height": 50,
			"seed": 1111654871,
			"groupIds": [],
			"frameId": null,
			"roundness": null,
			"boundElements": [],
			"updated": 1713621405994,
			"link": null,
			"locked": false,
			"fontSize": 20,
			"fontFamily": 1,
			"text": "Ansteuerung für\nAusgabe (DRV8825)",
			"rawText": "Ansteuerung für Ausgabe (DRV8825)",
			"textAlign": "center",
			"verticalAlign": "middle",
			"containerId": "kYlvDfdaNfCjYDqsHAaG6",
			"originalText": "Ansteuerung für Ausgabe (DRV8825)",
			"lineHeight": 1.25,
			"baseline": 43
		},
		{
			"type": "line",
			"version": 134,
			"versionNonce": 1247551742,
			"isDeleted": false,
			"id": "6Ic4jeUviPgZBXNddC4EE",
			"fillStyle": "cross-hatch",
			"strokeWidth": 4,
			"strokeStyle": "dashed",
			"roughness": 1,
			"opacity": 100,
			"angle": 0,
			"x": 109.5666138382071,
			"y": 532.2343405793366,
			"strokeColor": "#1e1e1e",
			"backgroundColor": "transparent",
			"width": 2.2737367544323206e-13,
			"height": 172.71405329369702,
			"seed": 504445625,
			"groupIds": [],
			"frameId": null,
			"roundness": {
				"type": 2
			},
			"boundElements": [],
			"updated": 1707804240168,
			"link": null,
			"locked": false,
			"startBinding": null,
			"endBinding": null,
			"lastCommittedPoint": null,
			"startArrowhead": null,
			"endArrowhead": null,
			"points": [
				[
					0,
					0
				],
				[
					2.2737367544323206e-13,
					172.71405329369702
				]
			]
		},
		{
			"type": "text",
			"version": 173,
			"versionNonce": 58543581,
			"isDeleted": false,
			"id": "G4jO4sLS",
			"fillStyle": "cross-hatch",
			"strokeWidth": 4,
			"strokeStyle": "dashed",
			"roughness": 1,
			"opacity": 100,
			"angle": 0,
			"x": 23.209473596226644,
			"y": 716.8596765567004,
			"strokeColor": "#1e1e1e",
			"backgroundColor": "transparent",
			"width": 189.6598358154297,
			"height": 25,
			"seed": 105935321,
			"groupIds": [],
			"frameId": null,
			"roundness": null,
			"boundElements": [],
			"updated": 1713283990357,
			"link": null,
			"locked": false,
			"fontSize": 20,
			"fontFamily": 1,
			"text": "Befehl für Ausgabe",
			"rawText": "Befehl für Ausgabe",
			"textAlign": "left",
			"verticalAlign": "top",
			"containerId": null,
			"originalText": "Befehl für Ausgabe",
			"lineHeight": 1.25,
			"baseline": 18
		},
		{
			"type": "text",
			"version": 188,
			"versionNonce": 2016201331,
			"isDeleted": false,
			"id": "tA4B3B7l",
			"fillStyle": "cross-hatch",
			"strokeWidth": 4,
			"strokeStyle": "dashed",
			"roughness": 1,
			"opacity": 100,
			"angle": 0,
			"x": -352.7115761070668,
			"y": 817.6989749606755,
			"strokeColor": "#6899db",
			"backgroundColor": "transparent",
			"width": 386.5318908691406,
			"height": 45,
			"seed": 1801898713,
			"groupIds": [],
			"frameId": null,
			"roundness": null,
			"boundElements": [],
			"updated": 1713283990358,
			"link": null,
			"locked": false,
			"fontSize": 36,
			"fontFamily": 1,
			"text": "Erkennung des Pakets",
			"rawText": "Erkennung des Pakets",
			"textAlign": "left",
			"verticalAlign": "top",
			"containerId": null,
			"originalText": "Erkennung des Pakets",
			"lineHeight": 1.25,
			"baseline": 32
		},
		{
			"type": "line",
			"version": 557,
			"versionNonce": 370171238,
			"isDeleted": false,
			"id": "0nkB1y4lMFuZ9I8tCZUSZ",
			"fillStyle": "cross-hatch",
			"strokeWidth": 4,
			"strokeStyle": "dashed",
			"roughness": 1,
			"opacity": 100,
			"angle": 0,
			"x": -342.3004980320417,
			"y": 227.609770475411,
			"strokeColor": "#1e1e1e",
			"backgroundColor": "transparent",
			"width": 0,
			"height": 152.07551625775764,
			"seed": 2056949367,
			"groupIds": [],
			"frameId": null,
			"roundness": {
				"type": 2
			},
			"boundElements": [],
			"updated": 1713621354702,
			"link": null,
			"locked": false,
			"startBinding": null,
			"endBinding": null,
			"lastCommittedPoint": null,
			"startArrowhead": null,
			"endArrowhead": null,
			"points": [
				[
					0,
					0
				],
				[
					0,
					152.07551625775764
				]
			]
		},
		{
			"type": "text",
			"version": 1068,
			"versionNonce": 263259155,
			"isDeleted": false,
			"id": "02Cdh0ey",
			"fillStyle": "cross-hatch",
			"strokeWidth": 4,
			"strokeStyle": "dashed",
			"roughness": 1,
			"opacity": 100,
			"angle": 0,
			"x": -680.3810901383096,
			"y": 870.9892231815666,
			"strokeColor": "#1e1e1e",
			"backgroundColor": "transparent",
			"width": 1096.2191162109375,
			"height": 100,
			"seed": 1394280153,
			"groupIds": [],
			"frameId": null,
			"roundness": null,
			"boundElements": [],
			"updated": 1713283990359,
			"link": null,
			"locked": false,
			"fontSize": 20,
			"fontFamily": 1,
			"text": "Mit dem QR-Code-Scanner wird die ID des Pakets eingelesen und über die serielle Schnittstelle an das\nHauptprogramm(Computer) weiter gegeben. Von dort aus wird eine Anfrage an die SQL Datenbank \nfür die eingelesene ID gestartet. Die Datenbank antwortet mit allen Parameter(Eigenschaften) des Paketes. \n ",
			"rawText": "Mit dem QR-Code-Scanner wird die ID des Pakets eingelesen und über die serielle Schnittstelle an das\nHauptprogramm(Computer) weiter gegeben. Von dort aus wird eine Anfrage an die SQL Datenbank \nfür die eingelesene ID gestartet. Die Datenbank antwortet mit allen Parameter(Eigenschaften) des Paketes. \n ",
			"textAlign": "left",
			"verticalAlign": "top",
			"containerId": null,
			"originalText": "Mit dem QR-Code-Scanner wird die ID des Pakets eingelesen und über die serielle Schnittstelle an das\nHauptprogramm(Computer) weiter gegeben. Von dort aus wird eine Anfrage an die SQL Datenbank \nfür die eingelesene ID gestartet. Die Datenbank antwortet mit allen Parameter(Eigenschaften) des Paketes. \n ",
			"lineHeight": 1.25,
			"baseline": 93
		},
		{
			"type": "text",
			"version": 628,
			"versionNonce": 1420154470,
			"isDeleted": false,
			"id": "xPRjny8z",
			"fillStyle": "cross-hatch",
			"strokeWidth": 4,
			"strokeStyle": "dashed",
			"roughness": 1,
			"opacity": 100,
			"angle": 0,
			"x": -456.56921082098654,
			"y": 383.92545436894954,
			"strokeColor": "#1e1e1e",
			"backgroundColor": "transparent",
			"width": 200.1398383246528,
			"height": 50,
			"seed": 34454615,
			"groupIds": [],
			"frameId": null,
			"roundness": null,
			"boundElements": [],
			"updated": 1713621396555,
			"link": null,
			"locked": false,
			"fontSize": 20,
			"fontFamily": 1,
			"text": "serielle Schnittstelle\n(USB)",
			"rawText": "serielle Schnittstelle\n(USB)",
			"textAlign": "center",
			"verticalAlign": "top",
			"containerId": null,
			"originalText": "serielle Schnittstelle\n(USB)",
			"lineHeight": 1.25,
			"baseline": 42
		},
		{
			"type": "text",
			"version": 182,
			"versionNonce": 1121925789,
			"isDeleted": false,
			"id": "G9FhOb90",
			"fillStyle": "cross-hatch",
			"strokeWidth": 4,
			"strokeStyle": "dashed",
			"roughness": 1,
			"opacity": 100,
			"angle": 0,
			"x": -401.62731043242695,
			"y": 1003.4017013159043,
			"strokeColor": "#2f9e44",
			"backgroundColor": "transparent",
			"width": 563.867578125,
			"height": 45,
			"seed": 804287033,
			"groupIds": [],
			"frameId": null,
			"roundness": null,
			"boundElements": [],
			"updated": 1713283990359,
			"link": null,
			"locked": false,
			"fontSize": 36,
			"fontFamily": 1,
			"text": "Indikator für Paket Einlagerung",
			"rawText": "Indikator für Paket Einlagerung",
			"textAlign": "left",
			"verticalAlign": "top",
			"containerId": null,
			"originalText": "Indikator für Paket Einlagerung",
			"lineHeight": 1.25,
			"baseline": 32
		},
		{
			"type": "text",
			"version": 691,
			"versionNonce": 1237125555,
			"isDeleted": false,
			"id": "y374fQq5",
			"fillStyle": "cross-hatch",
			"strokeWidth": 4,
			"strokeStyle": "dashed",
			"roughness": 1,
			"opacity": 100,
			"angle": 0,
			"x": -677.5315172857876,
			"y": 1257.1060346635,
			"strokeColor": "#1e1e1e",
			"backgroundColor": "transparent",
			"width": 1080.71923828125,
			"height": 50,
			"seed": 1522736889,
			"groupIds": [],
			"frameId": null,
			"roundness": null,
			"boundElements": [],
			"updated": 1713283990359,
			"link": null,
			"locked": false,
			"fontSize": 20,
			"fontFamily": 1,
			"text": "Im Hauptprogramm wird ein Objekt für jedes Paket erstellt, dass die Parameter der Datenbank übernimmt.\nJedes Paket hat eine mit der Fälligkeitsdatum berechnete Ablaufzeit, nach der sortiert und eingelagert wird.",
			"rawText": "Im Hauptprogramm wird ein Objekt für jedes Paket erstellt, dass die Parameter der Datenbank übernimmt.\nJedes Paket hat eine mit der Fälligkeitsdatum berechnete Ablaufzeit, nach der sortiert und eingelagert wird.",
			"textAlign": "left",
			"verticalAlign": "top",
			"containerId": null,
			"originalText": "Im Hauptprogramm wird ein Objekt für jedes Paket erstellt, dass die Parameter der Datenbank übernimmt.\nJedes Paket hat eine mit der Fälligkeitsdatum berechnete Ablaufzeit, nach der sortiert und eingelagert wird.",
			"lineHeight": 1.25,
			"baseline": 43
		},
		{
			"type": "text",
			"version": 533,
			"versionNonce": 62381821,
			"isDeleted": false,
			"id": "UvIh0cjj",
			"fillStyle": "cross-hatch",
			"strokeWidth": 4,
			"strokeStyle": "dashed",
			"roughness": 1,
			"opacity": 100,
			"angle": 0,
			"x": -684.3205895821715,
			"y": 1056.604674069331,
			"strokeColor": "#1e1e1e",
			"backgroundColor": "transparent",
			"width": 1107.0791015625,
			"height": 75,
			"seed": 1601363575,
			"groupIds": [],
			"frameId": null,
			"roundness": null,
			"boundElements": [],
			"updated": 1713283990360,
			"link": null,
			"locked": false,
			"fontSize": 20,
			"fontFamily": 1,
			"text": "Das Hauptprogramm bestimmt das Regal in dem das Paket eingelagert werden soll um einen möglichst effizienten\nAblauf des Prozesses zu ermöglichen. Damit das Paket richtig eingelagert wird,\nwird mithilfe von an den Regalen installierten LEDs das richtige Regal gekennzeichnet.",
			"rawText": "Das Hauptprogramm bestimmt das Regal in dem das Paket eingelagert werden soll um einen möglichst effizienten\nAblauf des Prozesses zu ermöglichen. Damit das Paket richtig eingelagert wird,\nwird mithilfe von an den Regalen installierten LEDs das richtige Regal gekennzeichnet.",
			"textAlign": "left",
			"verticalAlign": "top",
			"containerId": null,
			"originalText": "Das Hauptprogramm bestimmt das Regal in dem das Paket eingelagert werden soll um einen möglichst effizienten\nAblauf des Prozesses zu ermöglichen. Damit das Paket richtig eingelagert wird,\nwird mithilfe von an den Regalen installierten LEDs das richtige Regal gekennzeichnet.",
			"lineHeight": 1.25,
			"baseline": 68
		},
		{
			"type": "text",
			"version": 153,
			"versionNonce": 460806995,
			"isDeleted": false,
			"id": "yW1fCZkD",
			"fillStyle": "cross-hatch",
			"strokeWidth": 4,
			"strokeStyle": "dashed",
			"roughness": 1,
			"opacity": 100,
			"angle": 0,
			"x": -589.7908138896433,
			"y": 1200.036734315411,
			"strokeColor": "#e03131",
			"backgroundColor": "transparent",
			"width": 905.291180419922,
			"height": 45,
			"seed": 1288928311,
			"groupIds": [],
			"frameId": null,
			"roundness": null,
			"boundElements": [],
			"updated": 1713283990360,
			"link": null,
			"locked": false,
			"fontSize": 36,
			"fontFamily": 1,
			"text": "Erstellen eines Objektes für den Timer des Pakets",
			"rawText": "Erstellen eines Objektes für den Timer des Pakets",
			"textAlign": "left",
			"verticalAlign": "top",
			"containerId": null,
			"originalText": "Erstellen eines Objektes für den Timer des Pakets",
			"lineHeight": 1.25,
			"baseline": 32
		},
		{
			"type": "text",
			"version": 55,
			"versionNonce": 2126313309,
			"isDeleted": false,
			"id": "pecoTU0e",
			"fillStyle": "cross-hatch",
			"strokeWidth": 4,
			"strokeStyle": "dashed",
			"roughness": 1,
			"opacity": 100,
			"angle": 0,
			"x": -329.0524718630993,
			"y": 1353.8482584502433,
			"strokeColor": "#a24db3",
			"backgroundColor": "transparent",
			"width": 359.60386439732144,
			"height": 45,
			"seed": 1152218039,
			"groupIds": [],
			"frameId": null,
			"roundness": null,
			"boundElements": [],
			"updated": 1713283990360,
			"link": null,
			"locked": false,
			"fontSize": 36,
			"fontFamily": 1,
			"text": "Auswurf des Pakets",
			"rawText": "Auswurf des Pakets",
			"textAlign": "left",
			"verticalAlign": "top",
			"containerId": null,
			"originalText": "Auswurf des Pakets",
			"lineHeight": 1.25,
			"baseline": 32
		},
		{
			"type": "text",
			"version": 418,
			"versionNonce": 288782579,
			"isDeleted": false,
			"id": "S9WYBtKL",
			"fillStyle": "cross-hatch",
			"strokeWidth": 4,
			"strokeStyle": "dashed",
			"roughness": 1,
			"opacity": 100,
			"angle": 0,
			"x": -666.0211849185891,
			"y": 1427.5789124840796,
			"strokeColor": "#1e1e1e",
			"backgroundColor": "transparent",
			"width": 952.09912109375,
			"height": 75,
			"seed": 1510492151,
			"groupIds": [],
			"frameId": null,
			"roundness": null,
			"boundElements": [],
			"updated": 1713283990361,
			"link": null,
			"locked": false,
			"fontSize": 20,
			"fontFamily": 1,
			"text": "Mit dem Auswurfbefehl kann die gewollte Anzahl an Pakete ausgeworfen werden. Die Reihenfolge,\nin der die Pakete ausgeworfen werden, beginnt mit dem Paket, das die kürzeste Ablaufzeit hat \nund steigt dann auf.",
			"rawText": "Mit dem Auswurfbefehl kann die gewollte Anzahl an Pakete ausgeworfen werden. Die Reihenfolge,\nin der die Pakete ausgeworfen werden, beginnt mit dem Paket, das die kürzeste Ablaufzeit hat \nund steigt dann auf.",
			"textAlign": "left",
			"verticalAlign": "top",
			"containerId": null,
			"originalText": "Mit dem Auswurfbefehl kann die gewollte Anzahl an Pakete ausgeworfen werden. Die Reihenfolge,\nin der die Pakete ausgeworfen werden, beginnt mit dem Paket, das die kürzeste Ablaufzeit hat \nund steigt dann auf.",
			"lineHeight": 1.25,
			"baseline": 68
		}
	],
	"appState": {
		"theme": "dark",
		"viewBackgroundColor": "#ffffff",
		"currentItemStrokeColor": "#1e1e1e",
		"currentItemBackgroundColor": "transparent",
		"currentItemFillStyle": "solid",
		"currentItemStrokeWidth": 4,
		"currentItemStrokeStyle": "dashed",
		"currentItemRoughness": 1,
		"currentItemOpacity": 100,
		"currentItemFontFamily": 1,
		"currentItemFontSize": 20,
		"currentItemTextAlign": "left",
		"currentItemStartArrowhead": null,
		"currentItemEndArrowhead": "arrow",
		"scrollX": 1757.0624397172985,
		"scrollY": 314.1242133661817,
		"zoom": {
			"value": 0.44999999999999996
		},
		"currentItemRoundness": "round",
		"gridSize": null,
		"gridColor": {
			"Bold": "#C9C9C9FF",
			"Regular": "#EDEDEDFF"
		},
		"currentStrokeOptions": null,
		"previousGridSize": null,
		"frameRendering": {
			"enabled": true,
			"clip": true,
			"name": true,
			"outline": true
		}
	},
	"files": {}
}
```
%%
