SheepSupreme/AIAS/Dokumentationen/GUI.md

---

excalidraw-plugin: parsed
tags: [excalidraw]

---
==⚠  Switch to EXCALIDRAW VIEW in the MORE OPTIONS menu of this document. ⚠==

# Text Elements
0% ^HG2lM63A

100% ^2zON6Bxn

66% ^v4vrbm7N

Kapazitäten ^YVBg7Rj1

Ausgabe ^cqb3AqUp

Ausgabe ^MANhjB0o

-3:00 ^LjcQMfYn

´+1:00 ^K0e9iRDJ

ID ^cseioxCa

3 ^smJjZ8gA

%%
# Drawing
```json
{
	"type": "excalidraw",
	"version": 2,
	"source": "https://github.com/zsviczian/obsidian-excalidraw-plugin/releases/tag/2.0.20",
	"elements": [
		{
			"type": "rectangle",
			"version": 168,
			"versionNonce": 869692621,
			"isDeleted": false,
			"id": "xctDOZGCutZly7FssOwDq",
			"fillStyle": "solid",
			"strokeWidth": 2,
			"strokeStyle": "solid",
			"roughness": 1,
			"opacity": 100,
			"angle": 0,
			"x": -287.49435422584884,
			"y": -405.9262480759958,
			"strokeColor": "#1e1e1e",
			"backgroundColor": "transparent",
			"width": 38.52691385623654,
			"height": 56.003029263774174,
			"seed": 702825827,
			"groupIds": [],
			"frameId": null,
			"roundness": {
				"type": 3
			},
			"boundElements": [],
			"updated": 1708071712578,
			"link": null,
			"locked": false
		},
		{
			"type": "rectangle",
			"version": 203,
			"versionNonce": 271078189,
			"isDeleted": false,
			"id": "ea0-Ps-9vbDlC47QHVz-8",
			"fillStyle": "solid",
			"strokeWidth": 2,
			"strokeStyle": "solid",
			"roughness": 1,
			"opacity": 100,
			"angle": 0,
			"x": -244.20122156705048,
			"y": -405.1318757503368,
			"strokeColor": "#1e1e1e",
			"backgroundColor": "#ffc9c9",
			"width": 38.92410759476197,
			"height": 52.82555511253024,
			"seed": 77308163,
			"groupIds": [],
			"frameId": null,
			"roundness": {
				"type": 3
			},
			"boundElements": [],
			"updated": 1708071712578,
			"link": null,
			"locked": false
		},
		{
			"type": "rectangle",
			"version": 232,
			"versionNonce": 393176461,
			"isDeleted": false,
			"id": "77lOZVYiRJ00DPxsK2evd",
			"fillStyle": "solid",
			"strokeWidth": 2,
			"strokeStyle": "solid",
			"roughness": 1,
			"opacity": 100,
			"angle": 0,
			"x": -196.73765313778233,
			"y": -406.1248449452585,
			"strokeColor": "#1e1e1e",
			"backgroundColor": "transparent",
			"width": 38.92410759476197,
			"height": 52.82555511253024,
			"seed": 858163363,
			"groupIds": [],
			"frameId": null,
			"roundness": {
				"type": 3
			},
			"boundElements": [],
			"updated": 1708071712578,
			"link": null,
			"locked": false
		},
		{
			"type": "text",
			"version": 125,
			"versionNonce": 484781037,
			"isDeleted": false,
			"id": "HG2lM63A",
			"fillStyle": "solid",
			"strokeWidth": 2,
			"strokeStyle": "solid",
			"roughness": 1,
			"opacity": 100,
			"angle": 0,
			"x": -276.7703657079327,
			"y": -344.75982142252616,
			"strokeColor": "#1e1e1e",
			"backgroundColor": "transparent",
			"width": 16.14801038351248,
			"height": 12.412020240321572,
			"seed": 187923523,
			"groupIds": [],
			"frameId": null,
			"roundness": null,
			"boundElements": [],
			"updated": 1708071712578,
			"link": null,
			"locked": false,
			"fontSize": 9.92961619225726,
			"fontFamily": 1,
			"text": "0%",
			"rawText": "0%",
			"textAlign": "left",
			"verticalAlign": "top",
			"containerId": null,
			"originalText": "0%",
			"lineHeight": 1.25,
			"baseline": 8.999999999999996
		},
		{
			"type": "text",
			"version": 144,
			"versionNonce": 1351820877,
			"isDeleted": false,
			"id": "2zON6Bxn",
			"fillStyle": "solid",
			"strokeWidth": 2,
			"strokeStyle": "solid",
			"roughness": 1,
			"opacity": 100,
			"angle": 0,
			"x": -239.43498761309667,
			"y": -345.9513723353187,
			"strokeColor": "#1e1e1e",
			"backgroundColor": "transparent",
			"width": 25.66610315460107,
			"height": 12.412020240321572,
			"seed": 681638883,
			"groupIds": [],
			"frameId": null,
			"roundness": null,
			"boundElements": [],
			"updated": 1708071712578,
			"link": null,
			"locked": false,
			"fontSize": 9.929616192257258,
			"fontFamily": 1,
			"text": "100%",
			"rawText": "100%",
			"textAlign": "left",
			"verticalAlign": "top",
			"containerId": null,
			"originalText": "100%",
			"lineHeight": 1.25,
			"baseline": 9
		},
		{
			"type": "text",
			"version": 161,
			"versionNonce": 626185389,
			"isDeleted": false,
			"id": "v4vrbm7N",
			"fillStyle": "solid",
			"strokeWidth": 2,
			"strokeStyle": "solid",
			"roughness": 1,
			"opacity": 100,
			"angle": 0,
			"x": -188.99256462893527,
			"y": -347.5401018352447,
			"strokeColor": "#1e1e1e",
			"backgroundColor": "transparent",
			"width": 22.023618088922813,
			"height": 12.412020240321569,
			"seed": 662538115,
			"groupIds": [],
			"frameId": null,
			"roundness": null,
			"boundElements": [],
			"updated": 1708071712578,
			"link": null,
			"locked": false,
			"fontSize": 9.929616192257257,
			"fontFamily": 1,
			"text": "66%",
			"rawText": "66%",
			"textAlign": "left",
			"verticalAlign": "top",
			"containerId": null,
			"originalText": "66%",
			"lineHeight": 1.25,
			"baseline": 8.999999999999998
		},
		{
			"type": "rectangle",
			"version": 178,
			"versionNonce": 1993193229,
			"isDeleted": false,
			"id": "f8Hh2zigXmqwAzxZFc04X",
			"fillStyle": "solid",
			"strokeWidth": 2,
			"strokeStyle": "solid",
			"roughness": 1,
			"opacity": 100,
			"angle": 0,
			"x": -194.55312545437226,
			"y": -385.6698371043477,
			"strokeColor": "#1e1e1e",
			"backgroundColor": "#ffc9c9",
			"width": 33.76069505367468,
			"height": 31.377593228089694,
			"seed": 503815971,
			"groupIds": [],
			"frameId": null,
			"roundness": {
				"type": 3
			},
			"boundElements": [],
			"updated": 1708071712578,
			"link": null,
			"locked": false
		},
		{
			"type": "text",
			"version": 89,
			"versionNonce": 1870482797,
			"isDeleted": false,
			"id": "YVBg7Rj1",
			"fillStyle": "solid",
			"strokeWidth": 2,
			"strokeStyle": "solid",
			"roughness": 1,
			"opacity": 100,
			"angle": 0,
			"x": -259.69141373613667,
			"y": -423.79957237345076,
			"strokeColor": "#1e1e1e",
			"backgroundColor": "#ffc9c9",
			"width": 59.966943971554954,
			"height": 12.412020240321572,
			"seed": 1454228163,
			"groupIds": [],
			"frameId": null,
			"roundness": null,
			"boundElements": [],
			"updated": 1708071712578,
			"link": null,
			"locked": false,
			"fontSize": 9.929616192257258,
			"fontFamily": 1,
			"text": "Kapazitäten",
			"rawText": "Kapazitäten",
			"textAlign": "left",
			"verticalAlign": "top",
			"containerId": null,
			"originalText": "Kapazitäten",
			"lineHeight": 1.25,
			"baseline": 8.999999999999998
		},
		{
			"type": "rectangle",
			"version": 220,
			"versionNonce": 782964685,
			"isDeleted": false,
			"id": "wuqCbhwrTcXg6PSKgTvq2",
			"fillStyle": "solid",
			"strokeWidth": 2,
			"strokeStyle": "solid",
			"roughness": 1,
			"opacity": 100,
			"angle": 0,
			"x": -302.98911709764405,
			"y": -306.9515215370102,
			"strokeColor": "#1e1e1e",
			"backgroundColor": "#a5d8ff",
			"width": 180.3172929094577,
			"height": 80.56731077482667,
			"seed": 1242460771,
			"groupIds": [],
			"frameId": null,
			"roundness": {
				"type": 3
			},
			"boundElements": [],
			"updated": 1708071712578,
			"link": null,
			"locked": false
		},
		{
			"type": "text",
			"version": 192,
			"versionNonce": 779130413,
			"isDeleted": false,
			"id": "cqb3AqUp",
			"fillStyle": "solid",
			"strokeWidth": 2,
			"strokeStyle": "solid",
			"roughness": 1,
			"opacity": 100,
			"angle": 0,
			"x": -266.0422922822438,
			"y": -300.7149259734908,
			"strokeColor": "#1e1e1e",
			"backgroundColor": "#a5d8ff",
			"width": 42.49782671215059,
			"height": 13.321310848034816,
			"seed": 1492659715,
			"groupIds": [],
			"frameId": null,
			"roundness": null,
			"boundElements": [],
			"updated": 1708071712578,
			"link": null,
			"locked": false,
			"fontSize": 10.657048678427852,
			"fontFamily": 1,
			"text": "Ausgabe",
			"rawText": "Ausgabe",
			"textAlign": "left",
			"verticalAlign": "top",
			"containerId": null,
			"originalText": "Ausgabe",
			"lineHeight": 1.25,
			"baseline": 9.000000000000002
		},
		{
			"type": "rectangle",
			"version": 136,
			"versionNonce": 207347885,
			"isDeleted": false,
			"id": "FFZcf_NIltSOVnlx8hUBL",
			"fillStyle": "solid",
			"strokeWidth": 2,
			"strokeStyle": "solid",
			"roughness": 0,
			"opacity": 100,
			"angle": 0,
			"x": 0.5701680884945972,
			"y": -429.18338708797415,
			"strokeColor": "transparent",
			"backgroundColor": "#f8f9fa",
			"width": 183.3478079602796,
			"height": 236.88739530570493,
			"seed": 1565828579,
			"groupIds": [],
			"frameId": null,
			"roundness": {
				"type": 3
			},
			"boundElements": [],
			"updated": 1708071757236,
			"link": null,
			"locked": false
		},
		{
			"type": "text",
			"version": 67,
			"versionNonce": 1111011053,
			"isDeleted": false,
			"id": "MANhjB0o",
			"fillStyle": "solid",
			"strokeWidth": 2,
			"strokeStyle": "solid",
			"roughness": 1,
			"opacity": 100,
			"angle": 0,
			"x": 71.2828153514709,
			"y": -420.09174559717195,
			"strokeColor": "#1e1e1e",
			"backgroundColor": "#a5d8ff",
			"width": 50.35456412159855,
			"height": 15.784073049771502,
			"seed": 1905314115,
			"groupIds": [],
			"frameId": null,
			"roundness": null,
			"boundElements": [],
			"updated": 1708071712578,
			"link": null,
			"locked": false,
			"fontSize": 12.6272584398172,
			"fontFamily": 1,
			"text": "Ausgabe",
			"rawText": "Ausgabe",
			"textAlign": "left",
			"verticalAlign": "top",
			"containerId": null,
			"originalText": "Ausgabe",
			"lineHeight": 1.25,
			"baseline": 11.000000000000002
		},
		{
			"type": "rectangle",
			"version": 134,
			"versionNonce": 645810509,
			"isDeleted": false,
			"id": "y3YGNUIgwPXAlinSA8j70",
			"fillStyle": "solid",
			"strokeWidth": 2,
			"strokeStyle": "solid",
			"roughness": 1,
			"opacity": 100,
			"angle": 0,
			"x": 6.631236725473002,
			"y": -383.2201548064392,
			"strokeColor": "#1e1e1e",
			"backgroundColor": "#a5d8ff",
			"width": 169.71038425941086,
			"height": 24.749414981441337,
			"seed": 1338812643,
			"groupIds": [],
			"frameId": null,
			"roundness": null,
			"boundElements": [],
			"updated": 1708071712578,
			"link": null,
			"locked": false
		},
		{
			"type": "rectangle",
			"version": 206,
			"versionNonce": 2011273133,
			"isDeleted": false,
			"id": "h5VDtxw_GBJ5HyKK9Qqx1",
			"fillStyle": "solid",
			"strokeWidth": 2,
			"strokeStyle": "solid",
			"roughness": 1,
			"opacity": 100,
			"angle": 0,
			"x": 6.883681702399429,
			"y": -324.7559347427184,
			"strokeColor": "#1e1e1e",
			"backgroundColor": "#ffc9c9",
			"width": 169.71038425941086,
			"height": 24.749414981441337,
			"seed": 648778883,
			"groupIds": [],
			"frameId": null,
			"roundness": null,
			"boundElements": [],
			"updated": 1708071712578,
			"link": null,
			"locked": false
		},
		{
			"type": "rectangle",
			"version": 205,
			"versionNonce": 814488077,
			"isDeleted": false,
			"id": "WiwKvuhllyg51pVJNgRa_",
			"fillStyle": "solid",
			"strokeWidth": 2,
			"strokeStyle": "solid",
			"roughness": 1,
			"opacity": 100,
			"angle": 0,
			"x": 7.388879938928994,
			"y": -354.55629163542125,
			"strokeColor": "#1e1e1e",
			"backgroundColor": "#a5d8ff",
			"width": 169.71038425941086,
			"height": 24.749414981441337,
			"seed": 99355683,
			"groupIds": [],
			"frameId": null,
			"roundness": null,
			"boundElements": [],
			"updated": 1708071712578,
			"link": null,
			"locked": false
		},
		{
			"type": "line",
			"version": 128,
			"versionNonce": 1232556141,
			"isDeleted": false,
			"id": "sT676lSPdHpkm0gOoyVXb",
			"fillStyle": "solid",
			"strokeWidth": 2,
			"strokeStyle": "solid",
			"roughness": 1,
			"opacity": 100,
			"angle": 0,
			"x": 2.5905371459322737,
			"y": -329.68058672868113,
			"strokeColor": "#e03131",
			"backgroundColor": "#a5d8ff",
			"width": 177.2867007879666,
			"height": 2.020369057437671,
			"seed": 24940483,
			"groupIds": [],
			"frameId": null,
			"roundness": null,
			"boundElements": [],
			"updated": 1708071712578,
			"link": null,
			"locked": false,
			"startBinding": null,
			"endBinding": null,
			"lastCommittedPoint": null,
			"startArrowhead": null,
			"endArrowhead": null,
			"points": [
				[
					0,
					0
				],
				[
					177.2867007879666,
					2.020369057437671
				]
			]
		},
		{
			"type": "text",
			"version": 112,
			"versionNonce": 1617738445,
			"isDeleted": false,
			"id": "LjcQMfYn",
			"fillStyle": "solid",
			"strokeWidth": 2,
			"strokeStyle": "solid",
			"roughness": 1,
			"opacity": 100,
			"angle": 0,
			"x": 120.27656268382782,
			"y": -379.17943595923117,
			"strokeColor": "#1e1e1e",
			"backgroundColor": "#ffc9c9",
			"width": 34.21984917747059,
			"height": 15.784073049771502,
			"seed": 729522019,
			"groupIds": [],
			"frameId": null,
			"roundness": null,
			"boundElements": [],
			"updated": 1708071712578,
			"link": null,
			"locked": false,
			"fontSize": 12.627258439817204,
			"fontFamily": 1,
			"text": "-3:00",
			"rawText": "-3:00",
			"textAlign": "left",
			"verticalAlign": "top",
			"containerId": null,
			"originalText": "-3:00",
			"lineHeight": 1.25,
			"baseline": 10.999999999999996
		},
		{
			"type": "text",
			"version": 69,
			"versionNonce": 503699757,
			"isDeleted": false,
			"id": "K0e9iRDJ",
			"fillStyle": "solid",
			"strokeWidth": 2,
			"strokeStyle": "solid",
			"roughness": 1,
			"opacity": 100,
			"angle": 0,
			"x": 121.79184911073975,
			"y": -318.06351281758276,
			"strokeColor": "#1e1e1e",
			"backgroundColor": "#ffc9c9",
			"width": 35.053252858738674,
			"height": 15.784073049771502,
			"seed": 1312275203,
			"groupIds": [],
			"frameId": null,
			"roundness": null,
			"boundElements": [],
			"updated": 1708071712578,
			"link": null,
			"locked": false,
			"fontSize": 12.6272584398172,
			"fontFamily": 1,
			"text": "´+1:00",
			"rawText": "´+1:00",
			"textAlign": "left",
			"verticalAlign": "top",
			"containerId": null,
			"originalText": "´+1:00",
			"lineHeight": 1.25,
			"baseline": 11
		},
		{
			"type": "text",
			"version": 61,
			"versionNonce": 1538009997,
			"isDeleted": false,
			"id": "cseioxCa",
			"fillStyle": "solid",
			"strokeWidth": 2,
			"strokeStyle": "solid",
			"roughness": 1,
			"opacity": 100,
			"angle": 0,
			"x": 22.79415064963979,
			"y": -376.6539842712677,
			"strokeColor": "#1e1e1e",
			"backgroundColor": "#ffc9c9",
			"width": 16.731107798924143,
			"height": 15.784073049771502,
			"seed": 1714381475,
			"groupIds": [],
			"frameId": null,
			"roundness": null,
			"boundElements": [],
			"updated": 1708071712578,
			"link": null,
			"locked": false,
			"fontSize": 12.6272584398172,
			"fontFamily": 1,
			"text": "ID",
			"rawText": "ID",
			"textAlign": "left",
			"verticalAlign": "top",
			"containerId": null,
			"originalText": "ID",
			"lineHeight": 1.25,
			"baseline": 11
		},
		{
			"type": "rectangle",
			"version": 109,
			"versionNonce": 161034733,
			"isDeleted": false,
			"id": "Bx5XYMa-K_9g02QtRyNib",
			"fillStyle": "solid",
			"strokeWidth": 2,
			"strokeStyle": "solid",
			"roughness": 1,
			"opacity": 100,
			"angle": 0,
			"x": -294.40259677270217,
			"y": -268.05954242117247,
			"strokeColor": "#1e1e1e",
			"backgroundColor": "#ffc9c9",
			"width": 58.5904714536849,
			"height": 27.274847401737482,
			"seed": 1544623683,
			"groupIds": [],
			"frameId": null,
			"roundness": null,
			"boundElements": [
				{
					"type": "text",
					"id": "smJjZ8gA"
				}
			],
			"updated": 1708071712578,
			"link": null,
			"locked": false
		},
		{
			"type": "text",
			"version": 102,
			"versionNonce": 1423338573,
			"isDeleted": false,
			"id": "smJjZ8gA",
			"fillStyle": "solid",
			"strokeWidth": 2,
			"strokeStyle": "solid",
			"roughness": 1,
			"opacity": 100,
			"angle": 0,
			"x": -269.40507229392904,
			"y": -262.31415524518945,
			"strokeColor": "#1e1e1e",
			"backgroundColor": "#ffc9c9",
			"width": 8.59542249613861,
			"height": 15.784073049771502,
			"seed": 2126206435,
			"groupIds": [],
			"frameId": null,
			"roundness": null,
			"boundElements": [],
			"updated": 1708071712578,
			"link": null,
			"locked": false,
			"fontSize": 12.6272584398172,
			"fontFamily": 1,
			"text": "3",
			"rawText": "3",
			"textAlign": "center",
			"verticalAlign": "middle",
			"containerId": "Bx5XYMa-K_9g02QtRyNib",
			"originalText": "3",
			"lineHeight": 1.25,
			"baseline": 11
		},
		{
			"type": "rectangle",
			"version": 92,
			"versionNonce": 222124717,
			"isDeleted": false,
			"id": "G97WrD9c7AkxnyH8jMpOm",
			"fillStyle": "solid",
			"strokeWidth": 2,
			"strokeStyle": "solid",
			"roughness": 1,
			"opacity": 100,
			"angle": 0,
			"x": -185.8081741902742,
			"y": -268.56466358703284,
			"strokeColor": "#1e1e1e",
			"backgroundColor": "transparent",
			"width": 30.305420255561284,
			"height": 26.264720676020534,
			"seed": 1027383683,
			"groupIds": [],
			"frameId": null,
			"roundness": {
				"type": 3
			},
			"boundElements": [],
			"updated": 1708071712578,
			"link": null,
			"locked": false
		},
		{
			"id": "IPbebtdNtOxPwe4YFQO1-",
			"type": "rectangle",
			"x": -305.861059887703,
			"y": -449.01920030356234,
			"width": 218.8000030517578,
			"height": 124.80000305175781,
			"angle": 0,
			"strokeColor": "transparent",
			"backgroundColor": "#ffc9c9",
			"fillStyle": "solid",
			"strokeWidth": 2,
			"strokeStyle": "solid",
			"roughness": 0,
			"opacity": 100,
			"groupIds": [],
			"frameId": null,
			"roundness": {
				"type": 3
			},
			"seed": 146097869,
			"version": 99,
			"versionNonce": 1591892877,
			"isDeleted": false,
			"boundElements": null,
			"updated": 1708071811866,
			"link": null,
			"locked": false
		},
		{
			"type": "rectangle",
			"version": 148,
			"versionNonce": 316759149,
			"isDeleted": true,
			"id": "G1Vla3c9_FYtKNORhu_XW",
			"fillStyle": "solid",
			"strokeWidth": 2,
			"strokeStyle": "solid",
			"roughness": 1,
			"opacity": 100,
			"angle": 0,
			"x": -308.54512237176397,
			"y": -433.729188565708,
			"strokeColor": "#1e1e1e",
			"backgroundColor": "#ffc9c9",
			"width": 174.76122983233586,
			"height": 100.48771283536507,
			"seed": 1546007075,
			"groupIds": [],
			"frameId": null,
			"roundness": {
				"type": 3
			},
			"boundElements": [],
			"updated": 1708071805825,
			"link": null,
			"locked": false
		},
		{
			"type": "rectangle",
			"version": 120,
			"versionNonce": 1008640941,
			"isDeleted": true,
			"id": "dA2llE2UIxTkaf9ITR4f5",
			"fillStyle": "solid",
			"strokeWidth": 2,
			"strokeStyle": "solid",
			"roughness": 0,
			"opacity": 100,
			"angle": 0,
			"x": -325.2131189264565,
			"y": -448.37681606296286,
			"strokeColor": "#1e1e1e",
			"backgroundColor": "#ffc9c9",
			"width": 526.3041356251144,
			"height": 273.7589860964377,
			"seed": 31129571,
			"groupIds": [],
			"frameId": null,
			"roundness": {
				"type": 3
			},
			"boundElements": [],
			"updated": 1708071798689,
			"link": null,
			"locked": false
		}
	],
	"appState": {
		"theme": "dark",
		"viewBackgroundColor": "#ffffff",
		"currentItemStrokeColor": "transparent",
		"currentItemBackgroundColor": "#ffc9c9",
		"currentItemFillStyle": "solid",
		"currentItemStrokeWidth": 2,
		"currentItemStrokeStyle": "solid",
		"currentItemRoughness": 0,
		"currentItemOpacity": 100,
		"currentItemFontFamily": 1,
		"currentItemFontSize": 20,
		"currentItemTextAlign": "left",
		"currentItemStartArrowhead": null,
		"currentItemEndArrowhead": "arrow",
		"scrollX": 429.1610572174149,
		"scrollY": 497.3754510665018,
		"zoom": {
			"value": 2
		},
		"currentItemRoundness": "round",
		"gridSize": null,
		"gridColor": {
			"Bold": "#C9C9C9FF",
			"Regular": "#EDEDEDFF"
		},
		"currentStrokeOptions": null,
		"previousGridSize": null,
		"frameRendering": {
			"enabled": true,
			"clip": true,
			"name": true,
			"outline": true
		}
	},
	"files": {}
}
```
%%
