SheepSupreme/AIAS/Dokumentationen/Ideen.md

# GUI
- [ ] Grafik für die Auslastung der Regale
![[Regalauslastung]]
