SheepSupreme/AIAS/Dokumentationen/AKS abstract.odt

# Zusammenfassung

Heutzutage sind komplexe Lagerhäuser in fast jedem großen Unternehmen die Norm. Mit dem Ziel den Gewinn zu maximieren, streben sie auf eine möglichst große Produktion und riesige Lagerhäuser zu. Dabei wird oft die Komplexität des laufendes Betriebes unterschätzt und es kommt zu teuren Fehlern. Das Automatisierte-Kommissionierungs-System (AKS) soll den Teil der Lagerung von versandbereiten Paketen automatisieren und vereinfachen. Die Lagerung erfolgt vertikal, wodurch mithilfe der Schwerkraft die Anzahl von beweglichen Komponenten reduziert wird. Die Ausgabe erfolgt halbautomatisch, kann allerdings bei Integration, von im Prozess später ablaufenden Anwendungen, vollautomatisiert werden. Das AKS verfügt über eine Statusanzeige und ein mit Live-Daten ausgestatteten User Interface (UI), dass den Operatoren einen genauen Einblick in den Ablauf des Systems und die Verzögerungen sowie die vorkommenden Fehler gibt.

# Abstract

Nowadays complex warehouses are a part of every big company. These companies increasingly desire their production sites to be as large as possible in order to maximize profit. This and the fact that the overall operation complexity increases with the size of the production site leads to costly problems that hinder the efficiency of the production process if not addressed with adequate measures. Automation systems do not only improve efficiency by reducing space needs and increasing the speed with which tasks can be performed, but also reduce cost in the long run. The Automated Commissioning System (ACS) aims to achieve these goals by offering an issue storage solution. Packages are stored inside of racks vertically, with the packages of greatest priority stored at the bottom. Packages are dispensed from the bottom of the rack by a motion system if commanded by an operator. The status of ACS and the ongoing processes gets updated in real time and is displayed on a Graphical User kInterface (GUI), which is part of the computer that runs the system.

# Problemstellung

Es soll ein System entwickelt werden, dass Pakete sortieren, lagern und bei Bedarf auswerfen kann. Das System soll aus einem Computerprogramm bestehen, dass für alle von dem System durchführbaren Funktionen besteht und die Durchführung dieser koordiniert. Das Hauptprogramm soll mit einem User-Interface ausgestattet sein, mit dem der Benützer auf den Ablauf des Programms Zugriff haben soll. Aufträge für den Auswurf von Paketen innerhalb einer bestimmten Zeit sollen im User-Interface erstellt werden. Diese Aufträge sollen vom Programm verarbeitet werden und es soll ein möglichst effizienter Programmablauf generiert werden der an den Benutzer weitergegeben werden soll.
