SheepSupreme/AIAS/Concept Art/Bewegungssystem.png

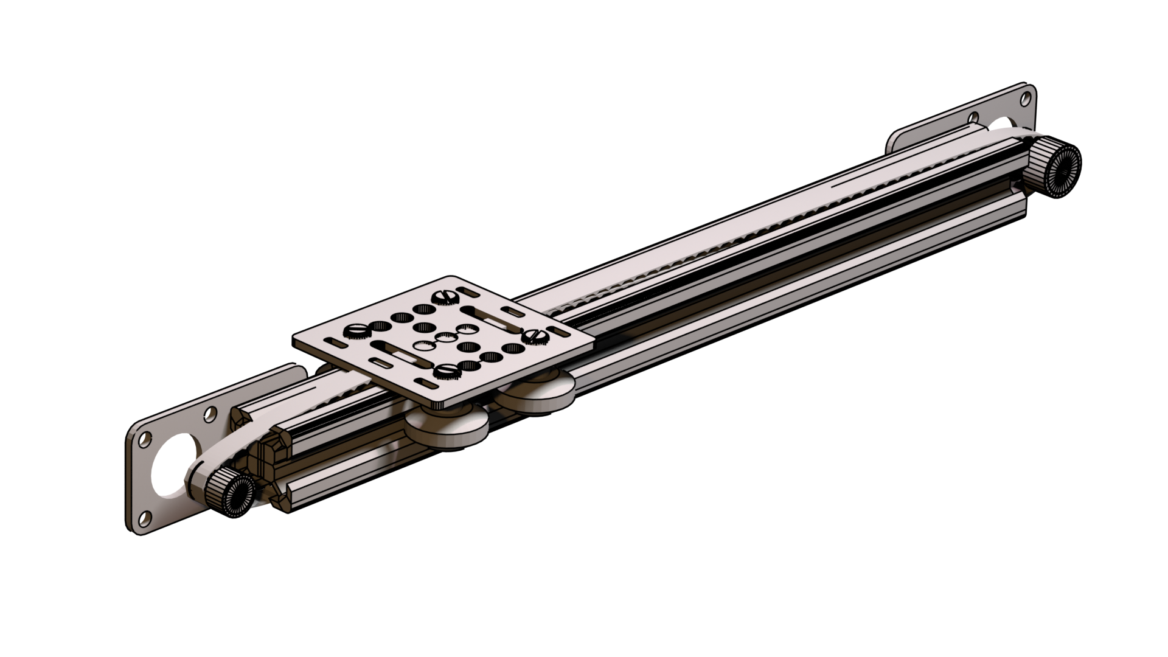
Concept Art/Bewegungssystem.png
