SheepSupreme/AIAS/Concept Art/Drücker.png

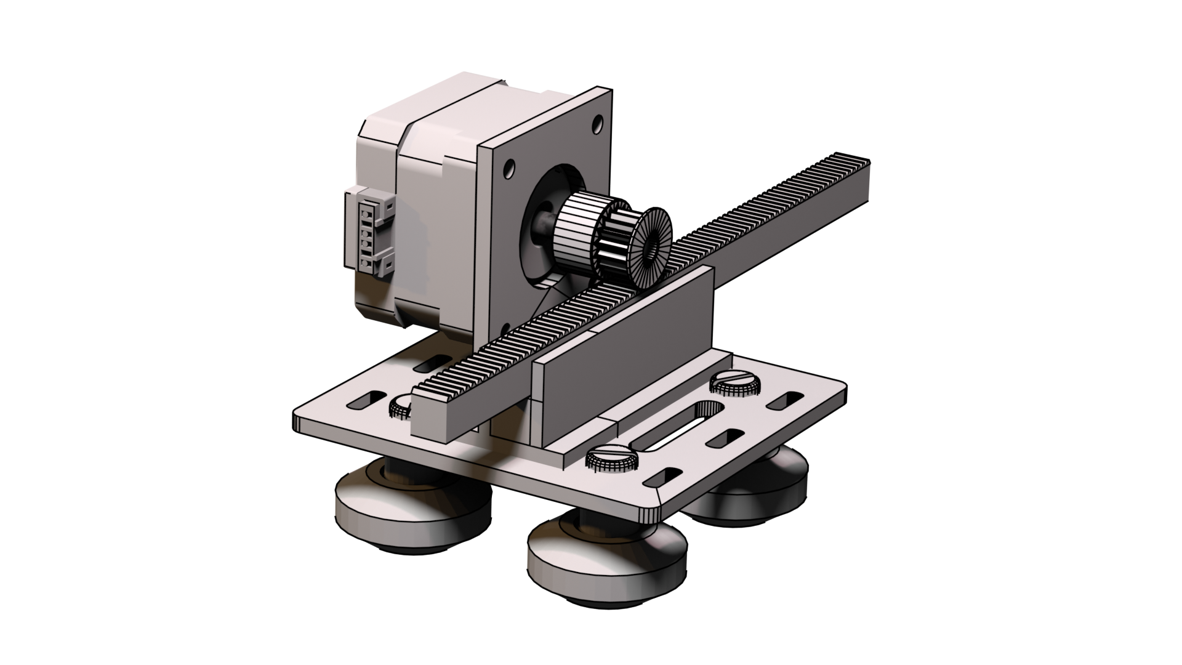
Concept Art/Drücker.png
