SheepSupreme/AIAS/Concept Art/NEMA17.png

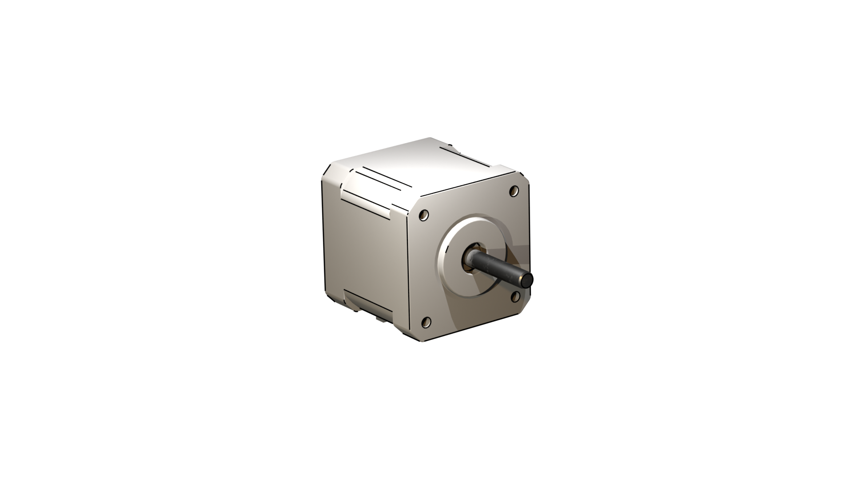
Concept Art/NEMA17.png
