SheepSupreme/AIAS/Concept Art/Plattform2.png

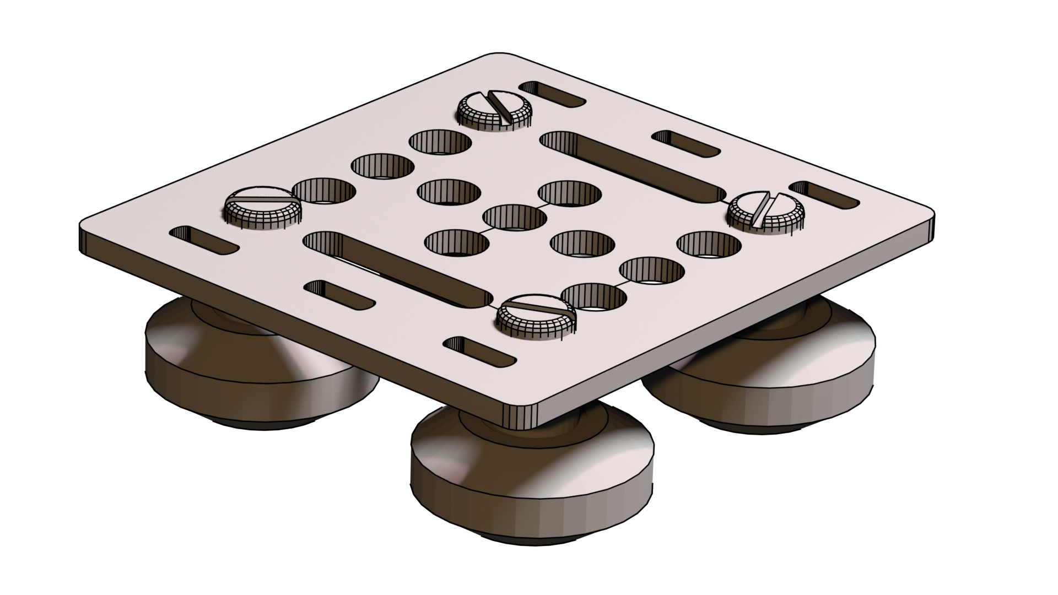
Concept Art/Plattform2.png
