SheepSupreme/AIAS/Concept Art/Plattform.png

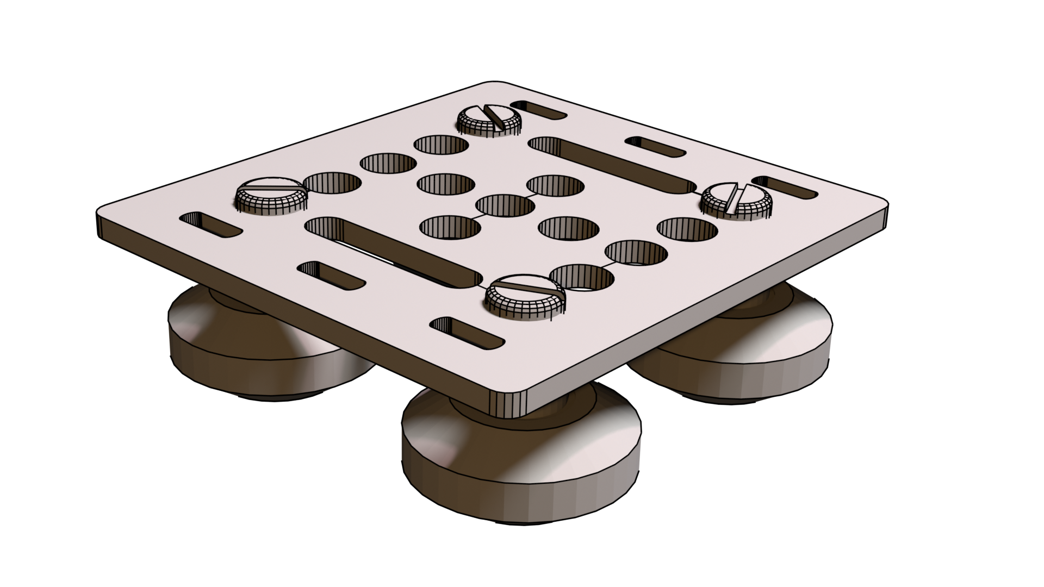
Concept Art/Plattform.png
