SheepSupreme/AIAS/Concept Art/V2.png

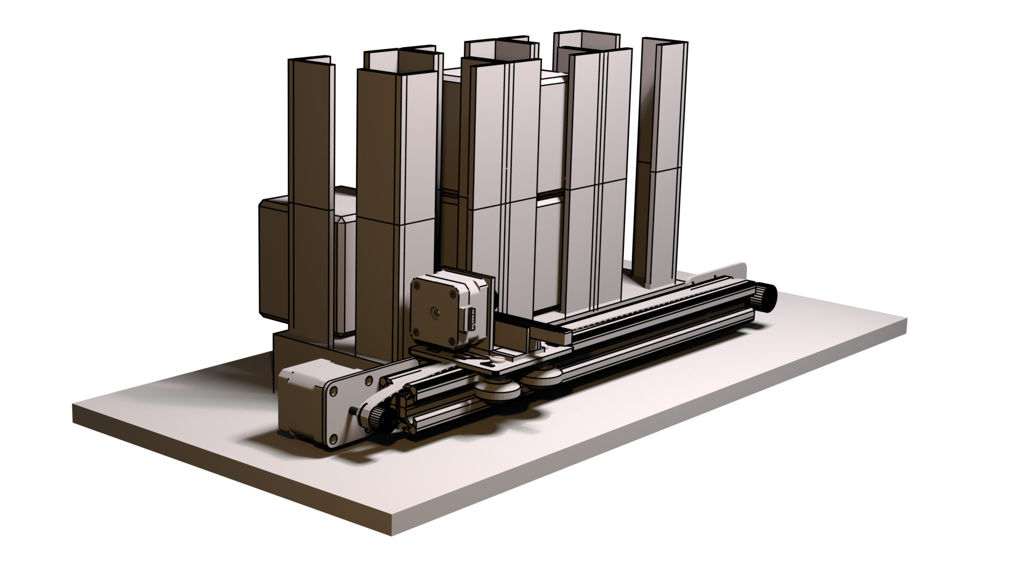
Concept Art/V2.png
