SheepSupreme/AIAS/Dokumentationen/bin/84515.jpg

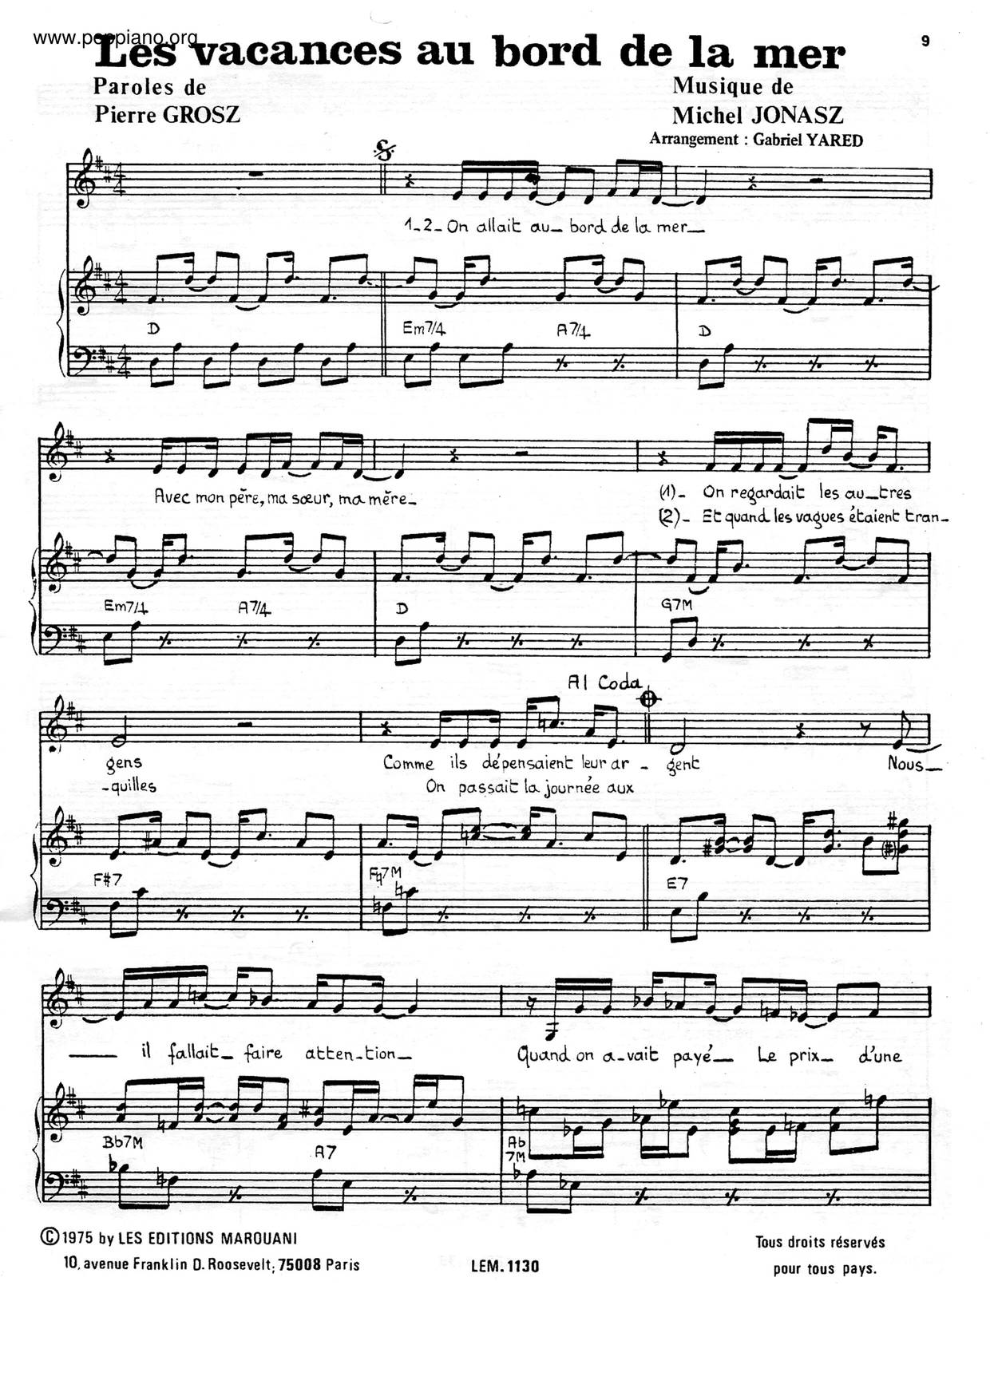
Dokumentationen/bin/84515.jpg
