SheepSupreme/AIAS/Dokumentationen/bin/Pflichtenheft.png

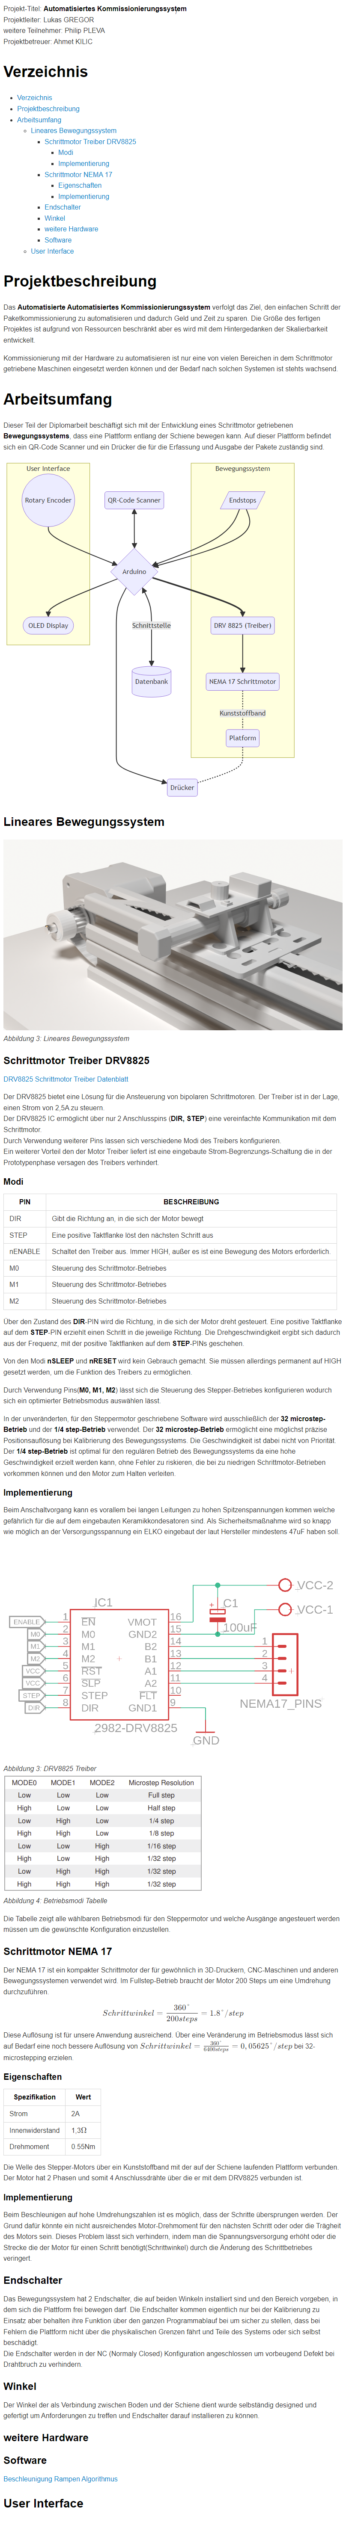
Dokumentationen/bin/Pflichtenheft.png
