SheepSupreme/AIAS/Eagle/AKS.png

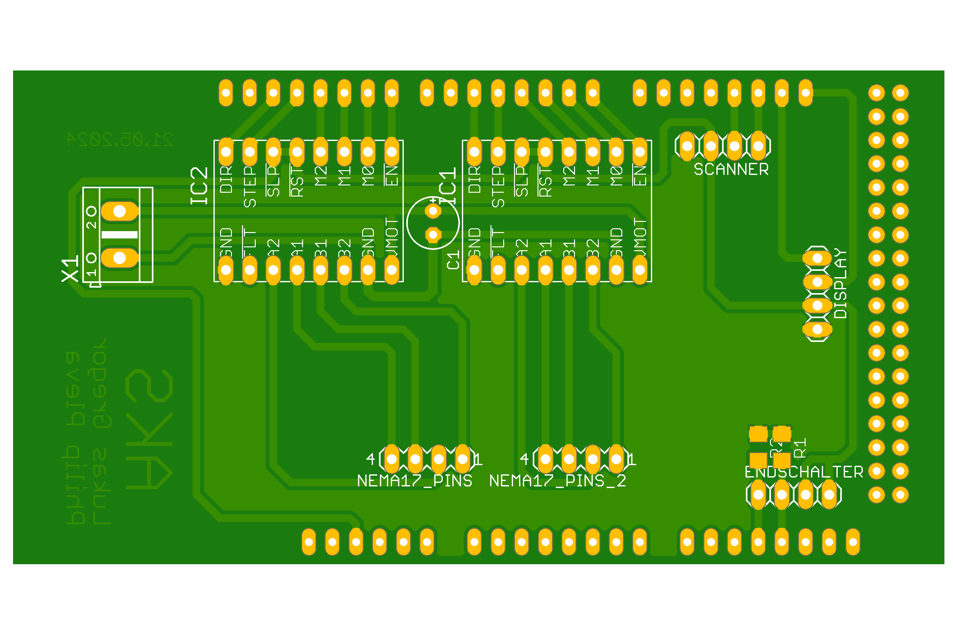
Eagle/AKS.png
