SheepSupreme/AIAS/Eagle/Druckvorlage.png

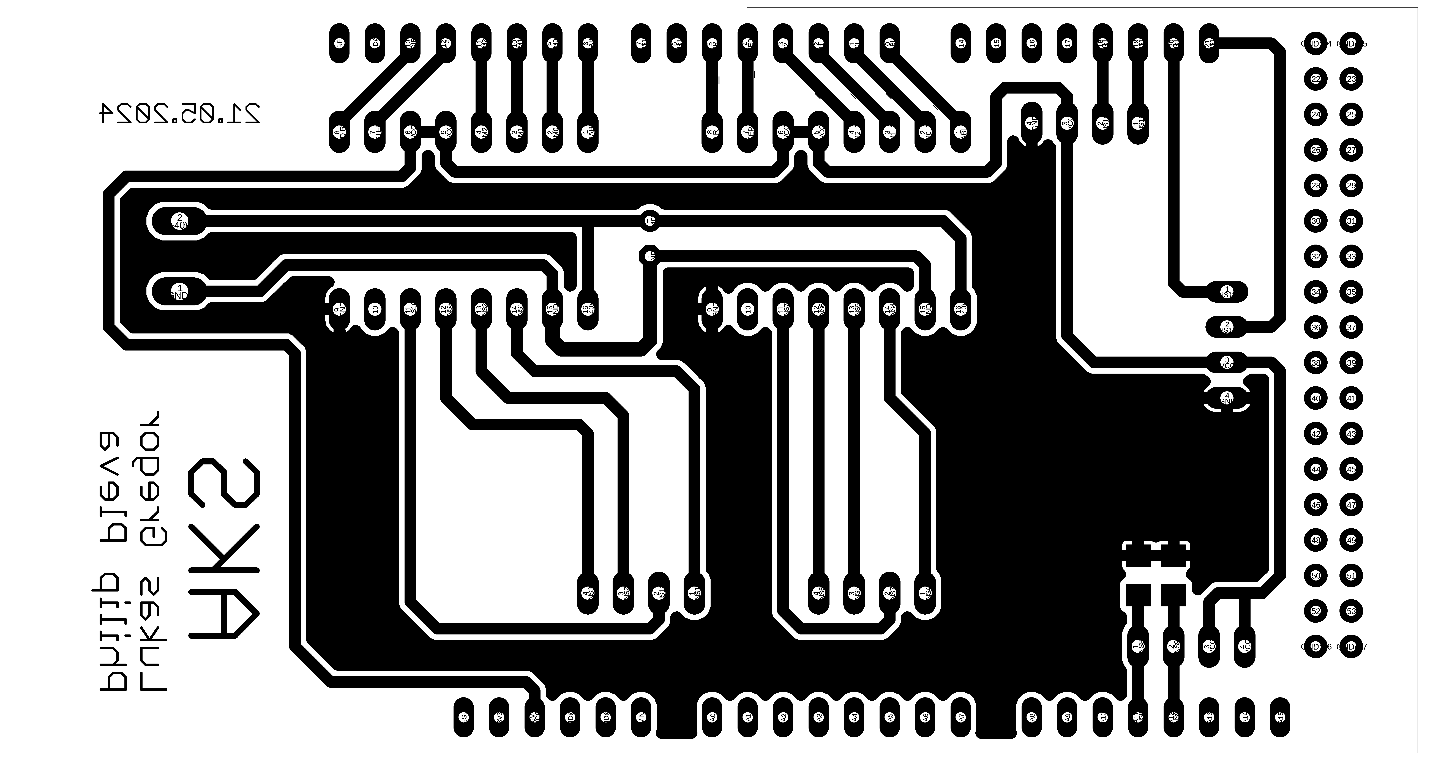
Eagle/Druckvorlage.png
