SheepSupreme/AIAS/Dokumentationen/bin/Bestellliste.xlsx

Bestellliste
Kosten Insgesamt: |  | 92.40 €
Bewegungs System:
Anzahl: | Name: | Link: | Kosten: | Eigenschaften: | Bestand:
1 | Mini Kabelbinder |  |  |  | Nein
1 | Riemenscheibe | https://www.amazon.de/YYWEi-Drucker-Riemenscheibe-Aluminium-Aluminium-Profilverbindung/dp/B08R6W9GLZ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 | 11.09 € |  | Ja
1 | Linsenflachkopfschraube M5 | https://www.constract.at/produkt/m5-x-6mm-linsenflachkopfschraube-verzinkt-10-stk/ | 0.36 € |  | Nein
1 | Nutenstein M5 | https://www.constract.at/produkt/nutenstein-m5-fuer-20x20mm-profil-1-stk/ | 0.36 € |  | Nein
1 | V-Slot 40x20mm 500mm | https://www.constract.at/produkt/profil-5-40x20mm-500mm-1-stk/ | 6.98 € |  | Nein
1 | V-Slot Montage Platte | https://www.constract.at/produkt/v-slot-montageplatte-gantry-plate-20mm-1-stk/ | 6.48 € |  | Nein
1 | V-Slot Nema 17 Mounting Plate | https://www.constract.at/produkt/nema-17-mount-plate-1-stk/ | 4.92 € |  | Nein
1 | V-Slot Idler pulley kit | https://www.constract.at/produkt/idler-pulley-kit-1-stk/ | 3.48 € |  | Nein
4 | V Wheels | https://www.constract.at/produkt/mini-solid-v-wheel-kit-1-stk/ | 2.76 € |  | Nein
4 | Aluminium Spacer 6mm | https://www.constract.at/produkt/aluminium-spacer-6mm-1-stk/ | 0.24 € |  | Nein
1 | Low profile 25mm screw M5 | https://www.constract.at/produkt/low-profile-screw-25mm-black-m5-10-stk/ | 1.80 € |  | Nein
4 | M3 6mm Pan head screws |  |  | Screw für Stepper | Nein
1 | Zahnriemen Satz | https://www.amazon.de/dp/B07XHRQ8H1?psc=1&ref=ppx_yo2ov_dt_b_product_details | 8.05 € |  | Nein
1 | NEMA 17 Stepper Motor | https://www.amazon.de/dp/B0B93HTR87?ref=ppx_yo2ov_dt_b_product_details&th=1 | 11.09 € |  | Ja
1 | DRV8825 Schrittmotor-Treiber | https://www.amazon.de/dp/B06Y2FX1VG?ref=ppx_yo2ov_dt_b_product_details&th=1 | 7.04 € |  | Ja
Auslesung des QR-Codes:
Anzahl: | Name: | Link: | Kosten: | Eigenschaften: | Bestand:
1 | GM865 | https://www.ebay.de/itm/355006953118?var=624282763740 | 20.39 € | QR-Code Scanner | Nein
User Interface:
Anzahl: | Name: | Link: | Kosten: | Eigenschaften: | Bestand:
1 | SSD1306 128x64 OLED Display | https://www.amazon.de/dp/B01L9GC470?ref=ppx_yo2ov_dt_b_product_details&th=1 | 7.36 € | OLED Display | Ja
