SheepSupreme/AIAS/3D/rack.stl

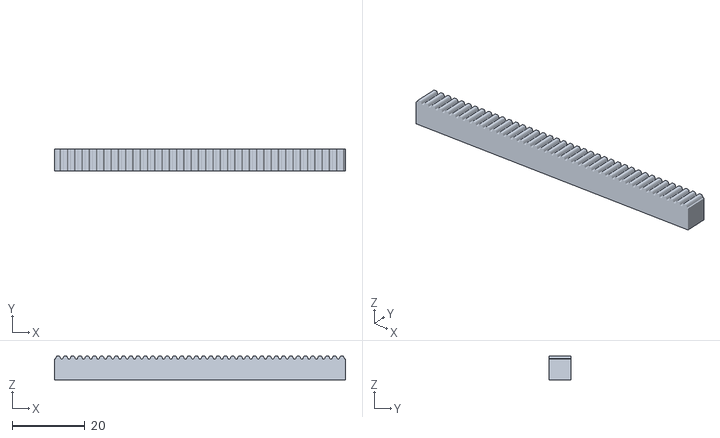
[picture p32: CAD file, 2024-04-22]
3D/rack.stl
80.0 x 6.00 x 6.52
