SheepSupreme/AIAS/Eagle/AKS.dxf

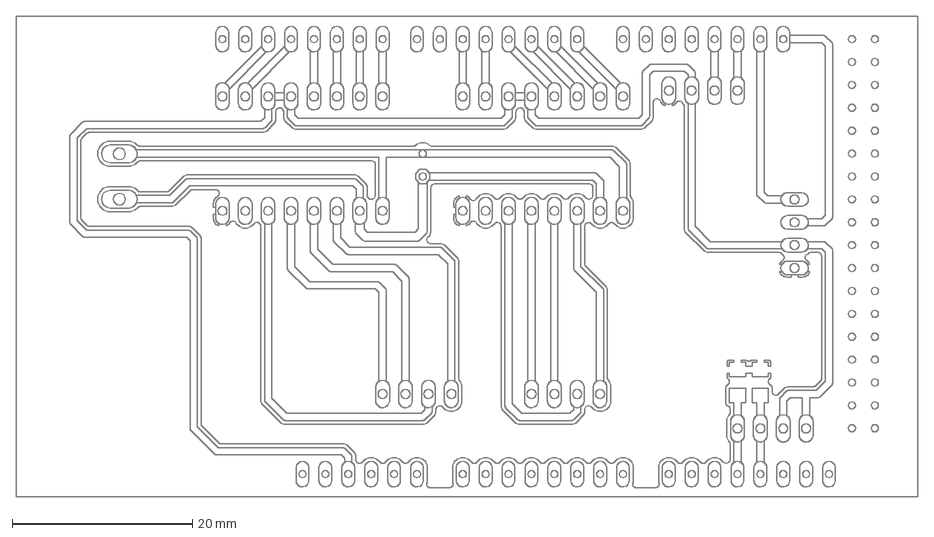
[picture p33: CAD file, 2024-05-22]
Eagle/AKS.dxf
100.0 x 53.4 mm
