SheepSupreme/AIAS/Eagle/test.png

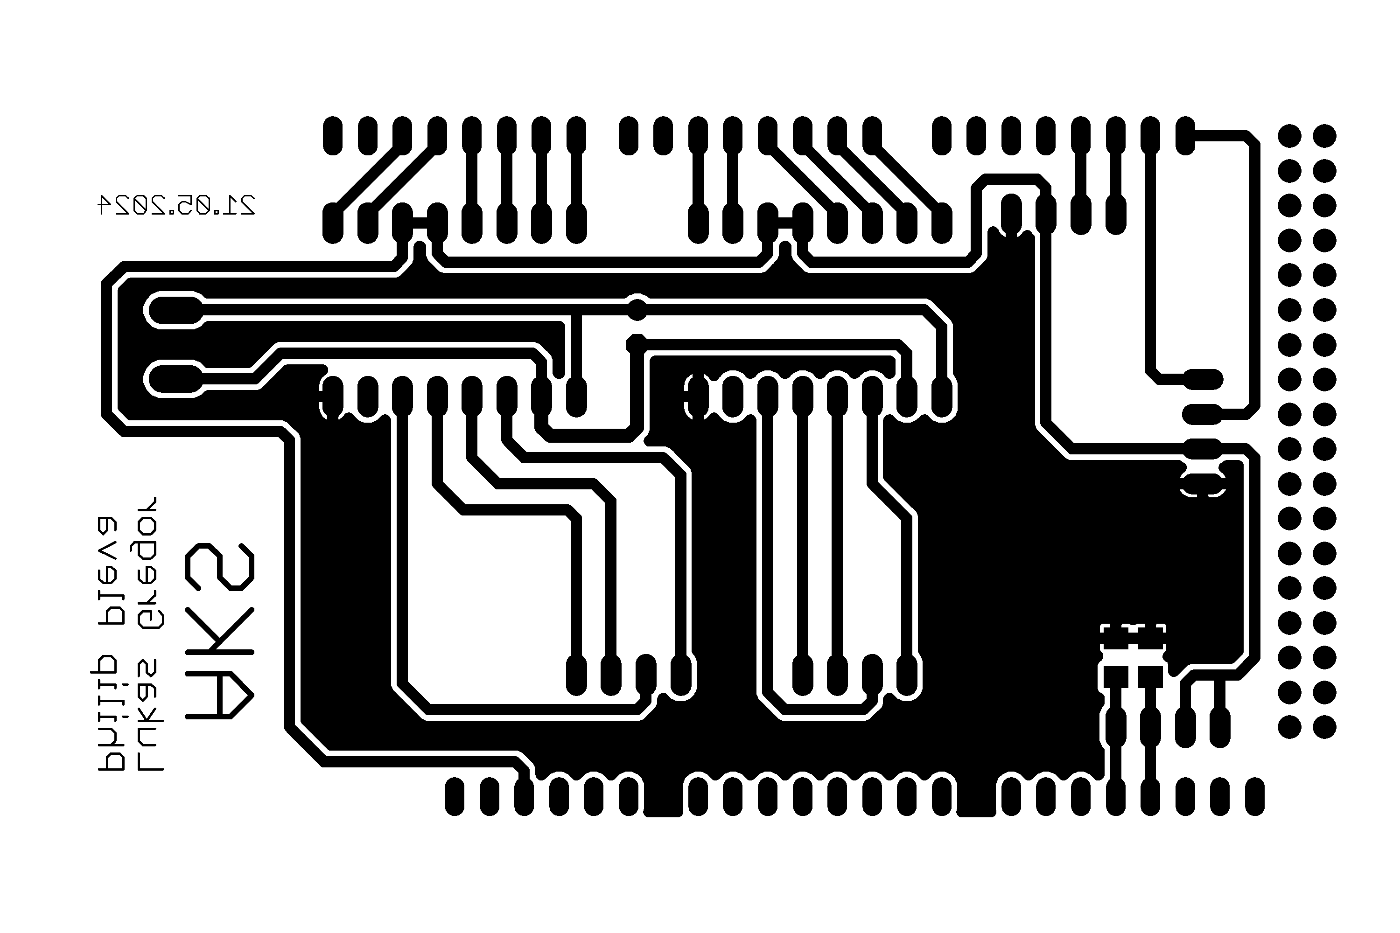
Eagle/test.png
