SheepSupreme/AIAS/Dokumentationen/Projekttagebuch AKS.xlsx

 | Projekttagebuch:
KW/Nr. | Datum | PLEVA P. | GREGOR L.
1 | 2023-09-08 | Planung, erste Konzepte | Planung, erste Konzepte
2 | 2023-09-15 | Aufsetzen des Datenbanksystem
3 | 2023-09-22 | Tests Kommunikation zur Datenbank
4 | 2023-09-29 | Vorstellungspräsentation | Vorstellungspräsentation
5 | 2023-10-06 | Planung des User Interfaces
6 | 2023-10-13 | Erstellung des Hauptprogramm (GUI)
7 | 2023-10-20 | Implementierung des Menü in der GUI
8 | 2023-10-27 | Herbstferien
9 | 2023-11-03 | Herbstferien
10 | 2023-11-10 | Planung des Dashboards
11 | 2023-11-17 | Implementierung der Tools im Dashboard
12 | 2023-11-24 | Planung des Inventory
13 | 2023-12-01 | Implementierung der Tools des Inventory
14 | 2023-12-08 | Maria Empfängnis
15 | 2023-12-15 | Planung des Add Packages
16 | 2023-12-22 | Implementierung der Tools des Add Packages
17 | 2023-12-29 | Weihnachtsferien
18 | 2024-01-05 | Weihnachtsferien
19 | 2024-01-12 | Serielle Schnittstelle Implementieren
20 | 2024-01-19 | Test der Seriellen Schnittstelle
21 | 2024-01-26 | Schnittstellen Protokoll erstellen
22 | 2024-02-02 | Entfall
23 | 2024-02-09 | Semesterferien
24 | 2024-02-16 | Implementierung Erstellen von neuen Paketen
25 | 2024-02-23 | Implementierung der Funktion zur Verlagerung der Pakete in das Ausgabesystem
26 | 2024-03-01 | Testen der Paketverlagerung
27 | 2024-03-08 | Implementierung der Ausgabe der Pakete
28 | 2024-03-15 | Test der Ausgabe
29 | 2024-03-22 | Verbesserung der GUI
30 | 2024-03-29 | Osterferien
31 | 2024-04-05 | Osterferien
32 | 2024-04-12 | Test und Validierung des Gesamtprojekts | Test und Validierung des Gesamtprojekts
33 | 2024-04-19 | Dokumentation Diplomarbeit
34 | 2024-04-26 | Erweiterung Dokumentation
