SheepSupreme/AIAS/Eagle/AKS Druckvorlage.pdf

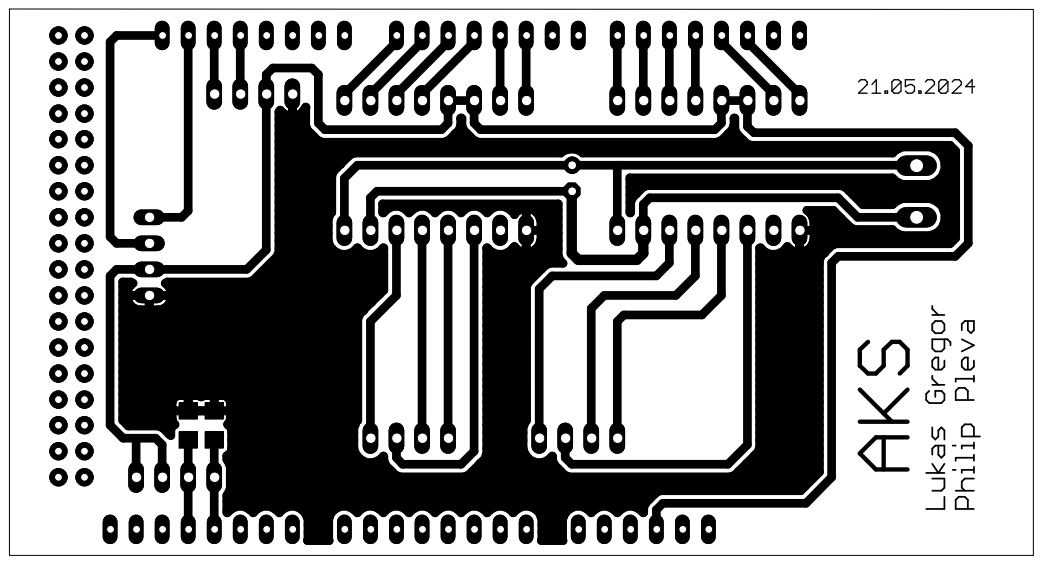
[picture p35: page 1]
