SheepSupreme/AIAS/sketch_jan10a/wokwi/stepper.cpp

#include "stepper.h"

volatile bool Stepper::_interrupt = false;

Stepper::Stepper(uint8_t pin_dir = 2, uint8_t pin_step = 3, uint8_t pin_nEnable = 4, uint8_t pin_M0 = 5, uint8_t pin_M1 = 6, uint8_t pin_M2 =7){
    step_pin = pin_step;
    direction_pin = pin_dir;
    nEnable_pin = pin_nEnable;
    M0 = pin_M0;
    M1 = pin_M1;
    M2 = pin_M2;
    _speed = 200;
    _accel = 200;

    pinMode(step_pin,OUTPUT);
    digitalWrite(step_pin,LOW);
    pinMode(direction_pin,OUTPUT);
    digitalWrite(direction_pin,LOW);

    pinMode(endstop1_pin, INPUT_PULLUP);
    pinMode(endstop2_pin, INPUT_PULLUP);
    attachInterrupt(digitalPinToInterrupt(endstop1_pin),endstop_trigger,FALLING);
    attachInterrupt(digitalPinToInterrupt(endstop2_pin),endstop_trigger,FALLING);
}

void Stepper::change_microstep_resolution(short int resolution)
{
    _microstep_resolution = microstep_table[resolution][3];
    digitalWrite(M0, microstep_table[resolution][0]);
    digitalWrite(M1, microstep_table[resolution][1]);
    digitalWrite(M2, microstep_table[resolution][2]);
}

void Stepper::change_profile(int speed, int accel)
{
    _speed = speed;
    _accel = accel;
}

void Stepper::calibration_direction(unsigned int endstop_offset, int direction, bool home, double max_calibration_travel)
{   
    move_relative(direction*max_calibration_travel); //move towards the endstop
    delay(2);
    move_relative(direction*endstop_offset*_microstep_resolution); //move away from endstop (endstop_offset in [Fullstep distance])
    if (home){
        _current_position = 0;
    }
    else{
        endstop_position = _current_position;
    }
}


void Stepper::calibration(unsigned int endstop_offset)
{   

    _speed = _speed_calibration;

    calibration_direction(endstop_offset, -1, true, 1E8);

    calibration_direction(endstop_offset, 1, false, 1E8);
}

void Stepper::setup_move(int absolute_pos)
{
    absolute_position = absolute_pos;
    // first period in US
    this_move_period = 1000000.0/sqrt(2.0*_accel);
    running_period_US = 1000000.0/_speed;
    deceleration_distance = (_speed*_speed)/(2.0*_accel);

    relative_distance = absolute_position - _current_position; //Investigate
    if (relative_distance < 0){
        _dir = -1;
    }
    else if(relative_distance > 0){
        _dir = 1;
    }

    if (abs(relative_distance)/2 < deceleration_distance){
        deceleration_distance = abs(relative_distance)/2;
    }
    new_move = true;
}




void Stepper::move_relative(double relative_steps)
{
    setup_move(_current_position + relative_steps);
    digitalWrite(nEnable_pin,LOW);
    while(!move()){
        // Serial.print(_current_position);
        // Serial.print("   ");
        // Serial.print(this_move_period);
        // Serial.print("   ");
        // Serial.println(deceleration_distance);
    }
    digitalWrite(nEnable_pin,HIGH);
}

void Stepper::endstop_trigger()
{
    if(digitalRead(endstop1_pin) == LOW || digitalRead(endstop2_pin == LOW)){
        _interrupt = true;
    }
}

bool Stepper::move()
{
    unsigned int period_last_step;
    unsigned int current_time_US;
    unsigned int distance_2_target;

    digitalWrite(direction_pin,max(0,_dir));

    if(_interrupt){
        _interrupt = false;
        return true;
    }

    if(new_move){
        multiplier = 1;
        last_move_time_US = micros();
        new_move = false;
    }
    current_time_US = micros();
    period_last_step = current_time_US - last_move_time_US;

    if(period_last_step < this_move_period){
        return false;
    }
    last_move_time_US = micros();

    distance_2_target = abs(absolute_position - _current_position);

    if(distance_2_target == deceleration_distance){
        multiplier = -1;
    }
    if(this_move_period < running_period_US){
        this_move_period = running_period_US;
        multiplier = 0;
    }

    
    digitalWrite(step_pin,HIGH);
    delayMicroseconds(2);
    this_move_period = this_move_period*(1.0-multiplier*(_accel/1E12)*this_move_period*this_move_period);
    _current_position = _current_position + _dir;

    digitalWrite(step_pin,LOW);

    last_move_time_US = current_time_US;

    if(_current_position == absolute_position)
    {   
        return true;
    }
    return false;
}
