SheepSupreme/AIAS/(commit log)

2023-09-08 Erstellung der Projektbeschreibung
2023-09-09 Ideen Ordner gelöscht und Beschreibung geschrieben
2023-09-11 arduino code upload
2023-09-14 Eagle Schematic V1.0
    [AKS.sch]
2023-09-15 Bestellliste hinzugefügt
    [Bestellliste.xlsx]
2023-09-22 Arduino Code hinzugefügt
2024-01-13 Stepper library funktioniert :)
2024-01-14 pflichtenheft endstop
2024-01-16 timer interrupts finally work
2024-01-16 calibration rework
2024-01-25 stepper_modi implementation
2024-02-07 vault backup: 2024-02-07 01:27:55
    [Bestellliste.xlsx]
2024-02-11 vault backup: 2024-02-11 12:15:35
    [Bestellliste.xlsx]
2024-02-22 Aufteilung des Programmes
